Maritime-Hacking-Village/Badge-2025/firmware/firmware/assets/puke.gif

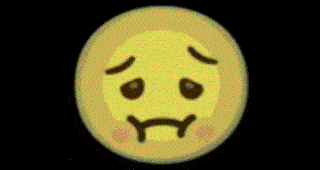
firmware/firmware/assets/puke.gif
