Maritime-Hacking-Village/Badge-2025/software/CAN_decoder.png

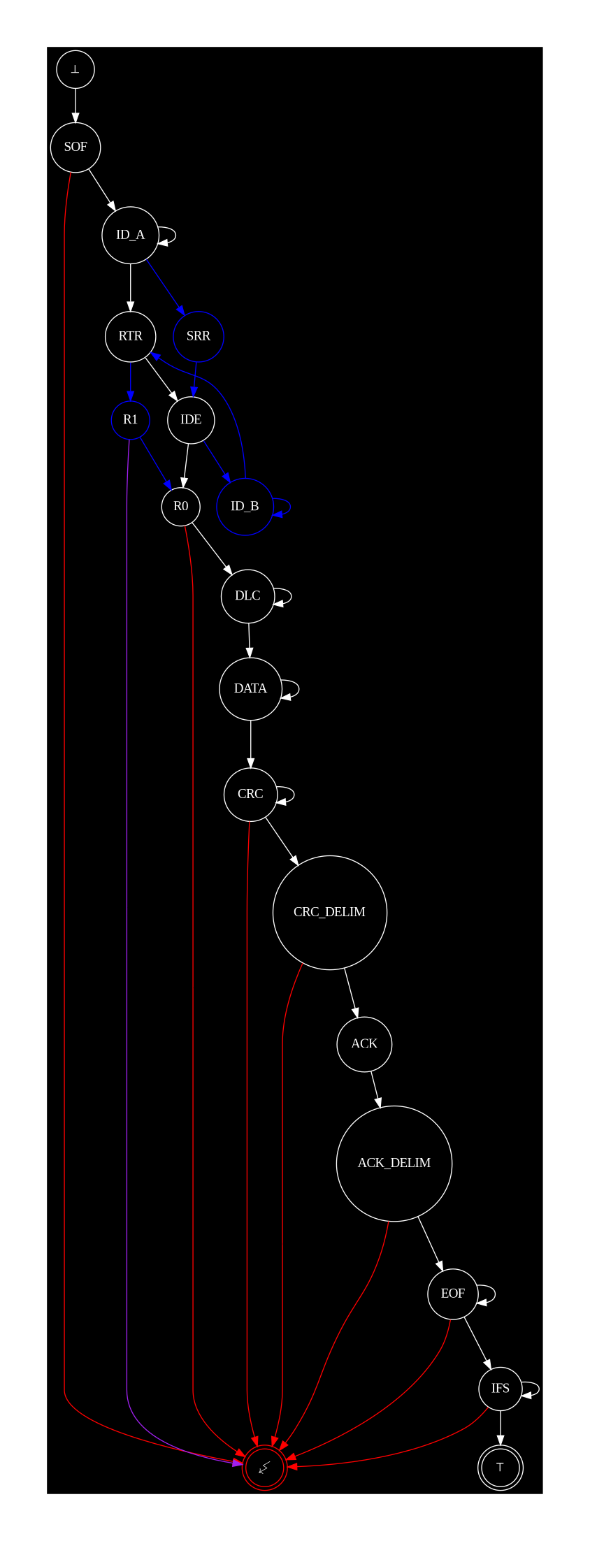
software/CAN_decoder.png
