Maritime-Hacking-Village/Badge-2025/KiCAD/DC33/fields2.xlsx

Refs | Color | Datasheet | Description | Footprint | Height | Label | Manufacturer | Manufacturer Part Number | Package | Power | Tolerance | Value
C1 |  | https://datasheets.kyocera-avx.com/KGM_X7R.pdf | CAP CER 0.1UF 25V X7R 0603 | Capacitor_SMD:C_0603_1608Metric |  |  | KYOCERA AVX | KGM15BR71E104KT | 0603 |  |  | 0.1uF
C10 |  | https://datasheets.kyocera-avx.com/KGM_X7R.pdf | CAP CER 0.1UF 25V X7R 0603 | Capacitor_SMD:C_0603_1608Metric |  |  | KYOCERA AVX | KGM15BR71E104KT | 0603 |  |  | 0.1uF
C11 |  | https://search.murata.co.jp/Ceramy/image/img/A01X/G101/ENG/GRM188R61E106MA73-01.pdf | CAP CER 10UF 25V X5R 0603 | Capacitor_SMD:C_0603_1608Metric |  |  | Murata Electronics | GRM188R61E106MA73J | 0603 |  |  | 10uF
C13 |  | https://product.tdk.com/system/files/dam/doc/product/capacitor/ceramic/mlcc/catalog/mlcc_automotive_general_en.pdf | CAP CER 4.7UF 6.3V X5R 0603 | Capacitor_SMD:C_0603_1608Metric |  |  | TDK Corporation | CGA3E1X5R0J475K080AC | 0603 |  |  | 4.7uF
C14 |  | https://datasheets.kyocera-avx.com/KGM_X7R.pdf | CAP CER 0.1UF 25V X7R 0603 | Capacitor_SMD:C_0603_1608Metric |  |  | KYOCERA AVX | KGM15BR71E104KT | 0603 |  |  | 0.1uF
C15 |  | https://search.murata.co.jp/Ceramy/image/img/A01X/G101/ENG/GRM188R61E106MA73-01.pdf | CAP CER 10UF 25V X5R 0603 | Capacitor_SMD:C_0603_1608Metric |  |  | Murata Electronics | GRM188R61E106MA73J | 0603 |  |  | 10uF
C16 |  | https://search.murata.co.jp/Ceramy/image/img/A01X/G101/ENG/GRM188R61E106MA73-01.pdf | CAP CER 10UF 25V X5R 0603 | Capacitor_SMD:C_0603_1608Metric |  |  | Murata Electronics | GRM188R61E106MA73J | 0603 |  |  | 10uF
C17 |  | https://www.yageo.com/upload/media/product/productsearch/datasheet/mlcc/UPY-GPHC_X7R_6.3V-to-250V_24.pdf | CAP CER 1UF 50V X7R 0603 | Capacitor_SMD:C_0603_1608Metric |  |  | Yageo | CC0603KRX7R9BB105 | 0603 |  |  | 1uF
C18 |  | https://datasheets.kyocera-avx.com/KGM_X7R.pdf | CAP CER 0.1UF 25V X7R 0603 | Capacitor_SMD:C_0603_1608Metric |  |  | KYOCERA AVX | KGM15BR71E104KT | 0603 |  |  | 0.1uF
C19 |  | https://www.yageo.com/upload/media/product/productsearch/datasheet/mlcc/UPY-GPHC_X7R_6.3V-to-250V_24.pdf | CAP CER 1UF 50V X7R 0603 | Capacitor_SMD:C_0603_1608Metric |  |  | Yageo | CC0603KRX7R9BB105 | 0603 |  |  | 1uF
C2 |  | https://datasheets.kyocera-avx.com/KGM_X7R.pdf | CAP CER 0.1UF 25V X7R 0603 | Capacitor_SMD:C_0603_1608Metric |  |  | KYOCERA AVX | KGM15BR71E104KT | 0603 |  |  | 0.1uF
C20 |  | https://www.yageo.com/upload/media/product/productsearch/datasheet/mlcc/UPY-GPHC_X7R_6.3V-to-250V_24.pdf | CAP CER 1UF 50V X7R 0603 | Capacitor_SMD:C_0603_1608Metric |  |  | Yageo | CC0603KRX7R9BB105 | 0603 |  |  | 1uF
C21 |  | https://www.yageo.com/upload/media/product/productsearch/datasheet/mlcc/UPY-GPHC_X7R_6.3V-to-250V_24.pdf | CAP CER 1UF 50V X7R 0603 | Capacitor_SMD:C_0603_1608Metric |  |  | Yageo | CC0603KRX7R9BB105 | 0603 |  |  | 1uF
C22 |  | https://www.yageo.com/upload/media/product/productsearch/datasheet/mlcc/UPY-GPHC_X7R_6.3V-to-250V_24.pdf | CAP CER 1UF 50V X7R 0603 | Capacitor_SMD:C_0603_1608Metric |  |  | Yageo | CC0603KRX7R9BB105 | 0603 |  |  | 1uF
C23 |  | https://search.murata.co.jp/Ceramy/image/img/A01X/G101/ENG/GRM188R61E106MA73-01.pdf | CAP CER 10UF 25V X5R 0603 | Capacitor_SMD:C_0603_1608Metric |  |  | Murata Electronics | GRM188R61E106MA73J | 0603 |  |  | 10uF
C24 |  | https://search.murata.co.jp/Ceramy/image/img/A01X/G101/ENG/GRM188R61E106MA73-01.pdf | CAP CER 10UF 25V X5R 0603 | Capacitor_SMD:C_0603_1608Metric |  |  | Murata Electronics | GRM188R61E106MA73J | 0603 |  |  | 10uF
C25 |  | https://datasheets.kyocera-avx.com/cx5r-KGM.pdf | CAP CER 47UF 6.3V X5R 0603 | Capacitor_SMD:C_0603_1608Metric |  |  | KYOCERA AVX | 06036D476MAT2A | 0603 |  |  | 47uF
C26 |  | https://datasheets.kyocera-avx.com/KGM_X7R.pdf | CAP CER 0.1UF 25V X7R 0603 | Capacitor_SMD:C_0603_1608Metric |  |  | KYOCERA AVX | KGM15BR71E104KT | 0603 |  |  | 0.1uF
C27 |  | https://datasheets.kyocera-avx.com/KGM_X7R.pdf | CAP CER 0.1UF 25V X7R 0603 | Capacitor_SMD:C_0603_1608Metric |  |  | KYOCERA AVX | KGM15BR71E104KT | 0603 |  |  | 0.1uF
C28 |  | https://www.yageo.com/upload/media/product/productsearch/datasheet/mlcc/UPY-GPHC_X7R_6.3V-to-250V_24.pdf | CAP CER 1UF 50V X7R 0603 | Capacitor_SMD:C_0603_1608Metric |  |  | Yageo | CC0603KRX7R9BB105 | 0603 |  |  | 1uF
C29 |  | https://www.yageo.com/upload/media/product/productsearch/datasheet/mlcc/UPY-GPHC_X7R_6.3V-to-250V_24.pdf | CAP CER 1UF 50V X7R 0603 | Capacitor_SMD:C_0603_1608Metric |  |  | Yageo | CC0603KRX7R9BB105 | 0603 |  |  | 1uF
C3 |  | https://datasheets.kyocera-avx.com/KGM_X7R.pdf | CAP CER 0.1UF 25V X7R 0603 | Capacitor_SMD:C_0603_1608Metric |  |  | KYOCERA AVX | KGM15BR71E104KT | 0603 |  |  | 0.1uF
C30 |  | https://datasheets.kyocera-avx.com/KGM_X7R.pdf | CAP CER 0.1UF 25V X7R 0603 | Capacitor_SMD:C_0603_1608Metric |  |  | KYOCERA AVX | KGM15BR71E104KT | 0603 |  |  | 0.1uF
C32 |  | https://www.yageo.com/upload/media/product/productsearch/datasheet/mlcc/UPY-GPHC_X7R_6.3V-to-250V_24.pdf | CAP CER 1UF 50V X7R 0603 | Capacitor_SMD:C_0603_1608Metric |  |  | Yageo | CC0603KRX7R9BB105 | 0603 |  |  | 1uF
C33 |  | https://datasheets.kyocera-avx.com/KGM_X7R.pdf | CAP CER 0.1UF 25V X7R 0603 | Capacitor_SMD:C_0603_1608Metric |  |  | KYOCERA AVX | KGM15BR71E104KT | 0603 |  |  | 0.1uF
C34 |  | https://www.yageo.com/en/Chart/Download/pdf/CC0603JPNPO9BN220 | CAP CER 22PF 50V C0G/NPO 0603 | Capacitor_SMD:C_0603_1608Metric |  |  | Yageo | CC0603JPNPO9BN220 | 0603 |  |  | 22pF
C35 |  | https://datasheets.kyocera-avx.com/KGM_X7R.pdf | CAP CER 0.1UF 25V X7R 0603 | Capacitor_SMD:C_0603_1608Metric |  |  | KYOCERA AVX | KGM15BR71E104KT | 0603 |  |  | 0.1uF
C36 |  | https://datasheets.kyocera-avx.com/KGM_X7R.pdf | CAP CER 0.1UF 25V X7R 0603 | Capacitor_SMD:C_0603_1608Metric |  |  | KYOCERA AVX | KGM15BR71E104KT | 0603 |  |  | 0.1uF
C37 |  | https://datasheets.kyocera-avx.com/KGM_X7R.pdf | CAP CER 0.1UF 25V X7R 0603 | Capacitor_SMD:C_0603_1608Metric |  |  | KYOCERA AVX | KGM15BR71E104KT | 0603 |  |  | 0.1uF
C39 |  | https://datasheets.kyocera-avx.com/KGM_X7R.pdf | CAP CER 0.1UF 25V X7R 0603 | Capacitor_SMD:C_0603_1608Metric |  |  | KYOCERA AVX | KGM15BR71E104KT | 0603 |  |  | 0.1uF
C4 |  | https://datasheets.kyocera-avx.com/KGM_X7R.pdf | CAP CER 0.1UF 25V X7R 0603 | Capacitor_SMD:C_0603_1608Metric |  |  | KYOCERA AVX | KGM15BR71E104KT | 0603 |  |  | 0.1uF
C40 |  | https://datasheets.kyocera-avx.com/KGM_X7R.pdf | CAP CER 0.1UF 25V X7R 0603 | Capacitor_SMD:C_0603_1608Metric |  |  | KYOCERA AVX | KGM15BR71E104KT | 0603 |  |  | 0.1uF
C42 |  | https://datasheets.kyocera-avx.com/KGM_X7R.pdf | CAP CER 0.1UF 25V X7R 0603 | Capacitor_SMD:C_0603_1608Metric |  |  | KYOCERA AVX | KGM15BR71E104KT | 0603 |  |  | 0.1uF
C43 |  | https://datasheets.kyocera-avx.com/KGM_X7R.pdf | CAP CER 0.1UF 25V X7R 0603 | Capacitor_SMD:C_0603_1608Metric |  |  | KYOCERA AVX | KGM15BR71E104KT | 0603 |  |  | 0.1uF
C44 |  | https://www.yageo.com/upload/media/product/productsearch/datasheet/mlcc/UPY-GPHC_X7R_6.3V-to-250V_24.pdf | CAP CER 1UF 50V X7R 0603 | Capacitor_SMD:C_0603_1608Metric |  |  | Yageo | CC0603KRX7R9BB105 | 0603 |  |  | 1uF
C45 |  | https://datasheets.kyocera-avx.com/KGM_X7R.pdf | CAP CER 0.1UF 25V X7R 0603 | Capacitor_SMD:C_0603_1608Metric |  |  | KYOCERA AVX | KGM15BR71E104KT | 0603 |  |  | 0.1uF
C46 |  | https://www.yageo.com/upload/media/product/productsearch/datasheet/mlcc/UPY-GPHC_X7R_6.3V-to-250V_24.pdf | CAP CER 1UF 50V X7R 0603 | Capacitor_SMD:C_0603_1608Metric |  |  | Yageo | CC0603KRX7R9BB105 | 0603 |  |  | 1uF
C47 |  | https://datasheets.kyocera-avx.com/KGM_X7R.pdf | CAP CER 0.1UF 25V X7R 0603 | Capacitor_SMD:C_0603_1608Metric |  |  | KYOCERA AVX | KGM15BR71E104KT | 0603 |  |  | 0.1uF
C48 |  | https://datasheets.kyocera-avx.com/KGM_X7R.pdf | CAP CER 0.1UF 25V X7R 0603 | Capacitor_SMD:C_0603_1608Metric |  |  | KYOCERA AVX | KGM15BR71E104KT | 0603 |  |  | 0.1uF
C49 |  | https://www.yageo.com/upload/media/product/productsearch/datasheet/mlcc/UPY-GPHC_X7R_6.3V-to-250V_24.pdf | CAP CER 1UF 50V X7R 0603 | Capacitor_SMD:C_0603_1608Metric |  |  | Yageo | CC0603KRX7R9BB105 | 0603 |  |  | 1uF
C5 |  | https://datasheets.kyocera-avx.com/KGM_X7R.pdf | CAP CER 0.1UF 25V X7R 0603 | Capacitor_SMD:C_0603_1608Metric |  |  | KYOCERA AVX | KGM15BR71E104KT | 0603 |  |  | 0.1uF
C50 |  | https://www.yageo.com/upload/media/product/productsearch/datasheet/mlcc/UPY-GPHC_X7R_6.3V-to-250V_24.pdf | CAP CER 1UF 50V X7R 0603 | Capacitor_SMD:C_0603_1608Metric |  |  | Yageo | CC0603KRX7R9BB105 | 0603 |  |  | 1uF
C51 |  | https://datasheets.kyocera-avx.com/KGM_X7R.pdf | CAP CER 0.1UF 25V X7R 0603 | Capacitor_SMD:C_0603_1608Metric |  |  | KYOCERA AVX | KGM15BR71E104KT | 0603 |  |  | 0.1uF
C52 |  | https://datasheets.kyocera-avx.com/KGM_X7R.pdf | CAP CER 0.1UF 25V X7R 0603 | Capacitor_SMD:C_0603_1608Metric |  |  | KYOCERA AVX | KGM15BR71E104KT | 0603 |  |  | 0.1uF
C53 |  | https://www.yageo.com/upload/media/product/productsearch/datasheet/mlcc/UPY-GPHC_X7R_6.3V-to-250V_24.pdf | CAP CER 1UF 50V X7R 0603 | Capacitor_SMD:C_0603_1608Metric |  |  | Yageo | CC0603KRX7R9BB105 | 0603 |  |  | 1uF
C54 |  | https://www.yageo.com/upload/media/product/productsearch/datasheet/mlcc/UPY-GPHC_X7R_6.3V-to-250V_24.pdf | CAP CER 1UF 50V X7R 0603 | Capacitor_SMD:C_0603_1608Metric |  |  | Yageo | CC0603KRX7R9BB105 | 0603 |  |  | 1uF
C55 |  | https://datasheets.kyocera-avx.com/KGM_X7R.pdf | CAP CER 0.1UF 25V X7R 0603 | Capacitor_SMD:C_0603_1608Metric |  |  | KYOCERA AVX | KGM15BR71E104KT | 0603 |  |  | 0.1uF
C56 |  | https://www.yageo.com/upload/media/product/productsearch/datasheet/mlcc/UPY-GPHC_X7R_6.3V-to-250V_24.pdf | CAP CER 1UF 50V X7R 0603 | Capacitor_SMD:C_0603_1608Metric |  |  | Yageo | CC0603KRX7R9BB105 | 0603 |  |  | 1uF
C57 |  | https://search.murata.co.jp/Ceramy/image/img/A01X/G101/ENG/GRM188R61E106MA73-01.pdf | CAP CER 10UF 25V X5R 0603 | Capacitor_SMD:C_0603_1608Metric |  |  | Murata Electronics | GRM188R61E106MA73J | 0603 |  |  | 10uF
C58 |  | https://www.yageo.com/upload/media/product/productsearch/datasheet/mlcc/UPY-GPHC_X7R_6.3V-to-250V_24.pdf | CAP CER 1UF 50V X7R 0603 | Capacitor_SMD:C_0603_1608Metric |  |  | Yageo | CC0603KRX7R9BB105 | 0603 |  |  | 1uF
C59 |  | https://product.tdk.com/system/files/dam/doc/product/capacitor/ceramic/mlcc/catalog/mlcc_commercial_general_en.pdf | CAP CER 22UF 10V X5R 0603 | Capacitor_SMD:C_0603_1608Metric |  |  | TDK Corporation | C1608X5R1A226M080AC | 0603 |  |  | 22uF
C6 |  | https://datasheets.kyocera-avx.com/KGM_X7R.pdf | CAP CER 0.1UF 25V X7R 0603 | Capacitor_SMD:C_0603_1608Metric |  |  | KYOCERA AVX | KGM15BR71E104KT | 0603 |  |  | 0.1uF
C60 |  | https://product.tdk.com/system/files/dam/doc/product/capacitor/ceramic/mlcc/catalog/mlcc_automotive_general_en.pdf | CAP CER 4.7UF 6.3V X5R 0603 | Capacitor_SMD:C_0603_1608Metric |  |  | TDK Corporation | CGA3E1X5R0J475K080AC | 0603 |  |  | 4.7uF
C61 |  | https://www.yageo.com/upload/media/product/productsearch/datasheet/mlcc/UPY-GPHC_X7R_6.3V-to-250V_24.pdf | CAP CER 0.047UF 50V X7R 0603 | Capacitor_SMD:C_0603_1608Metric |  |  | Yageo | CC0603KRX7R9BB473 | 0603 |  |  | 0.047uF
C62 |  | https://datasheets.kyocera-avx.com/cx5r-KGM.pdf | CAP CER 47UF 6.3V X5R 0603 | Capacitor_SMD:C_0603_1608Metric |  |  | KYOCERA AVX | 06036D476MAT2A | 0603 |  |  | 47uF
C63 |  | https://datasheets.kyocera-avx.com/KGM_X7R.pdf | CAP CER 0.1UF 25V X7R 0603 | Capacitor_SMD:C_0603_1608Metric |  |  | KYOCERA AVX | KGM15BR71E104KT | 0603 |  |  | 0.1uF
C64 |  | https://datasheets.kyocera-avx.com/KGM_X7R.pdf | CAP CER 0.1UF 25V X7R 0603 | Capacitor_SMD:C_0603_1608Metric |  |  | KYOCERA AVX | KGM15BR71E104KT | 0603 |  |  | 0.1uF
C65 |  | https://www.yageo.com/upload/media/product/productsearch/datasheet/mlcc/UPY-GPHC_X7R_6.3V-to-250V_24.pdf | CAP CER 1UF 50V X7R 0603 | Capacitor_SMD:C_0603_1608Metric |  |  | Yageo | CC0603KRX7R9BB105 | 0603 |  |  | 1uF
C66 |  | https://www.yageo.com/en/Chart/Download/pdf/CC0603JPNPO9BN220 | CAP CER 22PF 50V C0G/NPO 0603 | Capacitor_SMD:C_0603_1608Metric |  |  | Yageo | CC0603JPNPO9BN220 | 0603 |  |  | 22pF
C7 |  | https://datasheets.kyocera-avx.com/KGM_X7R.pdf | CAP CER 0.1UF 25V X7R 0603 | Capacitor_SMD:C_0603_1608Metric |  |  | KYOCERA AVX | KGM15BR71E104KT | 0603 |  |  | 0.1uF
C8 |  | https://datasheets.kyocera-avx.com/KGM_X7R.pdf | CAP CER 0.1UF 25V X7R 0603 | Capacitor_SMD:C_0603_1608Metric |  |  | KYOCERA AVX | KGM15BR71E104KT | 0603 |  |  | 0.1uF
C9 |  | https://datasheets.kyocera-avx.com/KGM_X7R.pdf | CAP CER 0.1UF 25V X7R 0603 | Capacitor_SMD:C_0603_1608Metric |  |  | KYOCERA AVX | KGM15BR71E104KT | 0603 |  |  | 0.1uF
D1 | ORANGE | https://www.kingbrightusa.com/images/catalog/SPEC/APT1608LSECK-J4-PRV.pdf | LED ORANGE CLEAR 2SMD | LED_SMD:LED_0603_1608Metric |  | BATT | Kingbright | APT1608LSECK/J4-PRV | 0603 |  |  | 1.8V/2MA ORANGE
D2 | GREEN | https://www.kingbrightusa.com/images/catalog/SPEC/APT1608LZGCK.pdf | LED GREEN CLEAR 2SMD | LED_SMD:LED_0603_1608Metric |  | CAN_TX | Kingbright | APT1608LZGCK | 0603 |  |  | 2.64V/2MA GREEN
D3 | ORANGE | https://www.kingbrightusa.com/images/catalog/SPEC/APT1608LSECK-J4-PRV.pdf | LED ORANGE CLEAR 2SMD | LED_SMD:LED_0603_1608Metric |  | DIFF_RX | Kingbright | APT1608LSECK/J4-PRV | 0603 |  |  | 1.8V/2MA ORANGE
D4 | ORANGE | https://www.kingbrightusa.com/images/catalog/SPEC/APT1608LSECK-J4-PRV.pdf | LED ORANGE CLEAR 2SMD | LED_SMD:LED_0603_1608Metric |  | RX_TX_TIE | Kingbright | APT1608LSECK/J4-PRV | 0603 |  |  | 1.8V/2MA ORANGE
D5 | ORANGE | https://www.kingbrightusa.com/images/catalog/SPEC/APT1608LSECK-J4-PRV.pdf | LED ORANGE CLEAR 2SMD | LED_SMD:LED_0603_1608Metric |  | CAN_RX | Kingbright | APT1608LSECK/J4-PRV | 0603 |  |  | 1.8V/2MA ORANGE
D6 |  | https://www.onsemi.com/pub_link/Collateral/NUP2105L-D.PDF | TVS DIODE 24VWM 44VC SOT233 | Package_TO_SOT_SMD:SOT-23 |  |  | onsemi | NUP2105LT1G |  |  |  | NUP2105L
F1 |  | https://www.bourns.com/sitefinity/status | PTC RESET FUSE 60V 300MA 2SMD | Library:MFSM0302 | 3.18 |  | Bourns | MF-SM030-2 |  |  |  | MF-SM030-2
F2 |  | https://www.bourns.com/sitefinity/status | PTC RESET FUSE 60V 300MA 2SMD | Library:MFSM0302 | 3.18 |  | Bourns | MF-SM030-2 |  |  |  | MF-SM030-2
J1 |  | https://s3.amazonaws.com/catalogspreads-pdf/PAGE123%20.100%20SFH11%20SERIES%20FEMALE%20HDR%20ST%20RA.pdf | CONN HDR 6POS 0.1 GOLD PCB | Library:SFH11-NBPC-D03-ST-BK | 9.1 |  | Sullins Connector Solutions | SFH11-NBPC-D03-ST-BK |  |  |  | SAO
J2 |  | https://www.te.com/commerce/DocumentDelivery/DDEController?Action=srchrtrv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 | TERM BLK 3P SIDE ENT 2.54MM PCB | Library:2828343 | 10 |  | TE Connectivity AMP Connectors | 282834-3 |  |  |  | 282834-3
J3 |  | https://www.te.com/commerce/DocumentDelivery/DDEController?Action=srchrtrv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 | TERM BLK 3P SIDE ENT 2.54MM PCB | Library:2828343 | 10 |  | TE Connectivity AMP Connectors | 282834-3 |  |  |  | 282834-3
J4 |  | https://www.jst-mfg.com/product/pdf/eng/ePH.pdf | CONN HEADER R/A 2POS 2MM | Library:SHDRRA2W50P0X200_1X2_590X760X480P | 4.8 |  | JST (JAPAN SOLDERLESS TERMINALS) | S2B-PH-K-S(LF)(SN) |  |  |  | S2B-PH-K-S(LF)(SN)
L1 |  | https://www.coilcraft.com/pdfs/xal7030.pdf | FIXED IND 2.2UH 12.9A 15.07MOHM | Library:XAL7030272MEB | 3.1 |  | Coilcraft | XAL7030-222MEC |  |  |  | XAL7030-222MEC
NEO_1 |  | https://www.lcsc.com/datasheet/lcsc_datasheet_2412051755_Worldsemi-WS2812B-V5-W_C2874885.pdf | INTELLIGENT CONTROL RGB LED 5050 WHITE | Library:SOL320P540X170-4N | 1.7 |  | WorldSemi | WS2812B-V5/W | 5050 |  |  | WS2812B-V5/W
NEO_2 |  | https://www.lcsc.com/datasheet/lcsc_datasheet_2412051755_Worldsemi-WS2812B-V5-W_C2874885.pdf | INTELLIGENT CONTROL RGB LED 5050 WHITE | Library:SOL320P540X170-4N | 1.7 |  | WorldSemi | WS2812B-V5/W | 5050 |  |  | WS2812B-V5/W
NEO_3 |  | https://www.lcsc.com/datasheet/lcsc_datasheet_2412051755_Worldsemi-WS2812B-V5-W_C2874885.pdf | INTELLIGENT CONTROL RGB LED 5050 WHITE | Library:SOL320P540X170-4N | 1.7 |  | WorldSemi | WS2812B-V5/W | 5050 |  |  | WS2812B-V5/W
NEO_4 |  | https://www.lcsc.com/datasheet/lcsc_datasheet_2412051755_Worldsemi-WS2812B-V5-W_C2874885.pdf | INTELLIGENT CONTROL RGB LED 5050 WHITE | Library:SOL320P540X170-4N | 1.7 |  | WorldSemi | WS2812B-V5/W | 5050 |  |  | WS2812B-V5/W
NEO_5 |  | https://www.lcsc.com/datasheet/lcsc_datasheet_2412051755_Worldsemi-WS2812B-V5-W_C2874885.pdf | INTELLIGENT CONTROL RGB LED 5050 WHITE | Library:SOL320P540X170-4N | 1.7 |  | WorldSemi | WS2812B-V5/W | 5050 |  |  | WS2812B-V5/W
NEO_6 |  | https://www.lcsc.com/datasheet/lcsc_datasheet_2412051755_Worldsemi-WS2812B-V5-W_C2874885.pdf | INTELLIGENT CONTROL RGB LED 5050 WHITE | Library:SOL320P540X170-4N | 1.7 |  | WorldSemi | WS2812B-V5/W | 5050 |  |  | WS2812B-V5/W
NEO_7 |  | https://www.lcsc.com/datasheet/lcsc_datasheet_2412051755_Worldsemi-WS2812B-V5-W_C2874885.pdf | INTELLIGENT CONTROL RGB LED 5050 WHITE | Library:SOL320P540X170-4N | 1.7 |  | WorldSemi | WS2812B-V5/W | 5050 |  |  | WS2812B-V5/W
NEO_8 |  | https://www.lcsc.com/datasheet/lcsc_datasheet_2412051755_Worldsemi-WS2812B-V5-W_C2874885.pdf | INTELLIGENT CONTROL RGB LED 5050 WHITE | Library:SOL320P540X170-4N | 1.7 |  | WorldSemi | WS2812B-V5/W | 5050 |  |  | WS2812B-V5/W
NEO_9 |  | https://www.lcsc.com/datasheet/lcsc_datasheet_2412051755_Worldsemi-WS2812B-V5-W_C2874885.pdf | INTELLIGENT CONTROL RGB LED 5050 WHITE | Library:SOL320P540X170-4N | 1.7 |  | WorldSemi | WS2812B-V5/W | 5050 |  |  | WS2812B-V5/W
Q1 |  | https://www.onsemi.com/pub/Collateral/FDN359BN-D.pdf | MOSFET N-CH 30V 2.7A SUPERSOT3 | Library:SOT95P251X112-3N | 1.12 |  | onsemi | FDN359BN |  |  |  | FDN359BN
Q2 |  | http://www.ti.com/lit/gpn/csd17576q5b | MOSFET N-CH 30V 100A 8VSON | Package_TO_SOT_SMD:TDSON-8-1 |  |  | Texas Instruments | CSD17576Q5B |  |  |  | CSD17576Q5B
Q3 |  | http://www.ti.com/lit/gpn/csd17576q5b | MOSFET N-CH 30V 100A 8VSON | Package_TO_SOT_SMD:TDSON-8-1 |  |  | Texas Instruments | CSD17576Q5B |  |  |  | CSD17576Q5B
R1 |  | https://www.te.com/usa-en/product-1622960-1.datasheet.pdf | RES SMD 4.7K OHM 1% 1/10W 0603 | Resistor_SMD:R_0603_1608Metric |  |  | TE Connectivity Passive Product | CRG0603F4K7 |  |  | 1% | 4k7
R10 |  | https://www.te.com/commerce/DocumentDelivery/DDEController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 | RES SMD 10K OHM 1% 1/10W 0603 | Resistor_SMD:R_0603_1608Metric |  |  | TE Connectivity Passive Product | CRG0603F10K |  |  | 1% | 10k
R11 |  | https://industrial.panasonic.com/cdbs/www-data/pdf/RDA0000/AOA0000C304.pdf | RES SMD 100K OHM 1% 1/10W 0603 | Resistor_SMD:R_0603_1608Metric |  |  | Panasonic Electronic Components | ERJ-3EKF1003V |  |  | 1% | 100k
R12 |  | https://industrial.panasonic.com/cdbs/www-data/pdf/RDA0000/AOA0000C304.pdf | RES SMD 200K OHM 1% 1/10W 0603 | Resistor_SMD:R_0603_1608Metric |  |  | Panasonic Electronic Components | ERJ-3EKF2003V |  |  | 1% | 200k
R13 |  | https://www.te.com/commerce/DocumentDelivery/DDEController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 | RES SMD 10K OHM 1% 1/10W 0603 | Resistor_SMD:R_0603_1608Metric |  |  | TE Connectivity Passive Product | CRG0603F10K |  |  | 1% | 10k
R14 |  | https://www.yageo.com/upload/media/product/products/datasheet/rchip/PYu-RC_Group_51_RoHS_L_12.pdf | RES 220 OHM 1% 1/2W 1210 | Resistor_SMD:R_1210_3225Metric |  |  | Yageo | RC1210FR-07220RL | 1210 | 0.5W | 1% | 220
R15 |  | https://industrial.panasonic.com/cdbs/www-data/pdf/RDA0000/AOA0000C304.pdf | RES SMD 100K OHM 1% 1/10W 0603 | Resistor_SMD:R_0603_1608Metric |  |  | Panasonic Electronic Components | ERJ-3EKF1003V |  |  | 1% | 100k
R16 |  | https://industrial.panasonic.com/cdbs/www-data/pdf/RDA0000/AOA0000C301.pdf | RES SMD 470 OHM 5% 1/10W 0603 | Resistor_SMD:R_0603_1608Metric |  |  | Panasonic Electronic Components | ERJ-3GEYJ471V |  |  | 1% | 470
R17 |  | https://industrial.panasonic.com/cdbs/www-data/pdf/RDA0000/AOA0000C301.pdf | RES SMD 0 OHM JUMPER 1/10W 0603 | Resistor_SMD:R_0603_1608Metric |  |  | Panasonic Electronic Components | ERJ-3GEY0R00V |  |  | 1% | 0
R18 |  | https://industrial.panasonic.com/cdbs/www-data/pdf/AOC0000/AOC0000C14.pdf | RES ARRAY 4 RES 10K OHM 1206 | Library:RESPACK_4X0603 |  |  | Panasonic Electronic Components | EXB-38V103JV |  |  | 1% | 10k
R19 |  | https://www.yageo.com/upload/media/product/products/datasheet/rchip/PYu-RC_Group_51_RoHS_L_12.pdf | RES 240 OHM 1% 1/10W 0603 | Resistor_SMD:R_0603_1608Metric |  |  | Yageo | RC0603FR-07240RL |  |  | 1% | 240
R2 |  | https://industrial.panasonic.com/cdbs/www-data/pdf/RDA0000/AOA0000C301.pdf | RES SMD 0 OHM JUMPER 1/10W 0603 | Resistor_SMD:R_0603_1608Metric |  |  | Panasonic Electronic Components | ERJ-3GEY0R00V |  |  | 1% | 0
R20 |  | https://industrial.panasonic.com/cdbs/www-data/pdf/AOC0000/AOC0000C14.pdf | RES ARRAY 4 RES 10K OHM 1206 | Library:RESPACK_4X0603 |  |  | Panasonic Electronic Components | EXB-38V103JV |  |  | 1% | 10k
R21 |  | https://www.te.com/commerce/DocumentDelivery/DDEController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 | RES SMD 10K OHM 1% 1/10W 0603 | Resistor_SMD:R_0603_1608Metric |  |  | TE Connectivity Passive Product | CRG0603F10K |  |  | 1% | 10k
R22 |  | https://www.te.com/commerce/DocumentDelivery/DDEController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 | RES SMD 10K OHM 1% 1/10W 0603 | Resistor_SMD:R_0603_1608Metric |  |  | TE Connectivity Passive Product | CRG0603F10K |  |  | 1% | 10k
R23 |  | https://www.vishay.com/docs/20035/dcrcwe3.pdf | RES SMD 5.23K OHM 1% 1/10W 0603 | Resistor_SMD:R_0603_1608Metric |  |  | Vishay Dale | CRCW06035K23FKEA |  |  | 1% | 5.23k
R24 |  | https://www.te.com/commerce/DocumentDelivery/DDEController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 | RES SMD 10K OHM 1% 1/10W 0603 | Resistor_SMD:R_0603_1608Metric |  |  | TE Connectivity Passive Product | CRG0603F10K |  |  | 1% | 10k
R25 |  | https://www.te.com/usa-en/product-2-2176340-1.datasheet.pdf | RES 2.2K OHM 5% 1/10W 0603 | Resistor_SMD:R_0603_1608Metric |  |  | TE Connectivity Passive Product | CRGCQ0603J2K2 |  |  | 1% | 2.2k
R26 |  | https://www.yageo.com/upload/media/product/products/datasheet/rchip/PYu-RC_Group_51_RoHS_L_12.pdf | RES 240 OHM 1% 1/10W 0603 | Resistor_SMD:R_0603_1608Metric |  |  | Yageo | RC0603FR-07240RL |  |  | 1% | 240
R27 |  | https://industrial.panasonic.com/cdbs/www-data/pdf/RDA0000/AOA0000C304.pdf | RES SMD 750 OHM 1% 1/10W 0603 | Resistor_SMD:R_0603_1608Metric |  |  | Panasonic Electronic Components | ERJ-3EKF7500V |  |  | 1% | 750
R28 |  | https://fscdn.rohm.com/en/products/databook/datasheet/passive/resistor/chip_resistor/ktr-e.pdf | RES SMD 5.1M OHM 1% 1/10W 0603 | Resistor_SMD:R_0603_1608Metric |  |  | Rohm Semiconductor | KTR03EZPF5104 |  |  | 1% | 5.1M
R29 |  | https://www.yageo.com/upload/media/product/products/datasheet/rchip/PYu-RC_Group_51_RoHS_L_12.pdf | RES 330 OHM 1% 1/10W 0603 | Resistor_SMD:R_0603_1608Metric |  |  | Yageo | RC0603FR-07330RL |  |  | 1% | 330
R3 |  | https://www.te.com/usa-en/product-1622960-1.datasheet.pdf | RES SMD 4.7K OHM 1% 1/10W 0603 | Resistor_SMD:R_0603_1608Metric |  |  | TE Connectivity Passive Product | CRG0603F4K7 |  |  | 1% | 4k7
R30 |  | https://fscdn.rohm.com/en/products/databook/datasheet/passive/resistor/chip_resistor/ktr-e.pdf | RES SMD 5.1M OHM 1% 1/10W 0603 | Resistor_SMD:R_0603_1608Metric |  |  | Rohm Semiconductor | KTR03EZPF5104 |  |  | 1% | 5.1M
R31 |  | https://www.te.com/commerce/DocumentDelivery/DDEController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 | RES SMD 10K OHM 1% 1/10W 0603 | Resistor_SMD:R_0603_1608Metric |  |  | TE Connectivity Passive Product | CRG0603F10K |  |  | 1% | 10k
R32 |  | https://industrial.panasonic.com/cdbs/www-data/pdf/RDA0000/AOA0000C304.pdf | RES SMD 750 OHM 1% 1/10W 0603 | Resistor_SMD:R_0603_1608Metric |  |  | Panasonic Electronic Components | ERJ-3EKF7500V |  |  | 1% | 750
R33 |  | https://industrial.panasonic.com/cdbs/www-data/pdf/RDA0000/AOA0000C304.pdf | RES SMD 750 OHM 1% 1/10W 0603 | Resistor_SMD:R_0603_1608Metric |  |  | Panasonic Electronic Components | ERJ-3EKF7500V |  |  | 1% | 750
R35 |  | https://www.te.com/commerce/DocumentDelivery/DDEController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 | RES SMD 10K OHM 1% 1/10W 0603 | Resistor_SMD:R_0603_1608Metric |  |  | TE Connectivity Passive Product | CRG0603F10K |  |  | 1% | 10k
R36 |  | https://industrial.panasonic.com/cdbs/www-data/pdf/RDA0000/AOA0000C304.pdf | RES SMD 750 OHM 1% 1/10W 0603 | Resistor_SMD:R_0603_1608Metric |  |  | Panasonic Electronic Components | ERJ-3EKF7500V |  |  | 1% | 750
R37 |  | https://www.mouser.es/datasheet/2/418/9/ENG_DS_1773204_5_1-3346398.pdf | RES 3540 13R 1% | Library:RES_3540 |  |  | TE Connectivity | 354013RFT | 3540 | 4W | 1% | 13
R38 |  | https://www.yageo.com/upload/media/product/products/datasheet/rchip/PYu-RC_Group_51_RoHS_L_12.pdf | RES 51K OHM 1% 1/10W 0603 | Resistor_SMD:R_0603_1608Metric |  |  | Yageo | RC0603FR-0751KL |  |  | 1% | 51k
R39 |  | https://www.yageo.com/upload/media/product/products/datasheet/rchip/PYu-RC_Group_51_RoHS_L_12.pdf | RES 51K OHM 1% 1/10W 0603 | Resistor_SMD:R_0603_1608Metric |  |  | Yageo | RC0603FR-0751KL |  |  | 1% | 51k
R4 |  | https://industrial.panasonic.com/cdbs/www-data/pdf/AOC0000/AOC0000C14.pdf | RES ARRAY 4 RES 10K OHM 1206 | Library:RESPACK_4X0603 |  |  | Panasonic Electronic Components | EXB-38V103JV |  |  | 1% | 10k
R40 |  | https://www.mouser.es/datasheet/2/418/9/ENG_DS_1773204_5_1-3346398.pdf | RES 3540 13R 1% | Library:RES_3540 |  |  | TE Connectivity | 354013RFT | 3540 | 4W | 1% | 13
R41 |  | https://www.te.com/commerce/DocumentDelivery/DDEController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 | RES SMD 10K OHM 1% 1/10W 0603 | Resistor_SMD:R_0603_1608Metric |  |  | TE Connectivity Passive Product | CRG0603F10K |  |  | 1% | 10k
R42 |  | https://www.te.com/commerce/DocumentDelivery/DDEController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 | RES SMD 10K OHM 1% 1/10W 0603 | Resistor_SMD:R_0603_1608Metric |  |  | TE Connectivity Passive Product | CRG0603F10K |  |  | 1% | 10k
R43 |  | https://www.te.com/commerce/DocumentDelivery/DDEController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 | RES SMD 10K OHM 1% 1/10W 0603 | Resistor_SMD:R_0603_1608Metric |  |  | TE Connectivity Passive Product | CRG0603F10K |  |  | 1% | 10k
R44 |  | https://industrial.panasonic.com/cdbs/www-data/pdf/RDA0000/AOA0000C304.pdf | RES SMD 51.1 OHM 1% 1/10W 0603 | Resistor_SMD:R_0603_1608Metric |  |  | Panasonic Electronic Components | ERJ-3EKF51R1V |  |  | 1% | 51.1
R45 |  | https://industrial.panasonic.com/cdbs/www-data/pdf/RDM0000/AOA0000C307.pdf | RES SMD 1.27KOHM 0.1% 1/10W 0603 | Resistor_SMD:R_0603_1608Metric |  |  | Panasonic Electronic Components | ERA-3AEB1271V |  |  | 0.1% | 1.27k
R46 |  | https://industrial.panasonic.com/cdbs/www-data/pdf/RDM0000/AOA0000C307.pdf | RES SMD 3.16KOHM 0.1% 1/10W 0603 | Resistor_SMD:R_0603_1608Metric |  |  | Panasonic Electronic Components | ERA-3AEB3161V |  |  | 0.1% | 3.16k
R47 |  | https://industrial.panasonic.com/cdbs/www-data/pdf/RDM0000/AOA0000C307.pdf | RES SMD 3.16KOHM 0.1% 1/10W 0603 | Resistor_SMD:R_0603_1608Metric |  |  | Panasonic Electronic Components | ERA-3AEB3161V |  |  | 0.1% | 3.16k
R48 |  | https://industrial.panasonic.com/cdbs/www-data/pdf/RDM0000/AOA0000C328.pdf | RES SMD 1.87K OHM 0.1% 1/5W 0603 | Resistor_SMD:R_0603_1608Metric |  |  | Panasonic Electronic Components | ERJ-PB3B1871V |  |  | 0.1% | 1.87k
R49 |  | https://industrial.panasonic.com/cdbs/www-data/pdf/RDA0000/AOA0000C304.pdf | RES SMD 100 OHM 1% 1/10W 0603 | Resistor_SMD:R_0603_1608Metric |  |  | Panasonic Electronic Components | ERJ-3EKF1000V |  |  | 1% | 100
R5 |  | https://industrial.panasonic.com/cdbs/www-data/pdf/AOC0000/AOC0000C14.pdf | RES ARRAY 4 RES 22 OHM 1206 | Library:RESPACK_4X0603 |  |  | Panasonic Electronic Components | EXB-38V220JV |  |  | 1% | 22
R50 |  | https://industrial.panasonic.com/cdbs/www-data/pdf/RDN0000/AOA0000C313.pdf | RES SMD 1 OHM 1% 1/4W 0603 | Resistor_SMD:R_0603_1608Metric |  |  | Panasonic Electronic Components | ERJ-3BQF1R0V |  |  | 1% | 1
R51 |  | https://www.te.com/commerce/DocumentDelivery/DDEController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 | RES SMD 10K OHM 1% 1/10W 0603 | Resistor_SMD:R_0603_1608Metric |  |  | TE Connectivity Passive Product | CRG0603F10K |  |  | 1% | 10k
R52 |  | https://industrial.panasonic.com/cdbs/www-data/pdf/RDM0000/AOA0000C307.pdf | RES SMD 3.16KOHM 0.1% 1/10W 0603 | Resistor_SMD:R_0603_1608Metric |  |  | Panasonic Electronic Components | ERA-3AEB3161V |  |  | 0.1% | 3.16k
R53 |  | https://industrial.panasonic.com/cdbs/www-data/pdf/RDM0000/AOA0000C307.pdf | RES SMD 619 OHM 0.1% 1/10W 0603 | Resistor_SMD:R_0603_1608Metric |  |  | Panasonic Electronic Components | ERA-3AEB6190V |  |  | 0.1% | 619
R54 |  | https://industrial.panasonic.com/cdbs/www-data/pdf/RDA0000/AOA0000C304.pdf | RES SMD 196 OHM 1% 1/10W 0603 | Resistor_SMD:R_0603_1608Metric |  |  | Panasonic Electronic Components | ERJ-3EKF1960V |  |  | 1% | 196
R55 |  | https://industrial.panasonic.com/cdbs/www-data/pdf/RDM0000/AOA0000C307.pdf | RES SMD 3.16KOHM 0.1% 1/10W 0603 | Resistor_SMD:R_0603_1608Metric |  |  | Panasonic Electronic Components | ERA-3AEB3161V |  |  | 0.1% | 3.16k
R56 |  | https://industrial.panasonic.com/cdbs/www-data/pdf/RDA0000/AOA0000C304.pdf | RES SMD 147 OHM 1% 1/10W 0603 | Resistor_SMD:R_0603_1608Metric |  |  | Panasonic Electronic Components | ERJ-3EKF1470V |  |  | 1% | 147
R57 |  | https://industrial.panasonic.com/cdbs/www-data/pdf/AOC0000/AOC0000C14.pdf | RES ARRAY 4 RES 10K OHM 1206 | Library:RESPACK_4X0603 |  |  | Panasonic Electronic Components | EXB-38V103JV |  |  | 1% | 10k
R58 |  | https://industrial.panasonic.com/cdbs/www-data/pdf/AOC0000/AOC0000C14.pdf | RES ARRAY 4 RES 10K OHM 1206 | Library:RESPACK_4X0603 |  |  | Panasonic Electronic Components | EXB-38V103JV |  |  | 1% | 10k
R59 |  | https://industrial.panasonic.com/cdbs/www-data/pdf/RDA0000/AOA0000C304.pdf | RES SMD 330 OHM 1% 1/10W 0603 | Resistor_SMD:R_0603_1608Metric |  |  | Panasonic Electronic Components | ERJ-3EKF3300V |  |  | 1% | 330
R6 |  | https://industrial.panasonic.com/cdbs/www-data/pdf/RDA0000/AOA0000C304.pdf | RES SMD 100K OHM 1% 1/10W 0603 | Resistor_SMD:R_0603_1608Metric |  |  | Panasonic Electronic Components | ERJ-3EKF1003V |  |  | 1% | 100k
R60 |  | https://www.te.com/commerce/DocumentDelivery/DDEController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 | RES SMD 10K OHM 1% 1/10W 0603 | Resistor_SMD:R_0603_1608Metric |  |  | TE Connectivity Passive Product | CRG0603F10K |  |  | 1% | 10k
R62 |  | https://www.te.com/commerce/DocumentDelivery/DDEController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 | RES SMD 10K OHM 1% 1/10W 0603 | Resistor_SMD:R_0603_1608Metric |  |  | TE Connectivity Passive Product | CRG0603F10K |  |  | 1% | 10k
R7 |  | https://www.yageo.com/upload/media/product/products/datasheet/rchip/PYu-RC_Group_51_RoHS_L_12.pdf | RES 120 OHM 1% 1W 2512 | Resistor_SMD:R_2512_6332Metric |  |  | Yageo | RC2512FK-07120RL | 2512 | 1W | 1% | 120
R8 |  | https://www.mouser.es/datasheet/2/418/9/ENG_DS_1773204_5_1-3346398.pdf | RES 3540 13R 1% | Library:RES_3540 |  |  | TE Connectivity | 354013RFT | 3540 | 4W | 1% | 13
R9 |  | https://www.vishay.com/docs/20035/dcrcwe3.pdf | RES SMD 1.13M OHM 1% 1/10W 0603 | Resistor_SMD:R_0603_1608Metric |  |  | Vishay Dale | CRCW06031M13FKEA |  |  | 1% | 1.13M
S1 |  | https://configured-product-images.s3.amazonaws.com/2D/specs/JS5208.pdf | SWITCH NAVIGATION DGTL 20MA 15V | Library:JS5208 | 12.2 |  | E-Switch | JS5208 |  |  |  | JS5208
S2 |  | https://configured-product-images.s3.amazonaws.com/2D/specs/TL3305BF100QG.pdf | TACT, 50MA, SPST-NO, SURFACE MOU | Library:TL3305BF160QG |  |  | E-Switch | TL3305BF100QG |  |  |  | TL3305BF100QG
S3 |  | https://configured-product-images.s3.amazonaws.com/2D/specs/TL3305BF100QG.pdf | TACT, 50MA, SPST-NO, SURFACE MOU | Library:TL3305BF160QG |  |  | E-Switch | TL3305BF100QG |  |  |  | TL3305BF100QG
SD1 |  | https://multimedia.3m.com/mws/media/416257O/3m-tm-card-connector-microsd-tm-2900-series-ts2197.pdf | CONN MICRO SD CARD R/A SMD | Library:MICROSD |  |  | 3M | 2908-05WB-MG |  |  |  | MICROSD
TFT1 |  |  | TFT LCD DISPLAY 170x320 1.9" | Library:TFT_1.9IN_170X320_30P |  |  |  |  |  |  |  | 170x320
U1 |  | https://datasheets.raspberrypi.com/pico/pico-2-datasheet.pdf | RASPBERRY PI PICO 2 | Library:RPi_Pico_SMD_TH |  |  | Raspberry Pi | PICO2 |  |  |  | PICO2
U10 |  | https://www.ti.com/lit/ds/symlink/pca9536.pdf | IC XPNDR 400KHZ I2C SMBUS 8SOIC | Library:SOIC127P600X175-8N | 1.75 |  | Texas Instruments | PCA9536DRG4 |  |  |  | PCA9536DRG4
U11 |  | http://www.ti.com/lit/gpn/tps22810-q1 | IC PWR SWITCH N-CHAN 1:1 SOT23-6 | Library:SOT95P280X145-6N | 1.45 |  | Texas Instruments | TPS22810TDBVRQ1 |  |  |  | TPS22810TDBVRQ1
U14 |  | https://datasheets.maximintegrated.com/en/ds/MAX33045E-MAX33046E.pdf | IC TRANSCEIVER HALF 1/1 8SOIC | Library:SOIC127P600X175-8N | 1.75 |  | Analog Devices | MAX33046EASA+T |  |  |  | MAX33046EASA+T
U15 |  | https://www.analog.com/media/en/technical-documentation/data-sheets/ADG849.pdf | IC SWITCH SPDTX1 600MOHM SC70-6 | Library:SOT65P210X110-6N | 1.1 |  | Analog Devices | ADG849YKSZ-REEL |  |  |  | ADG849YKSZ-REEL
U16 |  | https://www.analog.com/media/en/technical-documentation/data-sheets/ADG849.pdf | IC SWITCH SPDTX1 600MOHM SC70-6 | Library:SOT65P210X110-6N | 1.1 |  | Analog Devices | ADG849YKSZ-REEL |  |  |  | ADG849YKSZ-REEL
U18 |  | https://www.analog.com/media/en/technical-documentation/data-sheets/ADG849.pdf | IC SWITCH SPDTX1 600MOHM SC70-6 | Library:SOT65P210X110-6N | 1.1 |  | Analog Devices | ADG849YKSZ-REEL |  |  |  | ADG849YKSZ-REEL
U19 |  | https://www.analog.com/media/en/technical-documentation/data-sheets/ADG849.pdf | IC SWITCH SPDTX1 600MOHM SC70-6 | Library:SOT65P210X110-6N | 1.1 |  | Analog Devices | ADG849YKSZ-REEL |  |  |  | ADG849YKSZ-REEL
U2 |  | TPSM828303ARDSR | 2.25-V TO 5.5-V, 3-A, LOW-NOISE | Library:RDS0009A-MFG |  |  | Texas Instruments | TPSM828303ARDSR |  |  |  | TPSM828303ARDSR
U20 |  | https://ww1.microchip.com/downloads/en/DeviceDoc/20005533A.pdf | IC TRANSCEIVER 1/1 8DFN | Library:SOIC127P600X175-8N | 1.75 |  | Microchip | MCP2558FD-H/SN |  |  |  | MCP2558FD-H_SN
U22 |  | https://www.onsemi.com/pub/Collateral/NCS5652-D.PDF | IC OPAMP GP 2 CIRCUIT 12UDFN | Library:NCV5652MUTWG | 0.55 |  | onsemi | NCV5652MUTWG |  |  |  | NCV5652MUTWG
U23 |  | http://www.ti.com/lit/ds/symlink/tmux1108.pdf | IC MUX 8:1 4OHM 16TSSOP | Library:SOP65P640X120-16N | 1.2 |  | Texas Instruments | TMUX1108PWR |  |  |  | TMUX1108PWR
U24 |  | http://www.ti.com/lit/ds/symlink/tmux1108.pdf | IC MUX 8:1 4OHM 16TSSOP | Library:SOP65P640X120-16N | 1.2 |  | Texas Instruments | TMUX1108PWR |  |  |  | TMUX1108PWR
U25 |  | https://www.ti.com/lit/ds/symlink/tl431.pdf | IC VREF SHUNT ADJ 1% SOT23-3 | Library:SOT95P237X112-3N | 1.12 |  | Texas Instruments | TL431AIDBZR |  |  |  | TL431AIDBZR
U26 |  | https://www.ti.com/lit/ds/symlink/tl431.pdf | IC VREF SHUNT ADJ 1% SOT23-3 | Library:SOT95P237X112-3N | 1.12 |  | Texas Instruments | TL431AIDBZR |  |  |  | TL431AIDBZR
U27 |  | http://www.ti.com/lit/gpn/tps22810-q1 | IC PWR SWITCH N-CHAN 1:1 SOT23-6 | Library:SOT95P280X145-6N | 1.45 |  | Texas Instruments | TPS22810TDBVRQ1 |  |  |  | TPS22810TDBVRQ1
U28 |  | https://www.ti.com/lit/ds/symlink/tl431.pdf | IC VREF SHUNT ADJ 1% SOT23-3 | Library:SOT95P237X112-3N | 1.12 |  | Texas Instruments | TL431AIDBZR |  |  |  | TL431AIDBZR
U29 |  | https://www.ti.com/lit/ds/symlink/tl431.pdf | IC VREF SHUNT ADJ 1% SOT23-3 | Library:SOT95P237X112-3N | 1.12 |  | Texas Instruments | TL431AIDBZR |  |  |  | TL431AIDBZR
U3 |  | https://www.ti.com/lit/ds/symlink/ts5a3359.pdf | IC SWITCH SP3TX1 900MOHM 8VSSOP | Library:SOP50P310X90-8N | 0.9 |  | Texas Instruments | TS5A3359DCUR |  |  |  | TS5A3359DCUR
U30 |  | https://www.ti.com/lit/gpn/tcal9539 | I2C GENERAL-PURPOSE I/OS (GPIOS) | Library:SOP65P640X120-24N | 1.2 |  | Texas Instruments | TCAL9539PWR |  |  |  | TCAL9539PWR
U31 |  | http://www.ti.com/lit/gpn/tps22810-q1 | IC PWR SWITCH N-CHAN 1:1 SOT23-6 | Library:SOT95P280X145-6N | 1.45 |  | Texas Instruments | TPS22810TDBVRQ1 |  |  |  | TPS22810TDBVRQ1
U32 |  | https://ww1.microchip.com/downloads/en/DeviceDoc/External-CAN-FD-Controller-with-SPI-Interface-DS20006027B.pdf | IC CAN CONTROLLER SPI 14SOIC | Package_SO:SOIC-14_3.9x8.7mm_P1.27mm |  |  | Microchip Technology | MCP2518FDT-E/SL |  |  |  | MCP2518FD
U4 |  | http://www.memsic.com/uploadfiles/2020/08/20200827164636363.pdf | 3-AXIS ACCELEROMETER | Library:MC3479 | 1 |  | MEMSIC | MC3479 |  |  |  | MC3479
U5 |  | https://www.analog.com/media/en/technical-documentation/data-sheets/ADR510.pdf | IC VREF SHUNT 0.35% SOT23-3 | Library:SOT95P237X112-3N |  |  | Analog Devices | ADR510ARTZ-REEL7 |  |  |  | ADR510ARTZ-REEL7
U6 |  | https://www.renesas.com/en-us/www/doc/datasheet/isl21010.pdf | IC VREF SERIES 0.2% SOT23-3 | Library:SOT95P237X112-3N-RENESAS | 1.12 |  | Renesas Electronics | ISL21010CFH315Z-T7A |  |  |  | ISL21010CFH315Z-T7A
U7 |  | http://www.ti.com/lit/gpn/lm4040 | IC VREF SHUNT 1% SOT23-3 | Library:SOT95P237X112-3N | 1.12 |  | Texas Instruments | LM4040D20IDBZR |  |  |  | LM4040D20IDBZR
U8 |  | http://www.ti.com/lit/ds/symlink/bq2970.pdf | IC BATT PROT LI-ION 1CELL 6WSON | Package_SON:WSON-6_1.5x1.5mm_P0.5mm |  |  | Texas Instruments | BQ29700DSER |  |  |  | BQ297xy
U9 |  | https://www.ti.com/lit/ds/symlink/bq25895.pdf | IC BATT CHG LI-ION 1CELL 24WQFN | Package_DFN_QFN:Texas_RTW_WQFN-24-1EP_4x4mm_P0.5mm_EP2.7x2.7mm_ThermalVias |  |  | Texas Instruments | BQ25895RTWT |  |  |  | BQ25895RTW
Y1 |  | https://eu.mouser.com/datasheet/2/122/ecx_32-6206.pdf | CRYSTAL 20.0000MHZ 18PF SMD | Crystal:Crystal_SMD_3225-4Pin_3.2x2.5mm |  |  | ECS Inc. | ECS-200-18-33-JGN-TR |  |  |  | 20MHz 18pF
Z1 |  | https://www.onsemi.com/pub/Collateral/1SMB5913BT3-D.PDF | DIODE ZENER 5.1V 3W SMB | Library:DIOM5436X247N | 2.47 |  | onsemi | 1SMB5918BT3G |  |  |  | 1SMB5918BT3G
Z2 |  | https://www.onsemi.com/pub/Collateral/1SMB5913BT3-D.PDF | DIODE ZENER 5.1V 3W SMB | Library:DIOM5436X247N | 2.47 |  | onsemi | 1SMB5918BT3G |  |  |  | 1SMB5918BT3G
