Maritime-Hacking-Village/Badge-2025/KiCAD/DC33/3D/MC3479.stp

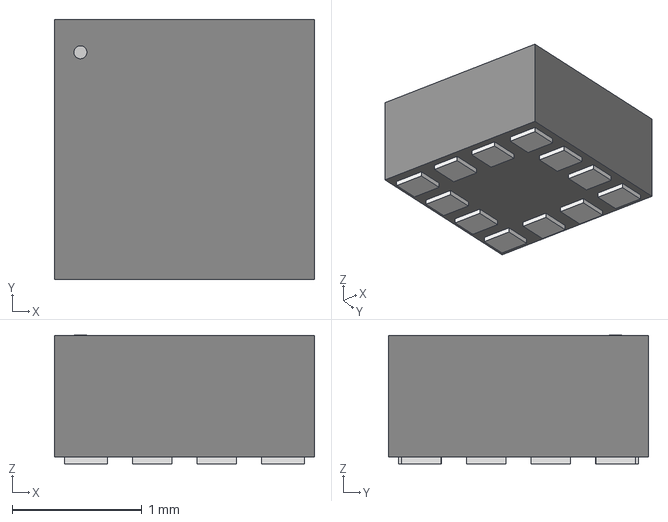
[picture p3: CAD file, 2025-07-31]
KiCAD/DC33/3D/MC3479.stp
2.01 x 2.01 x 0.993 mm
