Maritime-Hacking-Village/Badge-2025/KiCAD/DC33/3D/NeoPixel-5050.step

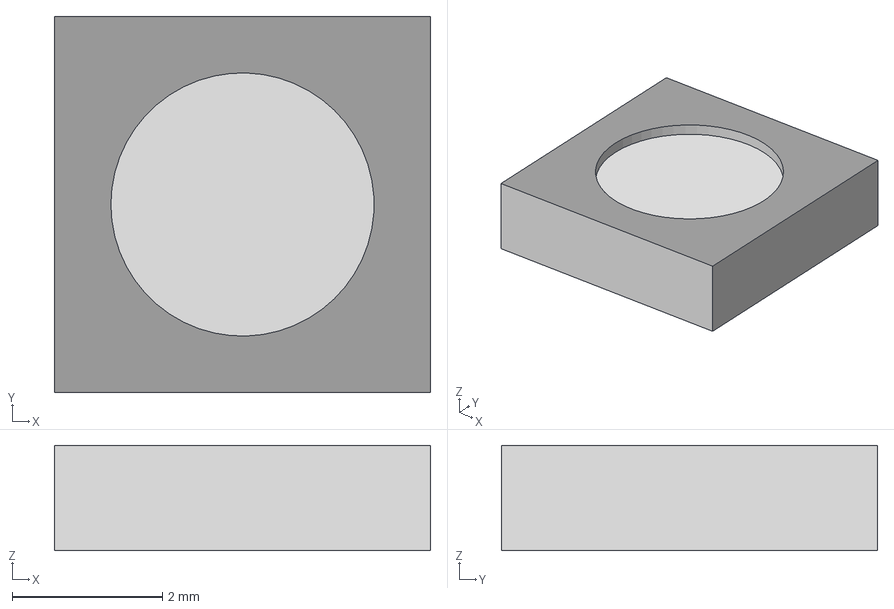
[picture p4: CAD file, 2025-07-31]
KiCAD/DC33/3D/NeoPixel-5050.step
5.00 x 5.00 x 1.40 mm
