Maritime-Hacking-Village/Badge-2025/KiCAD/DC33/3D/SFH11-NBPC-D03-ST-BK.STEP

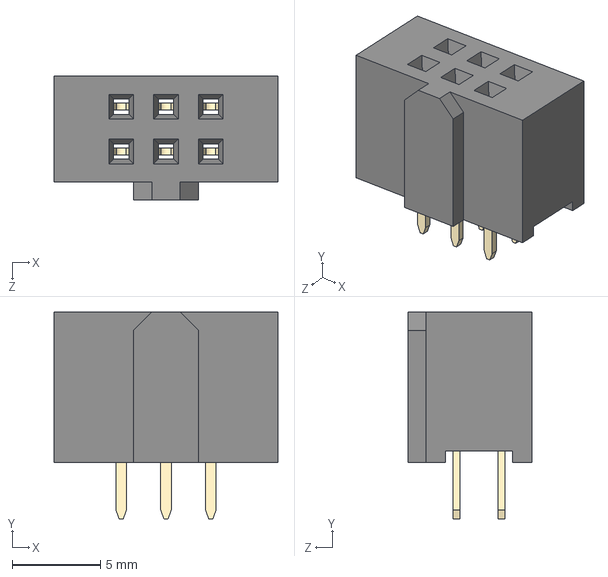
[picture p5: CAD file, 2025-07-31]
KiCAD/DC33/3D/SFH11-NBPC-D03-ST-BK.STEP
12.7 x 11.7 x 7.01 mm
SFH11-xC-Dx-ST-BK body_03
pin^SFH11-xC-Dx-ST-BK Ass x 6
