Maritime-Hacking-Village/Badge-2025/KiCAD/DC33/3D/TL431AIDBZR.stp

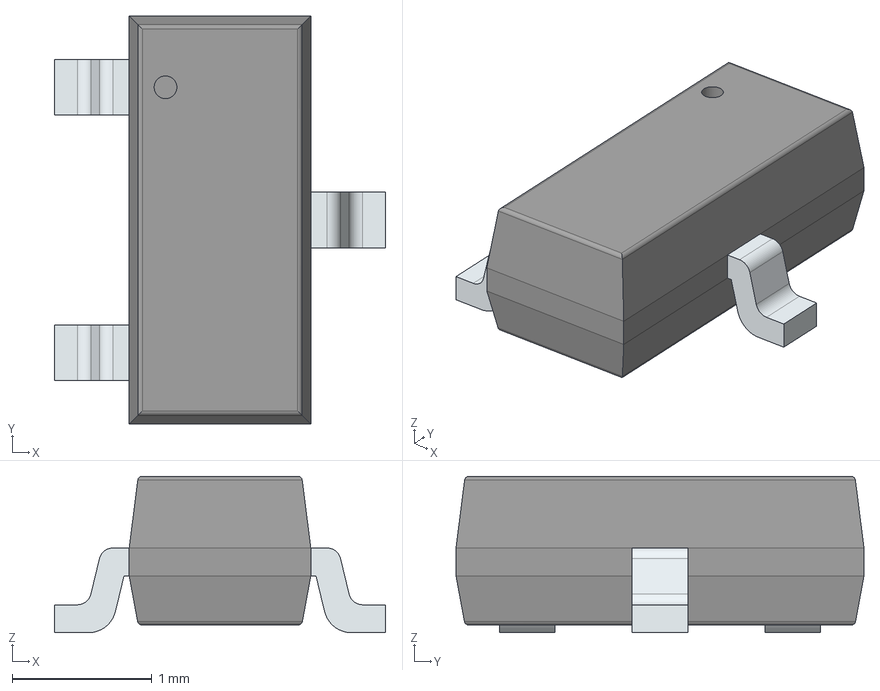
[picture p6: CAD file, 2025-07-31]
KiCAD/DC33/3D/TL431AIDBZR.stp
2.37 x 2.92 x 1.12 mm
PinsArrayL
FilletPinR
