Maritime-Hacking-Village/Badge-2025/KiCAD/DC33/3D/TCAL9539PWR.stp

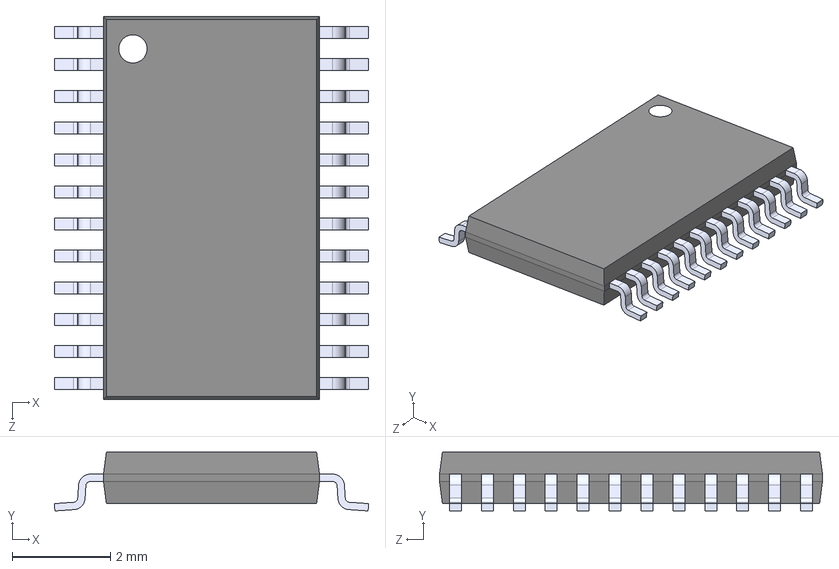
[picture p7: CAD file, 2025-07-31]
KiCAD/DC33/3D/TCAL9539PWR.stp
6.40 x 1.20 x 7.80 mm
