Maritime-Hacking-Village/Badge-2025/KiCAD/DC33/3D/PWP0014A.stp

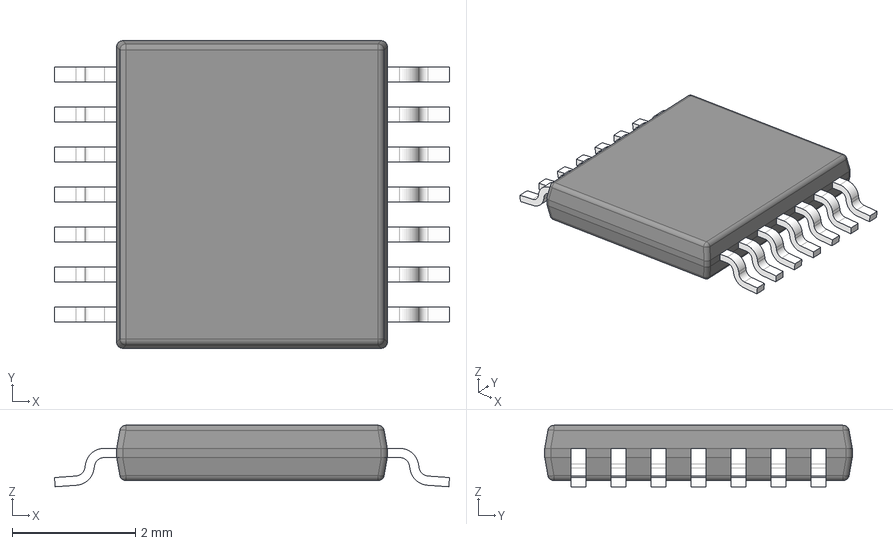
[picture p8: CAD file, 2025-07-31]
KiCAD/DC33/3D/PWP0014A.stp
6.42 x 5.00 x 1.00 mm
BODY-SO
LEAD-SO x 14
THERMALPAD-SO
PIN1-ID
