Maritime-Hacking-Village/Badge-2025/KiCAD/DC33/3D/CL-SB-12C-01.stp

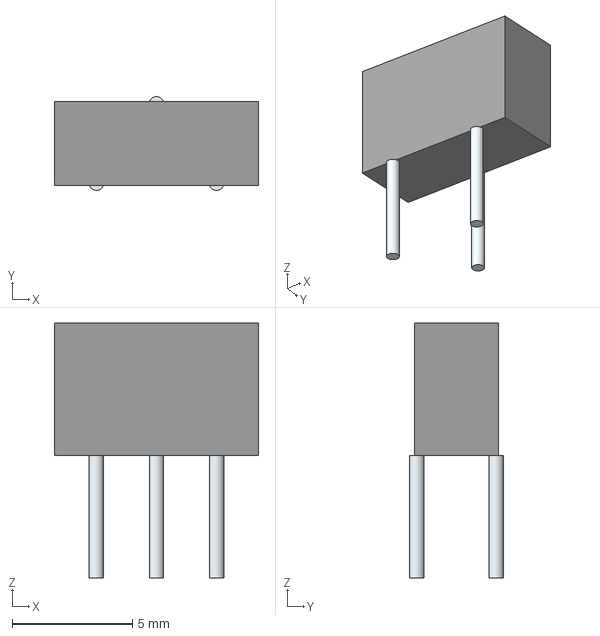
[picture p9: CAD file, 2025-07-31]
KiCAD/DC33/3D/CL-SB-12C-01.stp
8.50 x 3.90 x 10.6 mm
Leads
