Maritime-Hacking-Village/Badge-2025/KiCAD/DC33/3D/EXB-38V220JV.stp

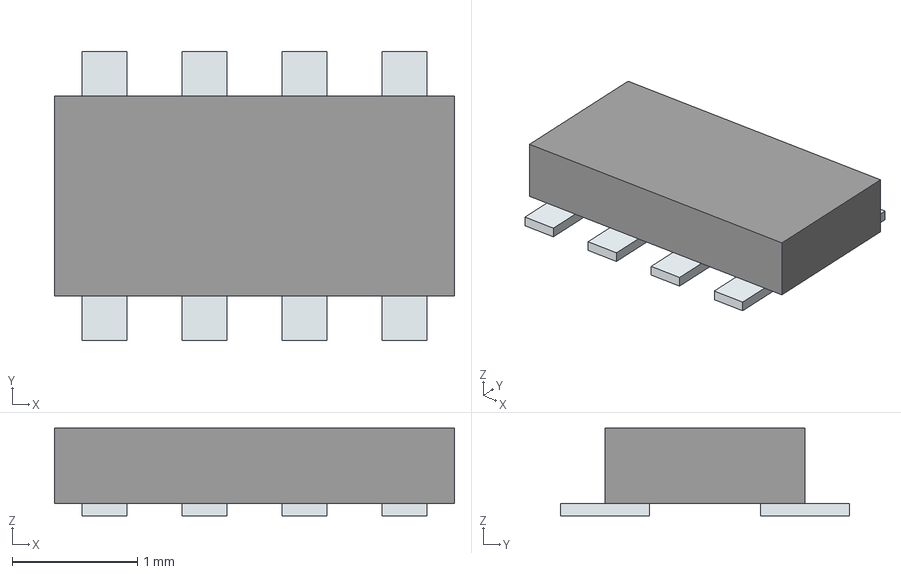
[picture p10: CAD file, 2025-07-31]
KiCAD/DC33/3D/EXB-38V220JV.stp
3.20 x 2.31 x 0.7 mm
Pins
