Maritime-Hacking-Village/Badge-2025/KiCAD/DC33/3D/XAL7030-222MEB.stp

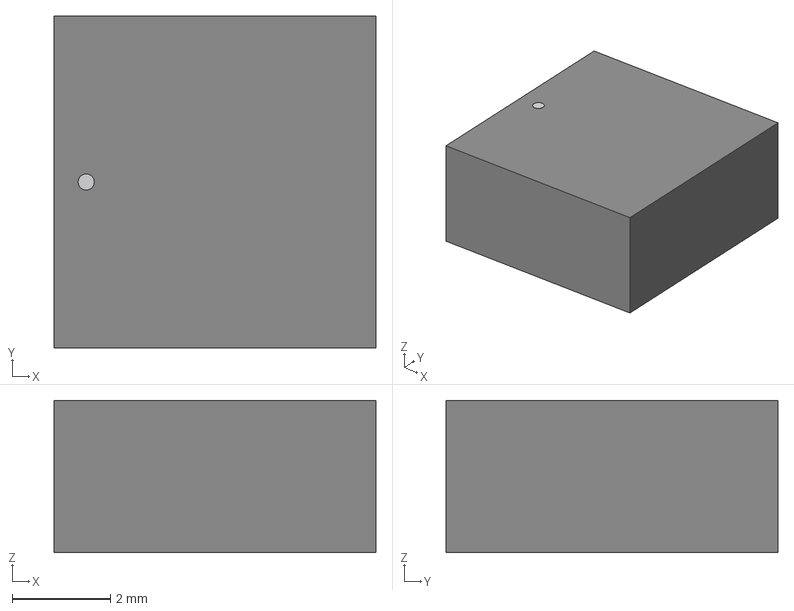
[picture p11: CAD file, 2025-07-31]
KiCAD/DC33/3D/XAL7030-222MEB.stp
6.55 x 6.76 x 3.10 mm
