Maritime-Hacking-Village/Badge-2025/KiCAD/DC33/3D/microsd.step

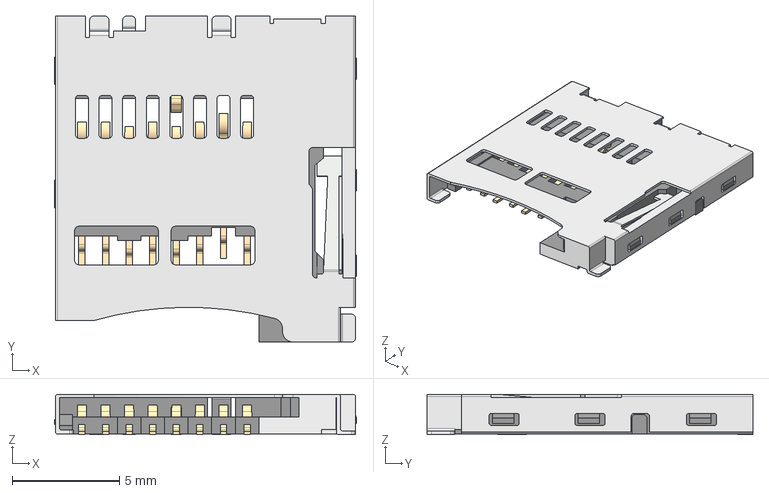
[picture p12: CAD file, 2025-07-31]
KiCAD/DC33/3D/microsd.step
14.1 x 15.2 x 1.88 mm
