Maritime-Hacking-Village/Badge-2025/KiCAD/DC33/3D/TPSM828303ARDSR.stp

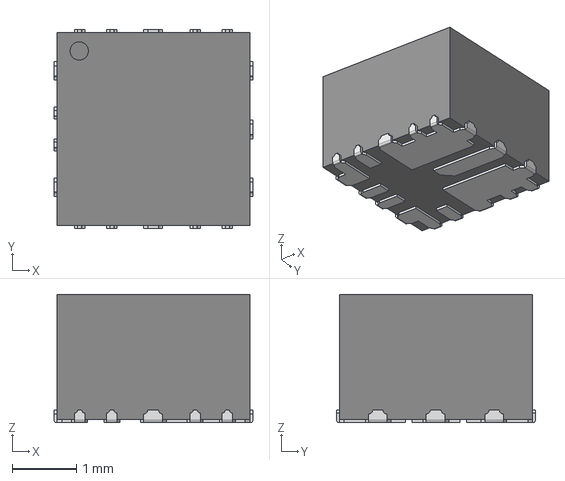
[picture p13: CAD file, 2025-07-31]
KiCAD/DC33/3D/TPSM828303ARDSR.stp
3.10 x 3.10 x 2.00 mm
