Maritime-Hacking-Village/Badge-2025/KiCAD/DC33/3D/ADG849YKSZ-REEL.stp

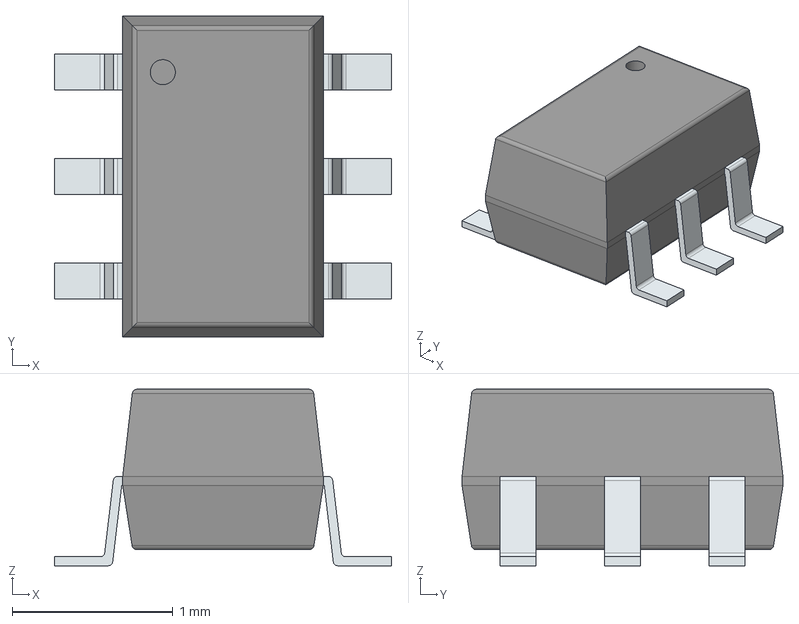
[picture p14: CAD file, 2025-07-31]
KiCAD/DC33/3D/ADG849YKSZ-REEL.stp
2.10 x 2.00 x 1.10 mm
PinsArrayLR
