Maritime-Hacking-Village/Badge-2025/KiCAD/DC33/3D/JS5208.stp

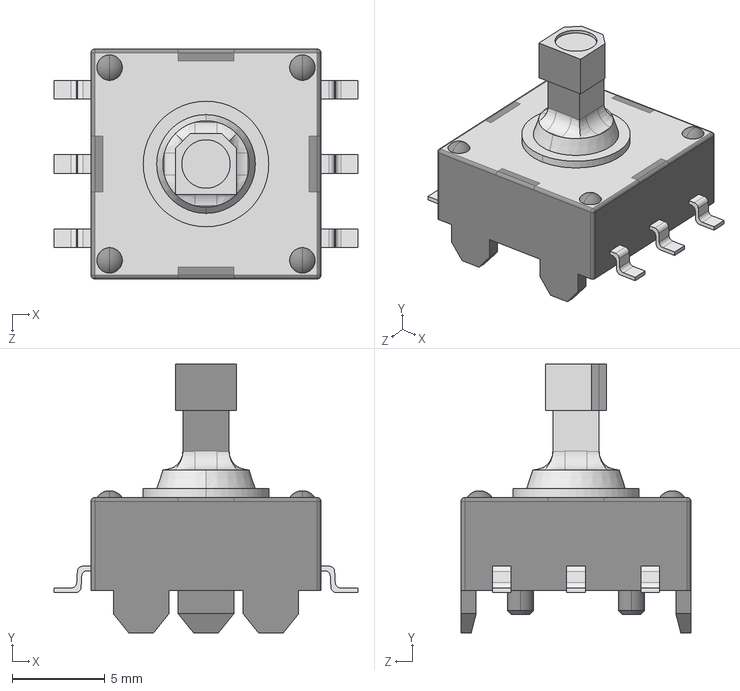
[picture p15: CAD file, 2025-07-31]
KiCAD/DC33/3D/JS5208.stp
16.4 x 14.5 x 12.4 mm
