Maritime-Hacking-Village/Badge-2025/KiCAD/DC33/3D/MCP2558FDT-H_MNY.stp

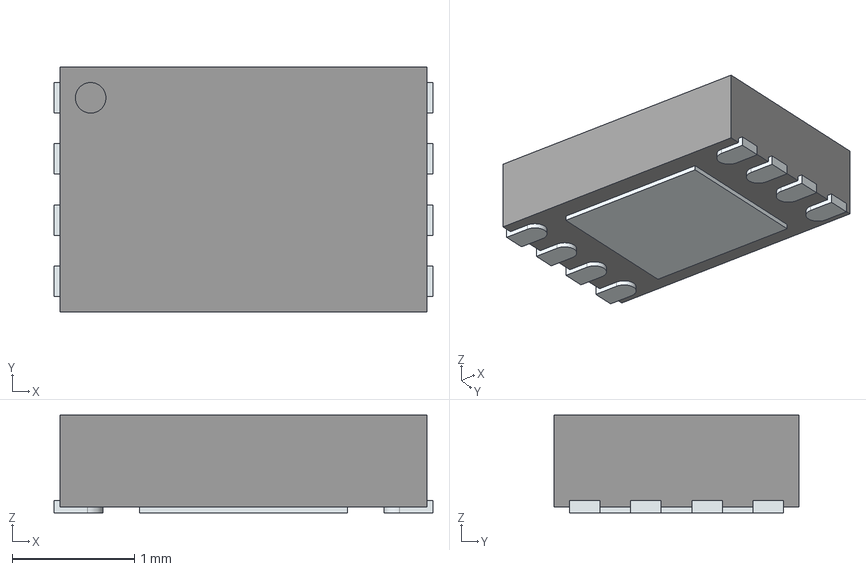
[picture p16: CAD file, 2025-07-31]
KiCAD/DC33/3D/MCP2558FDT-H_MNY.stp
3.10 x 2.00 x 0.8 mm
ThermalPin
PinsArrayLR
