Maritime-Hacking-Village/Badge-2025/KiCAD/DC33/3D/TS5A3359DCUR.stp

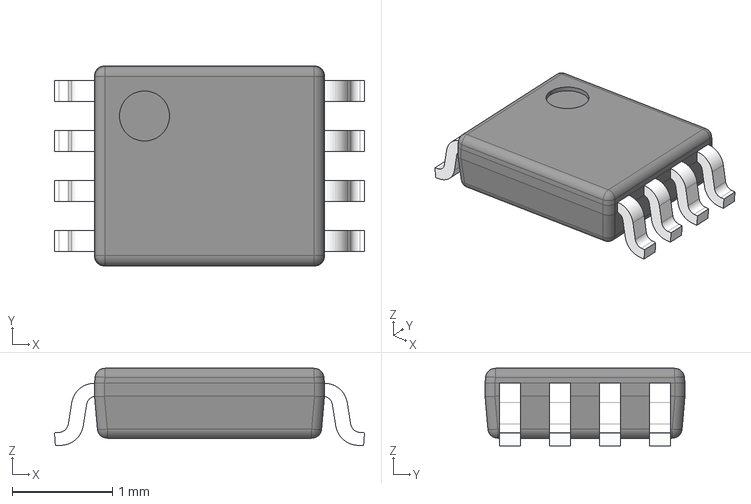
[picture p17: CAD file, 2025-07-31]
KiCAD/DC33/3D/TS5A3359DCUR.stp
3.10 x 2.00 x 0.775 mm
BODY-VSSOP
LEAD-VSSOP x 8
