Maritime-Hacking-Village/Badge-2025/KiCAD/DC33/3D/tft_lcd_30p.step

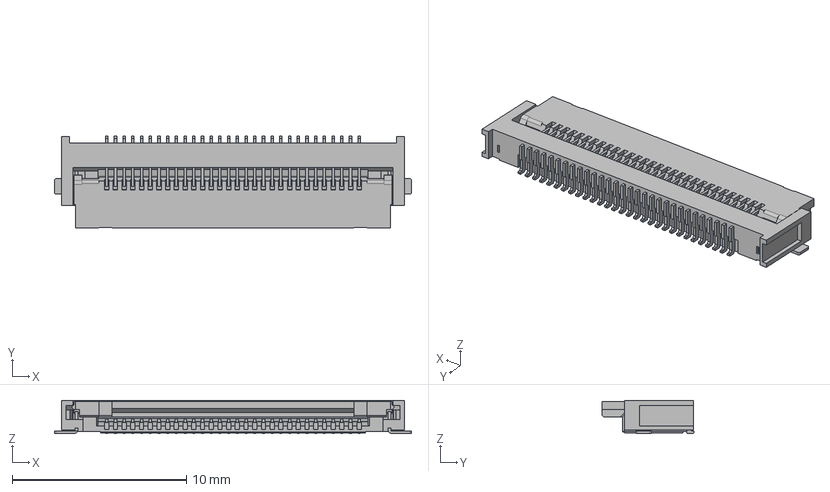
[picture p18: CAD file, 2025-07-31]
KiCAD/DC33/3D/tft_lcd_30p.step
20.5 x 5.30 x 1.90 mm
