Maritime-Hacking-Village/Badge-2025/KiCAD/DC33/3D/TMUX1108PWR.stp

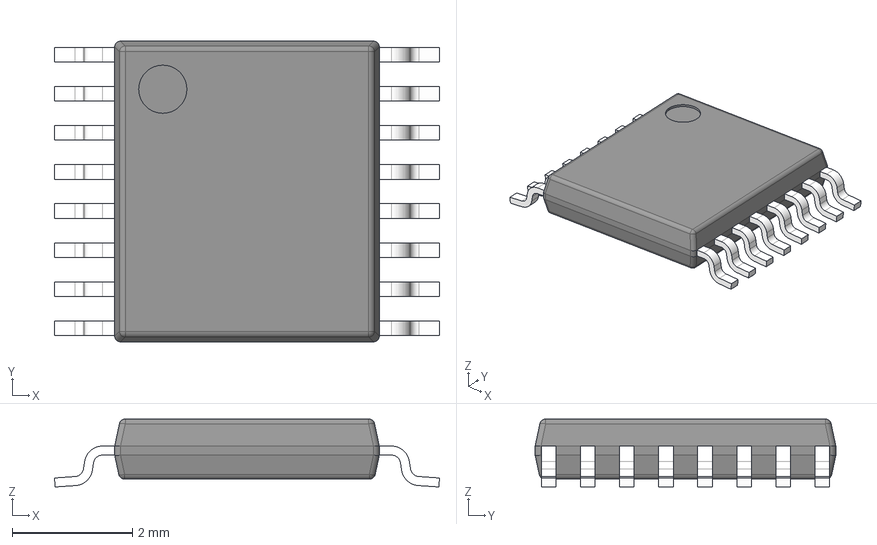
[picture p19: CAD file, 2025-07-31]
KiCAD/DC33/3D/TMUX1108PWR.stp
6.40 x 5.00 x 1.13 mm
BODY-TSSOP
LEAD-TSSOP x 16
PIN1
