Maritime-Hacking-Village/Badge-2025/KiCAD/DC33/3D/TMUX121NKGR.stp

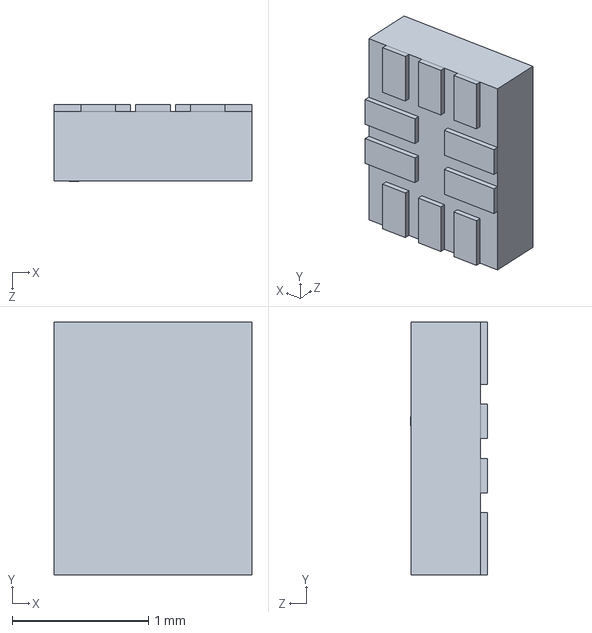
[picture p20: CAD file, 2025-07-31]
KiCAD/DC33/3D/TMUX121NKGR.stp
1.45 x 1.85 x 0.561 mm
