Maritime-Hacking-Village/Badge-2025/KiCAD/DC33/3D/NeoPixel-3535.step

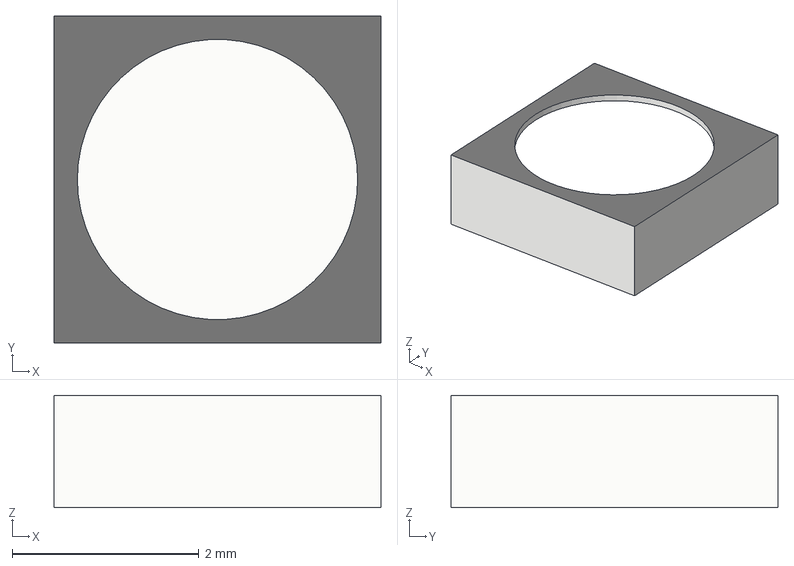
[picture p21: CAD file, 2025-07-31]
KiCAD/DC33/3D/NeoPixel-3535.step
3.50 x 3.50 x 1.20 mm
