Maritime-Hacking-Village/Badge-2025/KiCAD/DC33/3D/TMUX1104DGSR.stp

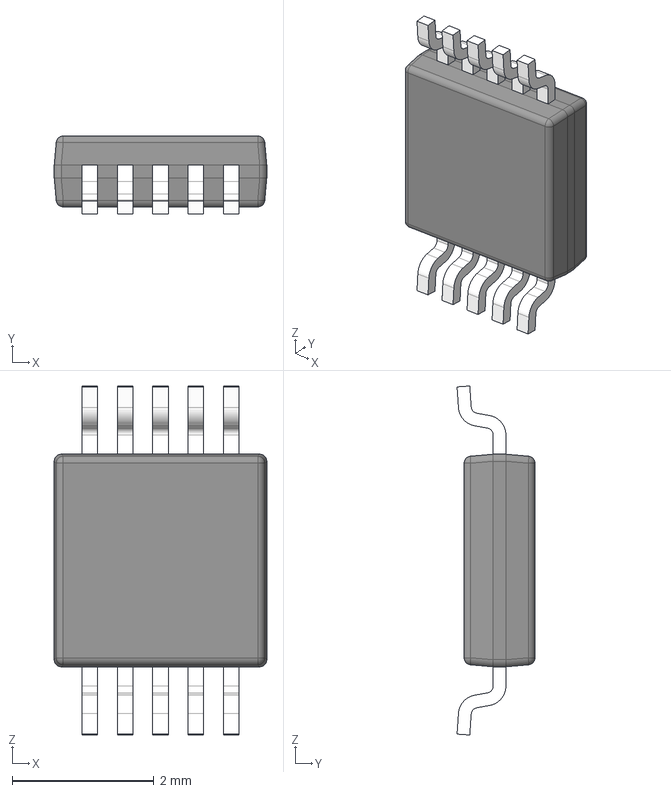
[picture p22: CAD file, 2025-07-31]
KiCAD/DC33/3D/TMUX1104DGSR.stp
3.00 x 1.10 x 4.93 mm
BODY-SO
LEAD-SO x 10
PIN1-ID
