Maritime-Hacking-Village/Badge-2025/KiCAD/DC33/3D/RES_3540_TEC.step

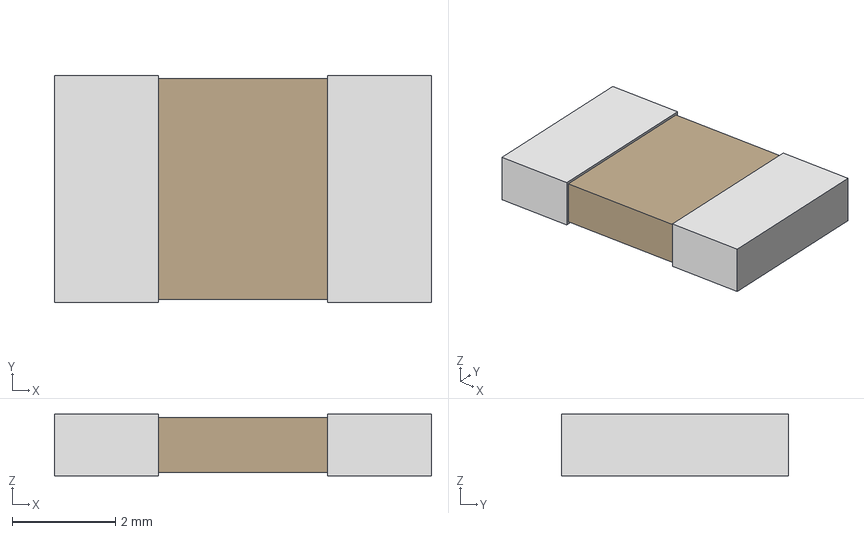
[picture p23: CAD file, 2025-07-31]
KiCAD/DC33/3D/RES_3540_TEC.step
7.29 x 4.39 x 1.19 mm
