Maritime-Hacking-Village/Badge-2025/KiCAD/DC33/3D/mf-sm030.stp

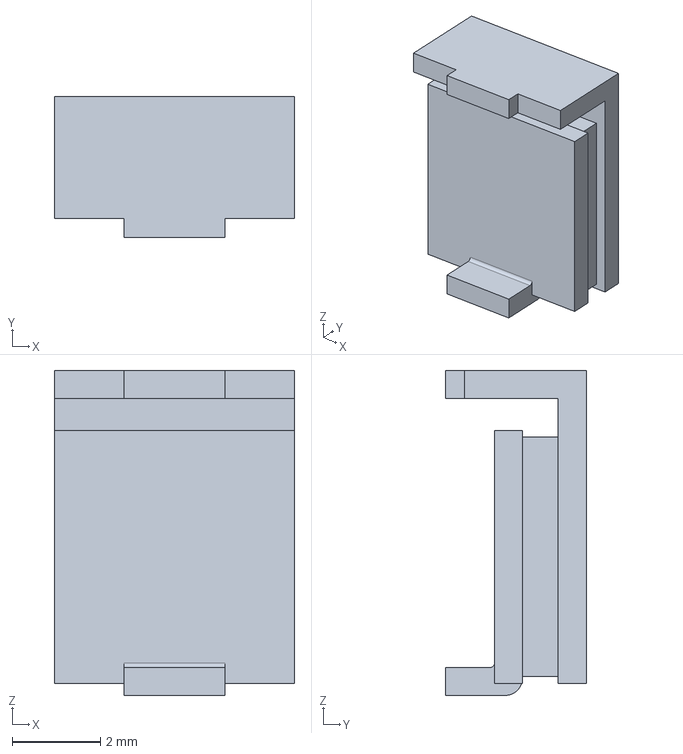
[picture p24: CAD file, 2025-07-31]
KiCAD/DC33/3D/mf-sm030.stp
5.44 x 3.18 x 7.36 mm
