Maritime-Hacking-Village/Badge-2025/KiCAD/DC33/3D/TL3305BF100QG.stp

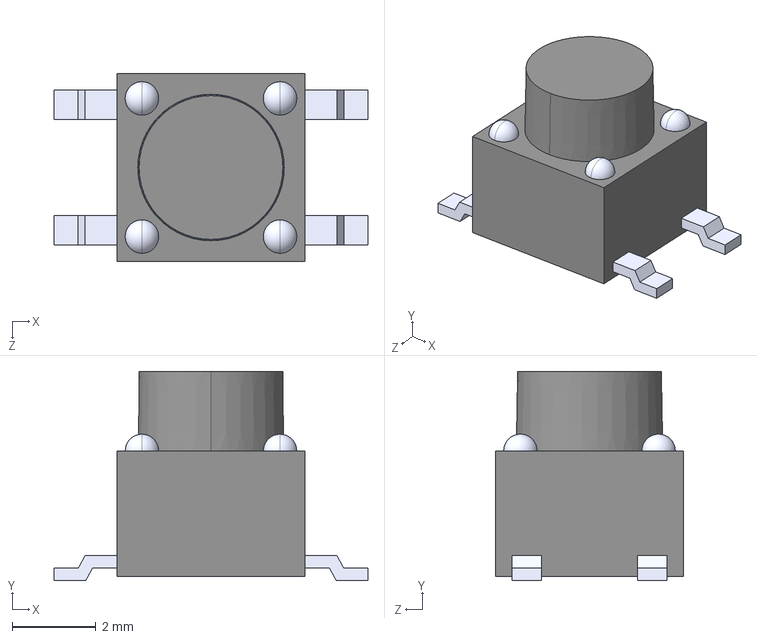
[picture p25: CAD file, 2025-07-31]
KiCAD/DC33/3D/TL3305BF100QG.stp
7.50 x 5.00 x 4.50 mm
