Maritime-Hacking-Village/Badge-2025/KiCAD/DC33/3D/MCP2558FD-H_SN.stp

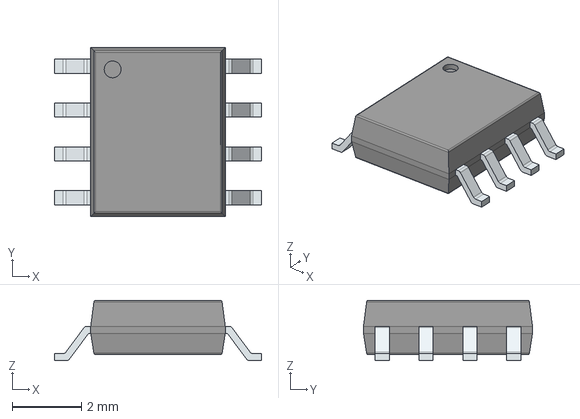
[picture p26: CAD file, 2025-07-31]
KiCAD/DC33/3D/MCP2558FD-H_SN.stp
6.00 x 4.90 x 1.75 mm
PinsArrayLR
