Maritime-Hacking-Village/Badge-2025/KiCAD/DC33/3D/S2B-PH-K-S.STEP

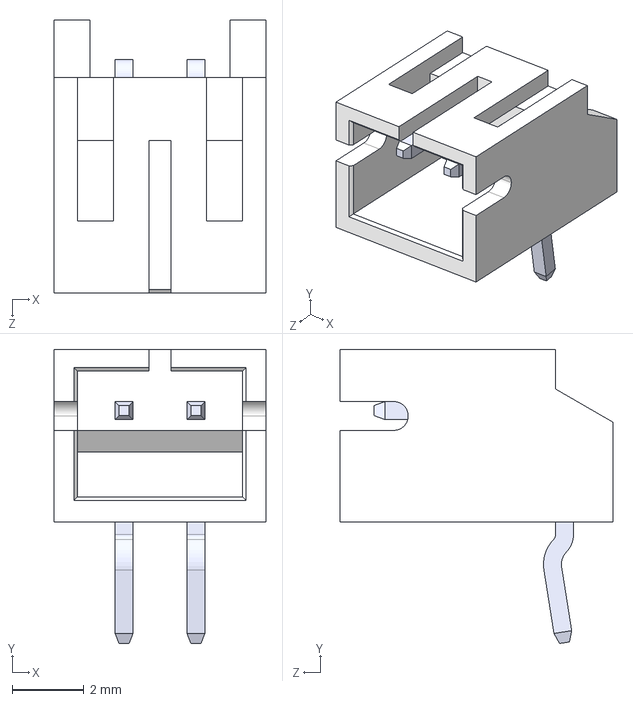
[picture p27: CAD file, 2025-07-31]
KiCAD/DC33/3D/S2B-PH-K-S.STEP
5.90 x 8.18 x 7.60 mm
