Maritime-Hacking-Village/Badge-2025/KiCAD/DC33/3D/tft_display.step

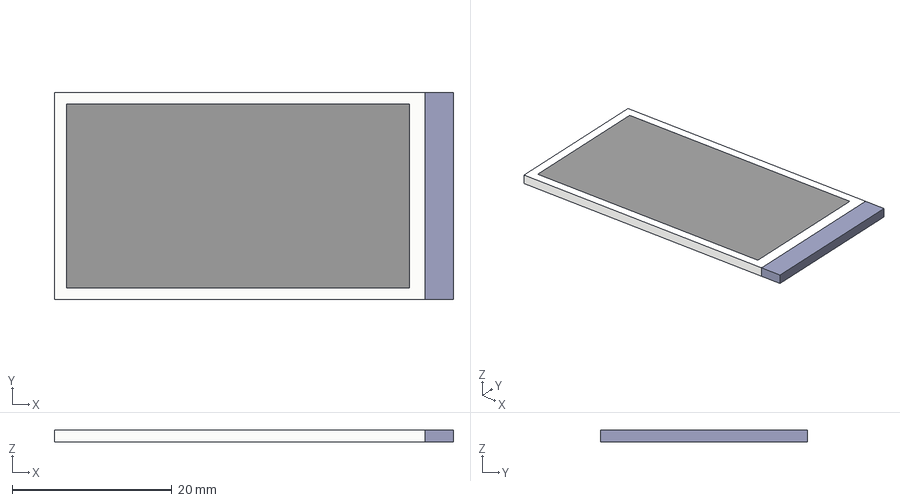
[picture p28: CAD file, 2025-07-31]
KiCAD/DC33/3D/tft_display.step
50.0 x 26.0 x 1.50 mm
TFT display
TFT display001
TFT display002
