Maritime-Hacking-Village/Badge-2025/KiCAD/DC33/3D/UA9638CIDREP.stp

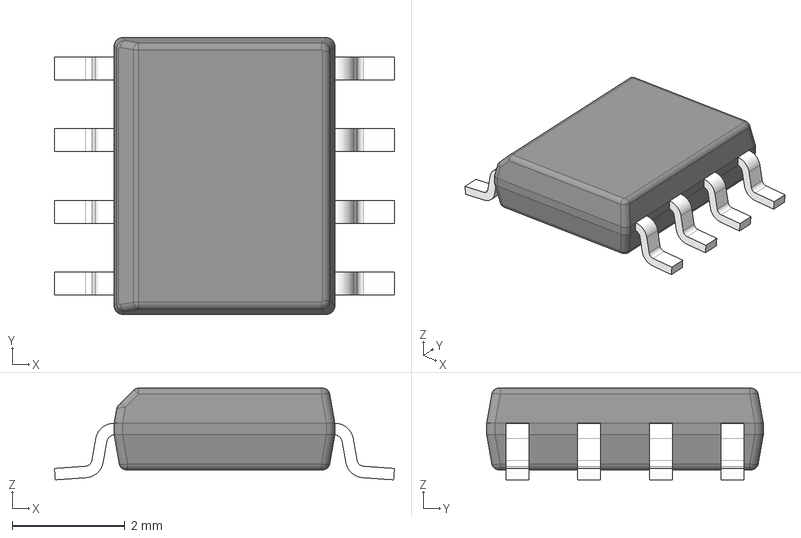
[picture p29: CAD file, 2025-07-31]
KiCAD/DC33/3D/UA9638CIDREP.stp
6.02 x 4.90 x 1.63 mm
BODY-SO
LEAD-D0008A x 8
