Maritime-Hacking-Village/Badge-2025/KiCAD/DC33/3D/FDN359BN.stp

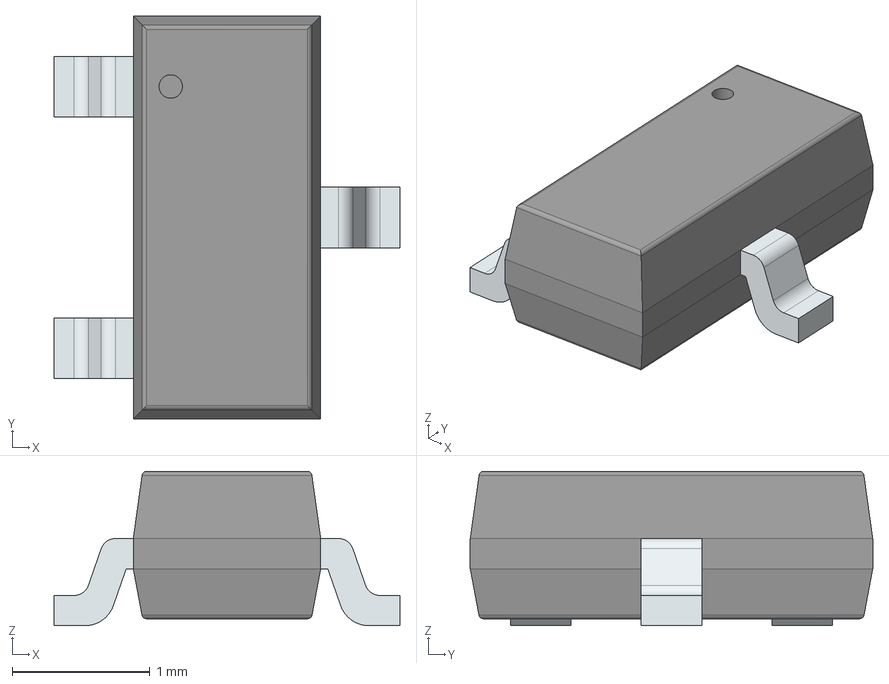
[picture p30: CAD file, 2025-07-31]
KiCAD/DC33/3D/FDN359BN.stp
2.51 x 2.92 x 1.12 mm
PinsArrayL
FilletPinR
