Maritime-Hacking-Village/Badge-2025/KiCAD/DC33/3D/1SMB5918BT3G.stp

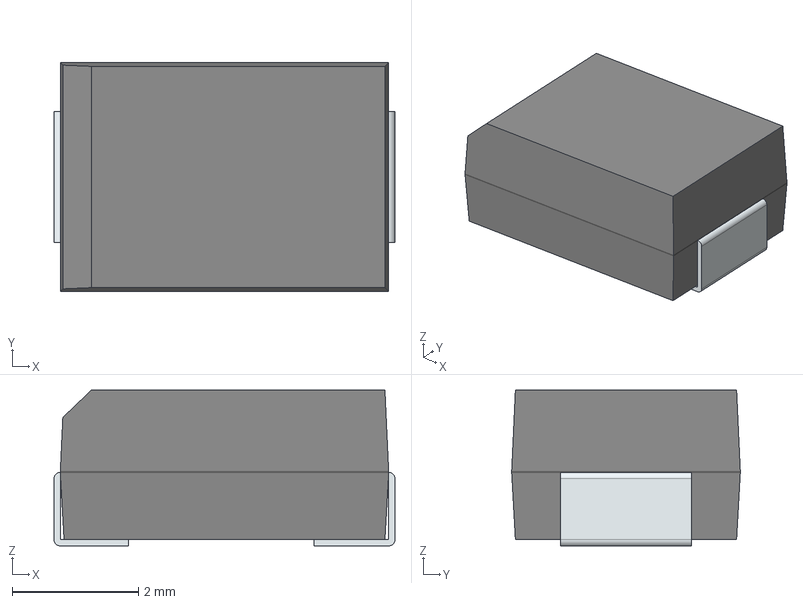
[picture p31: CAD file, 2025-07-31]
KiCAD/DC33/3D/1SMB5918BT3G.stp
5.41 x 3.62 x 2.47 mm
FilletPin1
FilletPin2
