Maritime-Hacking-Village/Badge-2025/KiCAD/DC33/3D/CL-SB-22C-02.stp

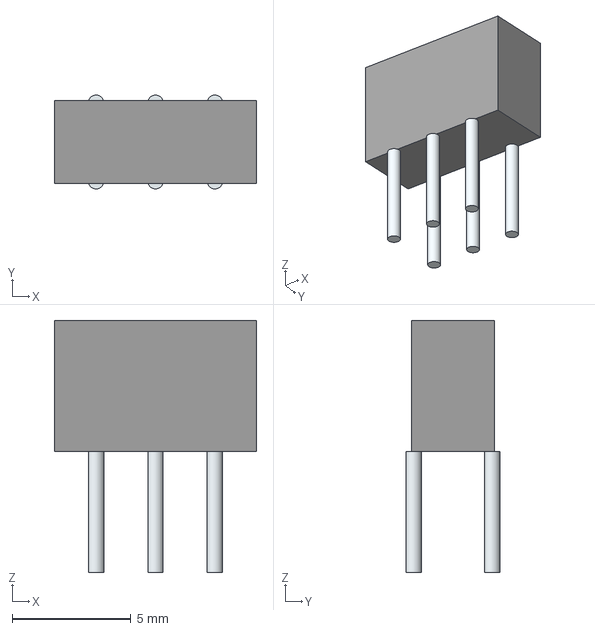
[picture p32: CAD file, 2025-07-31]
KiCAD/DC33/3D/CL-SB-22C-02.stp
8.50 x 3.95 x 10.6 mm
Leads
