Maritime-Hacking-Village/Badge-2025/KiCAD/DC33/3D/PPTC201LFBN-RC.STEP

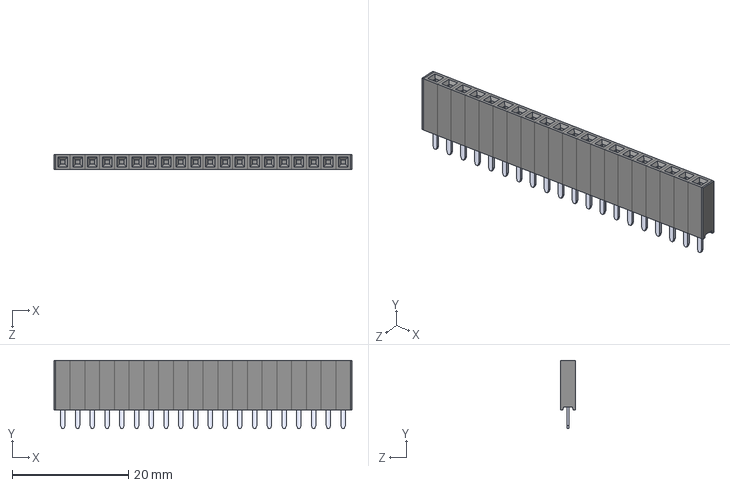
[picture p33: CAD file, 2025-07-31]
KiCAD/DC33/3D/PPTC201LFBN-RC.STEP
51.3 x 11.7 x 2.54 mm
PPPC021LFBN-RC_C20
Pin - Tin x 20
