Maritime-Hacking-Village/Badge-2025/(list of files, cad)

Other CAD files:
KiCAD/DC33/3D/LM4040D20IDBZR.stp
KiCAD/DC33/3D/MF-SM030-2.stp
KiCAD/DC33/3D/282834-3.stp
KiCAD/DC33/3D/282834-5.stp
KiCAD/DC33/3D/541043031.stp
KiCAD/DC33/3D/61200621621.stp
KiCAD/DC33/3D/ISL21010CFH315Z-T7A.stp
KiCAD/DC33/3D/M20-9992045.STEP
KiCAD/DC33/3D/TPS22810TDBVRQ1.stp
