Maritime-Hacking-Village/Badge-2025/KiCAD/DC33/DC33.kicad_sch

## KiCad design KiCAD/DC33/DC33.kicad_sch (2026-07-09)

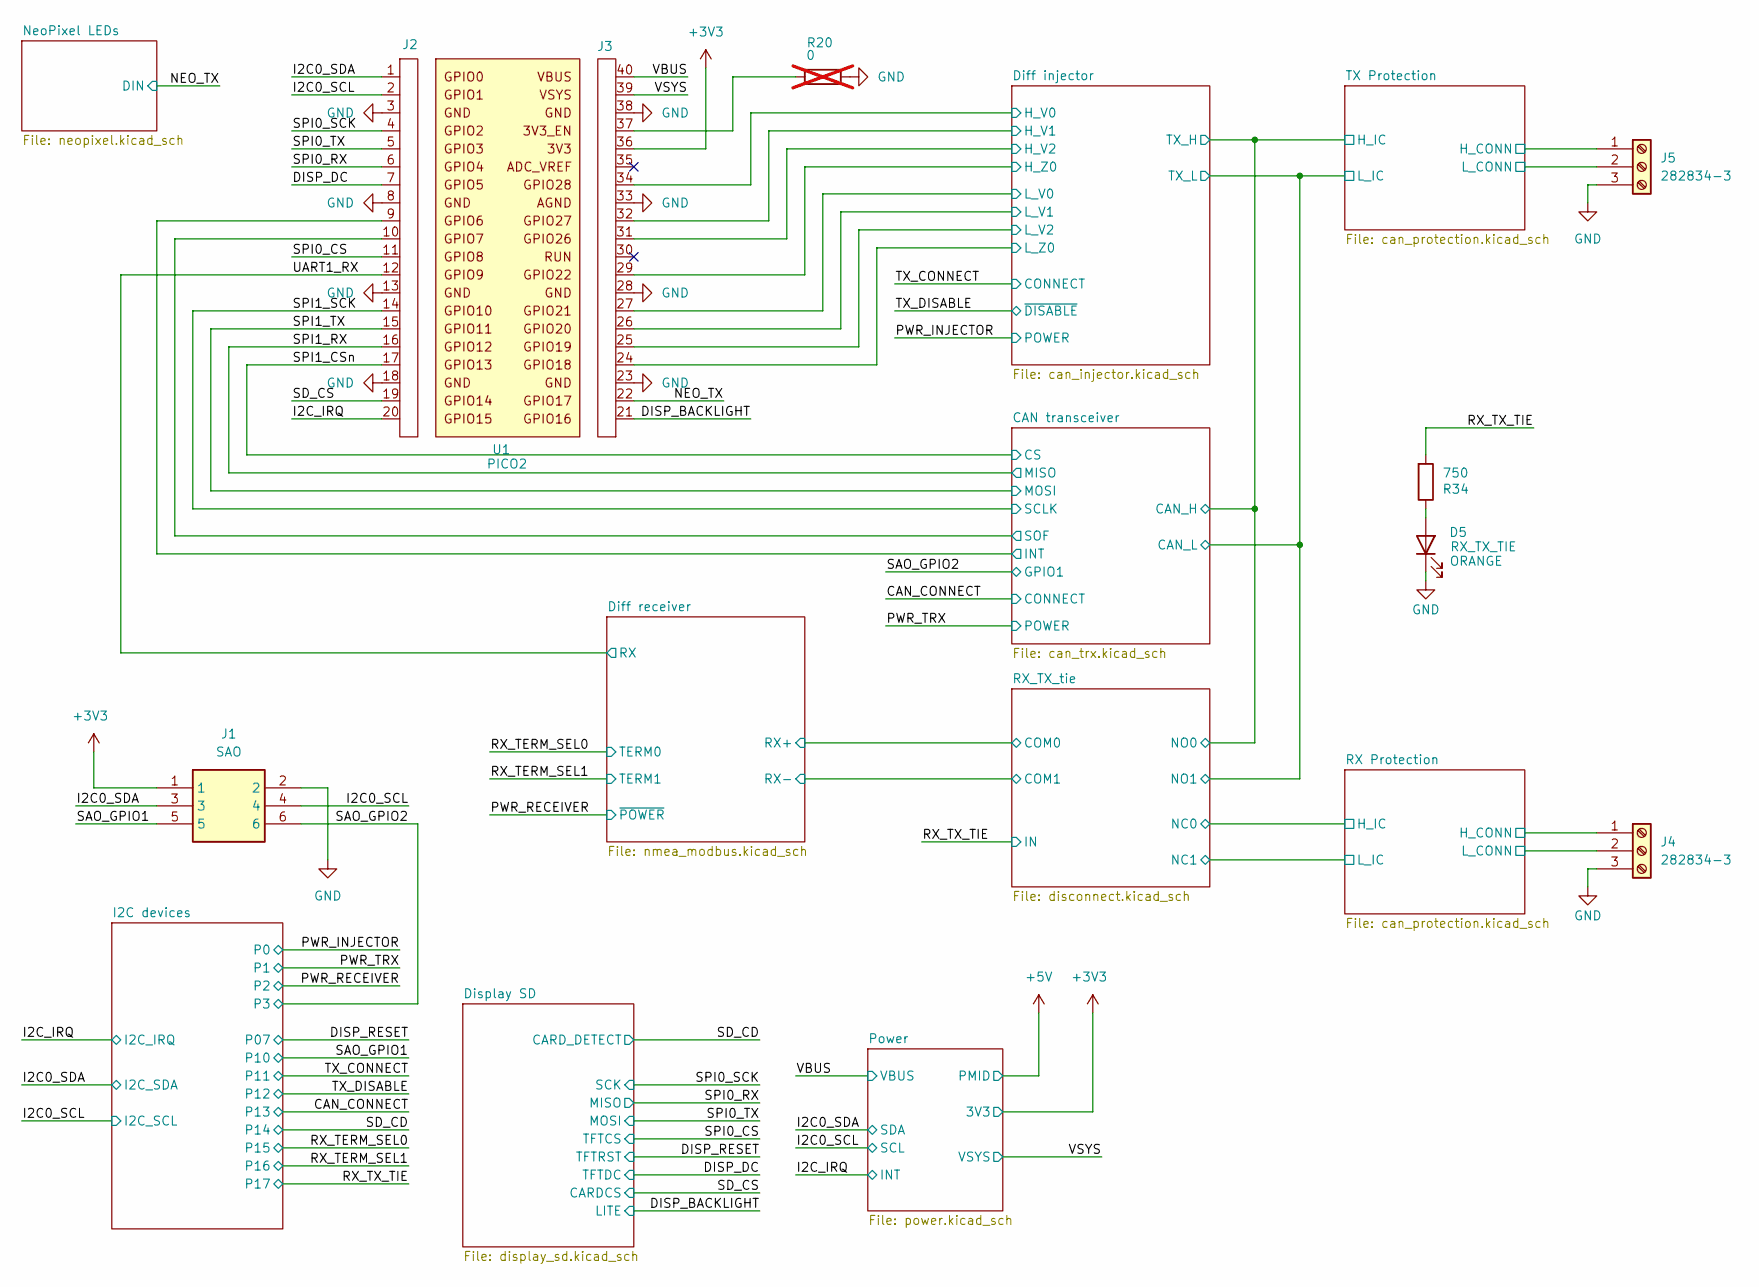
[picture p34: schematic DC33.kicad_sch]

Parts:
D5: 1.8V/2MA ORANGE; LED_0603_1608Metric; Manufacturer Part Number APT1608LSECK/J4-PRV
J1: SAO; SFH11-NBPC-D03-ST-BK; Manufacturer Part Number SFH11-NBPC-D03-ST-BK
J2: PPTC201LFBN-RC; RPi_Pico_SMD_TH_L; Manufacturer Part Number PPTC201LFBN-RC
J3: PPTC201LFBN-RC; RPi_Pico_SMD_TH_R; Manufacturer Part Number PPTC201LFBN-RC
J4, J5: 282834-3; 2828343; Manufacturer Part Number 282834-3
R20: 0; R_0603_1608Metric; Tolerance 1%; Manufacturer Part Number ERJ-3GEY0R00V; not fitted
R34: 750; R_0603_1608Metric; Tolerance 1%; Manufacturer Part Number ERJ-3EKF7500V
U1: PICO2; Manufacturer Part Number PICO2

Connections:
+3V3: J1.1, J3.36
DISP_BACKLIGHT: J3.21
DISP_DC: J2.7
GND: D5.1 (K), J1.2, J2.3, J2.8, J2.13, J2.18, J3.23, J3.28, J3.33, J3.38, J4.3, J5.3, R20.2
H_CONN: J4.1, J5.1
H_V0: J3.34
H_V1: J3.32
H_V2: J3.31
H_Z0: J3.29
I2C0_SCL: J1.4, J2.2
I2C0_SDA: J1.3, J2.1
I2C_IRQ: J2.20
INT: J2.9
L_CONN: J4.2, J5.2
L_V0: J3.27
L_V1: J3.26
L_V2: J3.25
L_Z0: J3.24
NEO_TX: J3.22
unnamed: D5.2 (A), R34.1
unnamed: J3.37, R20.1
RX_TX_TIE: R34.2
SAO_GPIO1: J1.5
SAO_GPIO2: J1.6
SD_CS: J2.19
SOF: J2.10
SPI0_CS: J2.11
SPI0_RX: J2.6
SPI0_SCK: J2.4
SPI0_TX: J2.5
SPI1_CSn: J2.17
SPI1_RX: J2.16
SPI1_SCK: J2.14
SPI1_TX: J2.15
UART1_RX: J2.12
VBUS: J3.40
VSYS: J3.39
