Maritime-Hacking-Village/Badge-2025/KiCAD/DC33/DC33_analog.kicad_sch

## KiCad design KiCAD/DC33/DC33_analog.kicad_sch (2025-07-31)

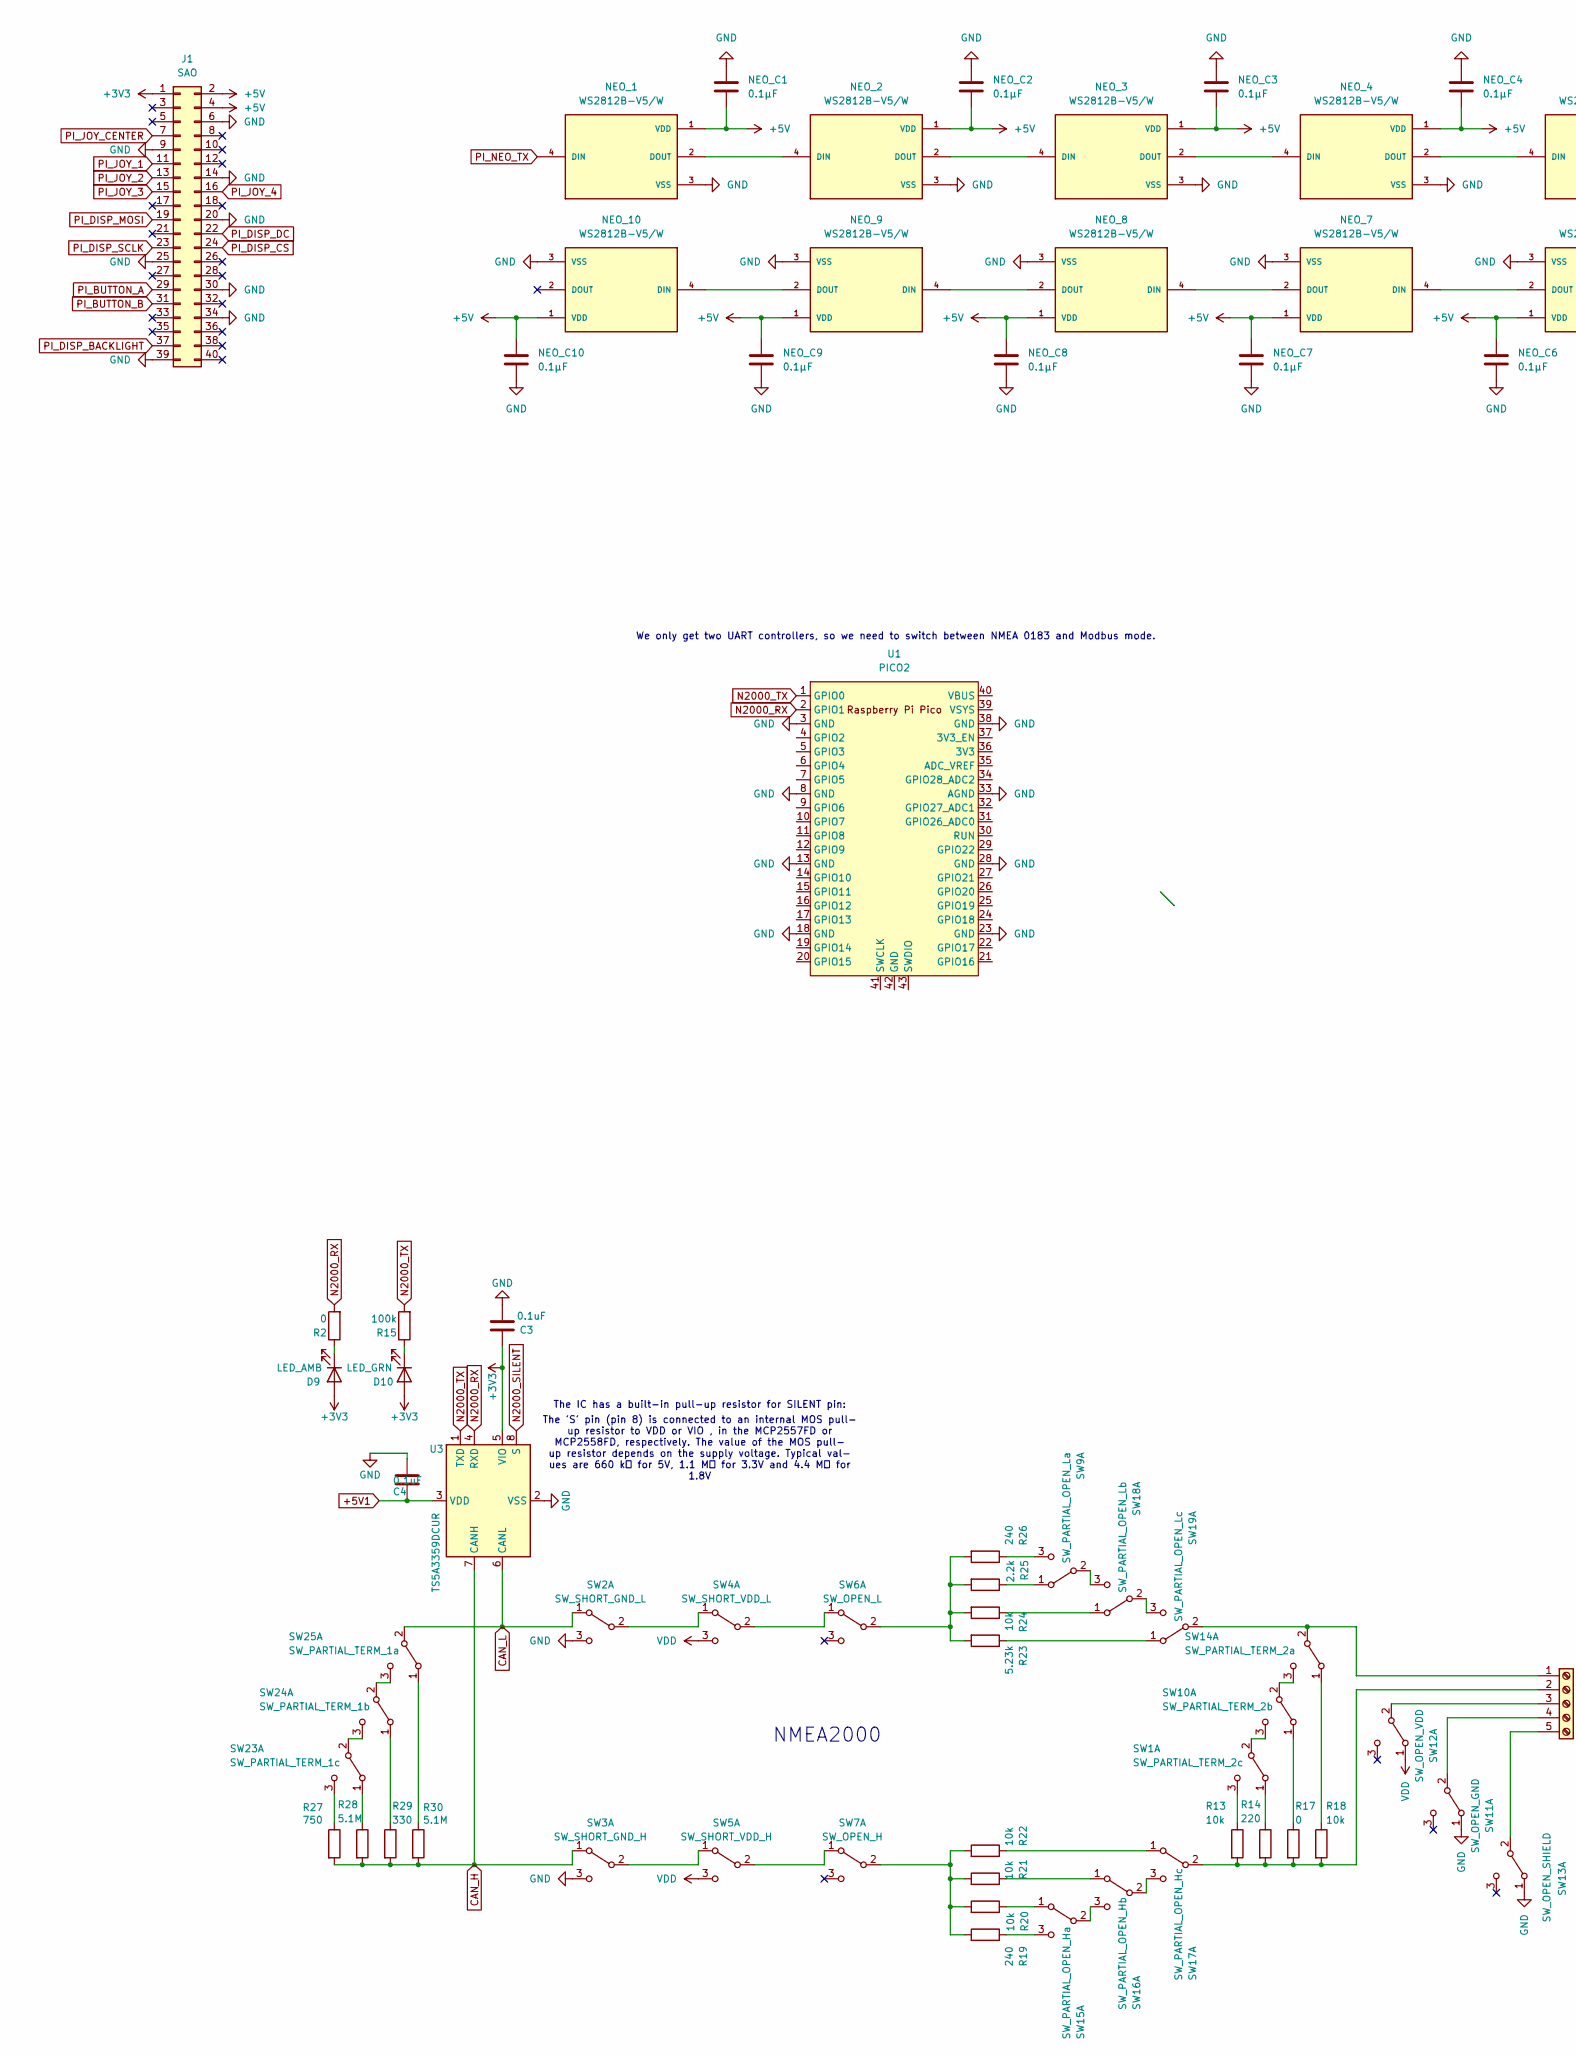
[picture p35: schematic DC33_analog.kicad_sch, part in row 1, column 1]

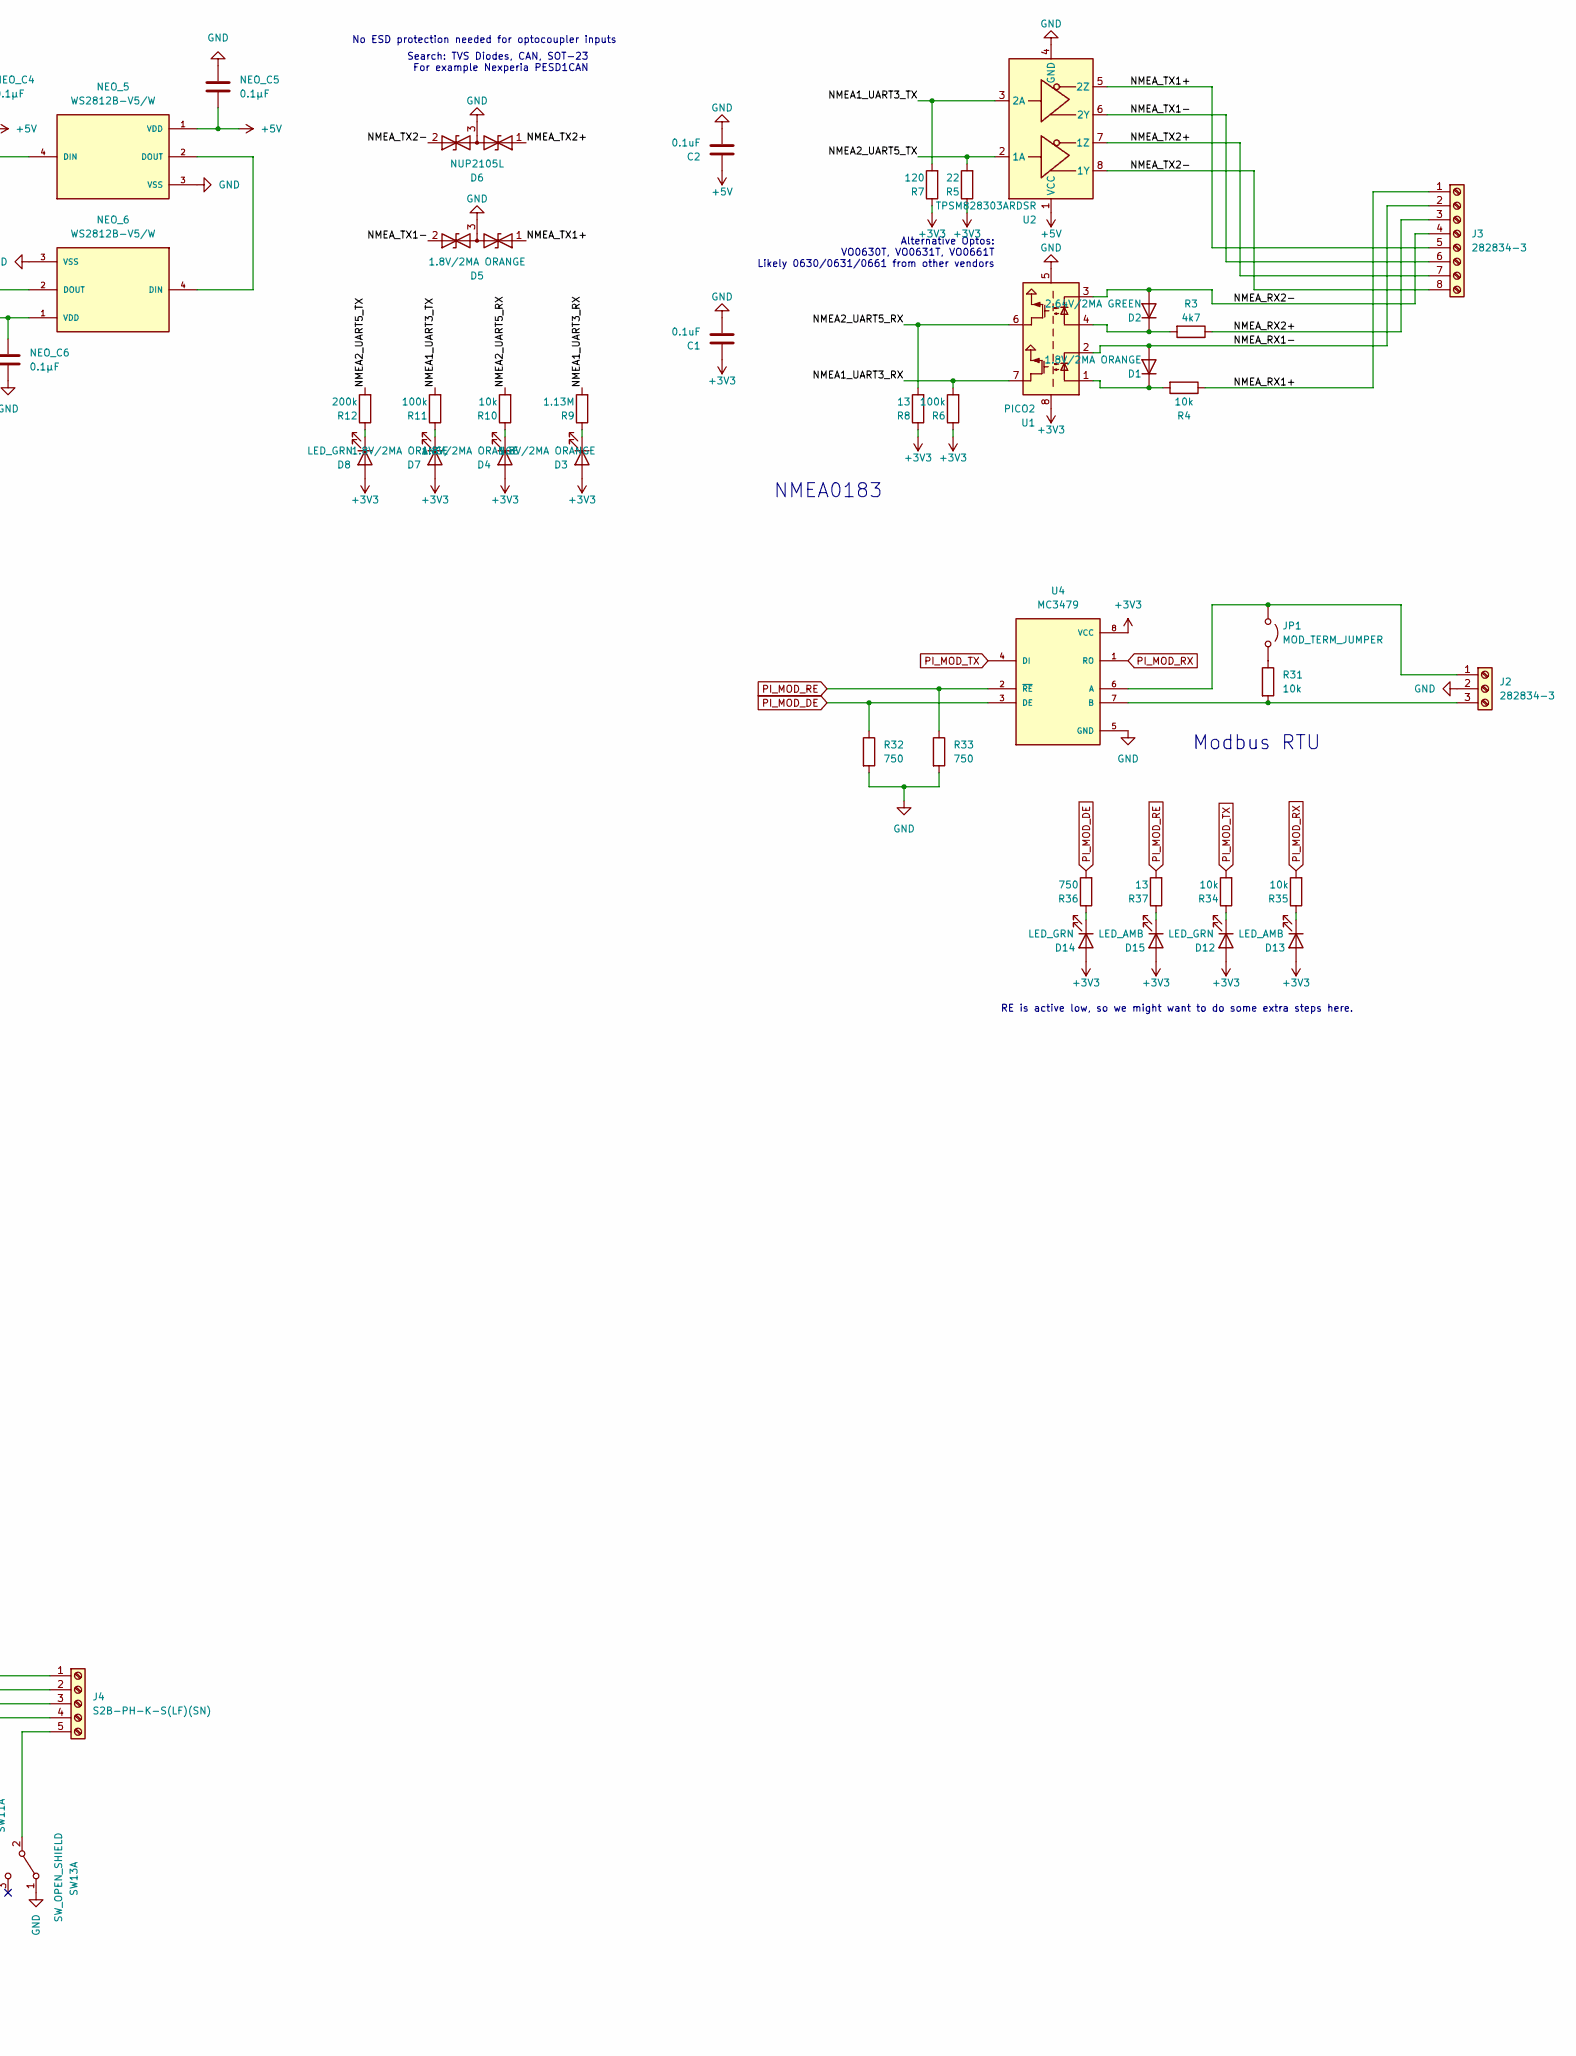
[picture p36: schematic DC33_analog.kicad_sch, part in row 1, column 2]

Parts:
C1, C2, C3, C4: 0.1uF; C_0603_1608Metric; Manufacturer Part Number KGM15BR71E104KT
D1, D3, D4, D5, D7: 1.8V/2MA ORANGE; LED_0603_1608Metric; Manufacturer Part Number APT1608LSECK/J4-PRV
D2: 2.64V/2MA GREEN; LED_0603_1608Metric; Manufacturer Part Number APT1608LZGCK
D6: NUP2105L; SOT-23; Manufacturer Part Number NUP2105LT1G
D8, D10, D12, D14: LED_GRN; LED_0603_1608Metric
D9, D13, D15: LED_AMB; LED_0603_1608Metric
J1: SAO; SFH11-NBPC-D03-ST-BK; Manufacturer Part Number SFH11-NBPC-D03-ST-BK
J2, J3: 282834-3; 2828343; Manufacturer Part Number 282834-3
J4: S2B-PH-K-S(LF)(SN); SHDRRA2W50P0X200_1X2_590X760X480P; Manufacturer_Part_Number SM02B-PASS-TB(LF)(SN)
JP1: MOD_TERM_JUMPER
NEO_1, NEO_2, NEO_3, NEO_4, NEO_6, NEO_7, NEO_8, NEO_9, NEO_10: WS2812B-V5/W; SOL320P540X170-4N; Manufacturer Part Number WS2812B-V5/W
NEO_5: WS2812B-V5/W; SOL320P540X170-4N; Manufacturer_Part_Number WS2812B-V5/W
NEO_C1, NEO_C2, NEO_C3, NEO_C4, NEO_C5, NEO_C6, NEO_C7, NEO_C8, NEO_C9, NEO_C10: 0.1μF
R2, R17: 0; R_0603_1608Metric; Tolerance 1%; Manufacturer Part Number ERJ-3GEY0R00V
R3: 4k7; R_0603_1608Metric; Tolerance 1%; Manufacturer Part Number CRG0603F4K7
R4, R18, R20: 10k; RESPACK_4X0603; Tolerance 1%; Manufacturer Part Number EXB-38V103JV
R5: 22; RESPACK_4X0603; Tolerance 1%; Manufacturer Part Number EXB-38V220JV
R6, R11, R15: 100k; R_0603_1608Metric; Tolerance 1%; Manufacturer Part Number ERJ-3EKF1003V
R7: 120; R_2512_6332Metric; Tolerance 1%; Manufacturer Part Number RC2512FK-07120RL
R8, R37: 13; RES_3540; Tolerance 1%; Manufacturer Part Number 354013RFT
R9: 1.13M; R_0603_1608Metric; Tolerance 1%; Manufacturer Part Number CRCW06031M13FKEA
R10, R13, R21, R22, R24, R31, R34, R35: 10k; R_0603_1608Metric; Tolerance 1%; Manufacturer Part Number CRG0603F10K
R12: 200k; R_0603_1608Metric; Tolerance 1%; Manufacturer Part Number ERJ-3EKF2003V
R14: 220; R_1210_3225Metric; Tolerance 1%; Manufacturer Part Number RC1210FR-07220RL
R19, R26: 240; R_0603_1608Metric; Tolerance 1%; Manufacturer Part Number RC0603FR-07240RL
R23: 5.23k; R_0603_1608Metric; Tolerance 1%; Manufacturer Part Number CRCW06035K23FKEA
R25: 2.2k; R_0603_1608Metric; Tolerance 1%; Manufacturer Part Number CRGCQ0603J2K2
R27, R32, R33, R36: 750; R_0603_1608Metric; Tolerance 1%; Manufacturer Part Number ERJ-3EKF7500V
R28, R30: 5.1M; R_0603_1608Metric; Tolerance 1%; Manufacturer Part Number KTR03EZPF5104
R29: 330; R_0603_1608Metric; Tolerance 1%; Manufacturer Part Number RC0603FR-07330RL
SW1: SW_PARTIAL_TERM_2c
SW2: SW_SHORT_GND_L
SW3: SW_SHORT_GND_H
SW4: SW_SHORT_VDD_L
SW5: SW_SHORT_VDD_H
SW6: SW_OPEN_L
SW7: SW_OPEN_H
SW9: SW_PARTIAL_OPEN_La
SW10: SW_PARTIAL_TERM_2b
SW11: SW_OPEN_GND
SW12: SW_OPEN_VDD
SW13: SW_OPEN_SHIELD
SW14: SW_PARTIAL_TERM_2a
SW15: SW_PARTIAL_OPEN_Ha
SW16: SW_PARTIAL_OPEN_Hb
SW17: SW_PARTIAL_OPEN_Hc
SW18: SW_PARTIAL_OPEN_Lb
SW19: SW_PARTIAL_OPEN_Lc
SW23: SW_PARTIAL_TERM_1c
SW24: SW_PARTIAL_TERM_1b
SW25: SW_PARTIAL_TERM_1a
U1: PICO2; RPi_Pico_SMD_TH; Manufacturer Part Number PICO2
U2: TPSM828303ARDSR; RDS0009A-MFG; MPN UA9638
U3: TS5A3359DCUR; SOP50P310X90-8N; Manufacturer Part Number TS5A3359DCUR
U4: MC3479; Manufacturer Part Number MC3479

Connections:
+3V3: C1.1, C3.1, D3.2 (A), D4.2 (A), D7.2 (A), D8.2 (A), D9.2 (A), D10.2 (A), D12.2 (A), D13.2 (A), D14.2 (A), D15.2 (A), J1.1, R5.1, R6.1, R7.1, R8.1, U1.8 (GND), U3.5 (VIO), U4.8 (VCC)
+5V: C2.1, J1.2, J1.4, NEO_1.1 (VDD), NEO_2.1 (VDD), NEO_3.1 (VDD), NEO_4.1 (VDD), NEO_5.1 (VDD), NEO_6.1 (VDD), NEO_7.1 (VDD), NEO_8.1 (VDD), NEO_9.1 (VDD), NEO_10.1 (VDD), NEO_C1.2, NEO_C2.2, NEO_C3.2, NEO_C4.2, NEO_C5.2, NEO_C6.2, NEO_C7.2, NEO_C8.2, NEO_C9.2, NEO_C10.2, U2.1 (VCC)
+5V1: C4.1, U3.3 (VDD)
CAN_H: R27.2, R28.2, R29.2, R30.2, SW3.1 (A), U3.7 (CANH)
CAN_L: SW2.1 (A), SW25.2 (B), U3.6 (CANL)
GND: C1.2, C2.2, C3.2, C4.2, D5.3 (common), D6.3 (common), J1.6, J1.9, J1.14, J1.20, J1.25, J1.30, J1.34, J1.39, J2.2, NEO_1.3 (VSS), NEO_2.3 (VSS), NEO_3.3 (VSS), NEO_4.3 (VSS), NEO_5.3 (VSS), NEO_6.3 (VSS), NEO_7.3 (VSS), NEO_8.3 (VSS), NEO_9.3 (VSS), NEO_10.3 (VSS), NEO_C1.1, NEO_C2.1, NEO_C3.1, NEO_C4.1, NEO_C5.1, NEO_C6.1, NEO_C7.1, NEO_C8.1, NEO_C9.1, NEO_C10.1, R32.2, R33.2, SW2.3 (C), SW3.3 (C), SW11.1 (A), SW13.1 (A), U1.3 (GND), U1.5 (GPIO3), U1.8 (GND), U1.13 (GND), U1.18 (GND), U1.23 (GND), U1.28 (GND), U1.33 (AGND), U1.38 (GND), U2.4 (GND), U3.2 (VSS), U3.9 (VSS), U4.5 (GND)
N2000_RX: R2.2, U1.2 (GPIO1), U3.4 (RXD)
N2000_SILENT: U3.8 (S)
N2000_TX: R15.2, U1.1 (GPIO0), U3.1 (TXD)
NMEA1_UART3_RX: R6.2, R9.2, U1.7 (GPIO5)
NMEA1_UART3_TX: R7.2, R11.2, U2.3 (2A)
NMEA2_UART5_RX: R8.2, R10.2, U1.6 (GPIO4)
NMEA2_UART5_TX: R5.2, R12.2, U2.2 (1A)
NMEA_RX1+: J3.1, R4.1
NMEA_RX1-: D1.2 (A), J3.2, U1.2 (GPIO1)
NMEA_RX2+: J3.3, R3.1
NMEA_RX2-: D2.2 (A), J3.4, U1.3 (GND)
NMEA_TX1+: D5.1 (A1), J3.5, U2.5 (2Z)
NMEA_TX1-: D5.2 (A2), J3.6, U2.6 (2Y)
NMEA_TX2+: D6.1 (A1), J3.7, U2.7 (1Z)
NMEA_TX2-: D6.2 (A2), J3.8, U2.8 (1Y)
unnamed: D1.1 (K), R4.2, U1.1 (GPIO0)
unnamed: D2.1 (K), R3.2, U1.4 (GPIO2)
unnamed: D3.1 (K), R9.1
unnamed: D4.1 (K), R10.1
unnamed: D7.1 (K), R11.1
unnamed: D8.1 (K), R12.1
unnamed: D9.1 (K), R2.1
unnamed: D10.1 (K), R15.1
unnamed: D12.1 (K), R34.1
unnamed: D13.1 (K), R35.1
unnamed: D14.1 (K), R36.1
unnamed: D15.1 (K), R37.1
unnamed: J2.1, JP1.1 (A), U4.6 (A)
unnamed: J2.3, R31.2, U4.7 (B)
unnamed: J4.1, SW14.2 (B), SW19.2 (B)
unnamed: J4.2, R13.2, R14.2, R17.2, R18.2, SW17.2 (B)
unnamed: J4.3, SW12.2 (B)
unnamed: J4.4, SW11.2 (B)
unnamed: J4.5, SW13.2 (B)
unnamed: JP1.2 (B), R31.1
unnamed: NEO_1.2 (DOUT), NEO_2.4 (DIN)
unnamed: NEO_2.2 (DOUT), NEO_3.4 (DIN)
unnamed: NEO_3.2 (DOUT), NEO_4.4 (DIN)
unnamed: NEO_4.2 (DOUT), NEO_5.4 (DIN)
unnamed: NEO_5.2 (DOUT), NEO_6.4 (DIN)
unnamed: NEO_6.2 (DOUT), NEO_7.4 (DIN)
unnamed: NEO_7.2 (DOUT), NEO_8.4 (DIN)
unnamed: NEO_8.2 (DOUT), NEO_9.4 (DIN)
unnamed: NEO_9.2 (DOUT), NEO_10.4 (DIN)
unnamed: R13.1, SW1.3 (C)
unnamed: R14.1, SW1.1 (A)
unnamed: R17.1, SW10.1 (A)
unnamed: R18.1, SW14.1 (A)
unnamed: R19.1, SW15.3 (C)
unnamed: R19.2, R20.2, R21.2, R22.2, SW7.2 (B)
unnamed: R20.1, SW15.1 (A)
unnamed: R21.1, SW16.1 (A)
unnamed: R22.1, SW17.1 (A)
unnamed: R23.1, SW19.1 (A)
unnamed: R23.2, R24.2, R25.2, R26.2, SW6.2 (B)
unnamed: R24.1, SW18.1 (A)
unnamed: R25.1, SW9.1 (A)
unnamed: R26.1, SW9.3 (C)
unnamed: R27.1, SW23.3 (C)
unnamed: R28.1, SW23.1 (A)
unnamed: R29.1, SW24.1 (A)
unnamed: R30.1, SW25.1 (A)
unnamed: SW1.2 (B), SW10.3 (C)
unnamed: SW2.2 (B), SW4.1 (A)
unnamed: SW3.2 (B), SW5.1 (A)
unnamed: SW4.2 (B), SW6.1 (A)
unnamed: SW5.2 (B), SW7.1 (A)
unnamed: SW10.2 (B), SW14.3 (C)
unnamed: SW15.2 (B), SW16.3 (C)
unnamed: SW16.2 (B), SW17.3 (C)
unnamed: SW18.2 (B), SW19.3 (C)
unnamed: SW9.2 (B), SW18.3 (C)
unnamed: SW23.2 (B), SW24.3 (C)
unnamed: SW24.2 (B), SW25.3 (C)
PI_BUTTON_A: J1.29
PI_BUTTON_B: J1.31
PI_DISP_BACKLIGHT: J1.37
PI_DISP_CS: J1.24
PI_DISP_DC: J1.22
PI_DISP_MOSI: J1.19
PI_DISP_SCLK: J1.23
PI_JOY_1: J1.11
PI_JOY_2: J1.13
PI_JOY_3: J1.15
PI_JOY_4: J1.16
PI_JOY_CENTER: J1.7
PI_MOD_DE: R32.1, R36.2, U4.3 (DE)
PI_MOD_RE: R33.1, R37.2, U4.2 (~RE)
PI_MOD_RX: R35.2, U4.1 (RO)
PI_MOD_TX: R34.2, U4.4 (DI)
PI_NEO_TX: NEO_1.4 (DIN)
VDD: SW4.3 (C), SW5.3 (C), SW12.1 (A)

Notes on the sheet:
Search: TVS Diodes, CAN, SOT-23 For example Nexperia PESD1CAN
NMEA0183
Alternative Optos: VO0630T, VO0631T, VO0661T Likely 0630/0631/0661 from other vendors
NMEA2000
The 'S' pin (pin 8) is connected to an internal MOS pull- up resistor to VDD or VIO , in the MCP2557FD or MCP2558FD, respectively. The value of the MOS pull- up resistor depends on the supply voltage. Typical val- ues are 660 k for 5V, 1.1 M for 3.3V and 4.4 M for 1.8V
No ESD protection needed for optocoupler inputs
We only get two UART controllers, so we need to switch between NMEA 0183 and Modbus mode.
Modbus RTU
RE is active low, so we might want to do some extra steps here.
The IC has a built-in pull-up resistor for SILENT pin:
