Maritime-Hacking-Village/Badge-2025/KiCAD/DC33/can_injector.kicad_sch

## KiCad design KiCAD/DC33/can_injector.kicad_sch (2026-07-09)

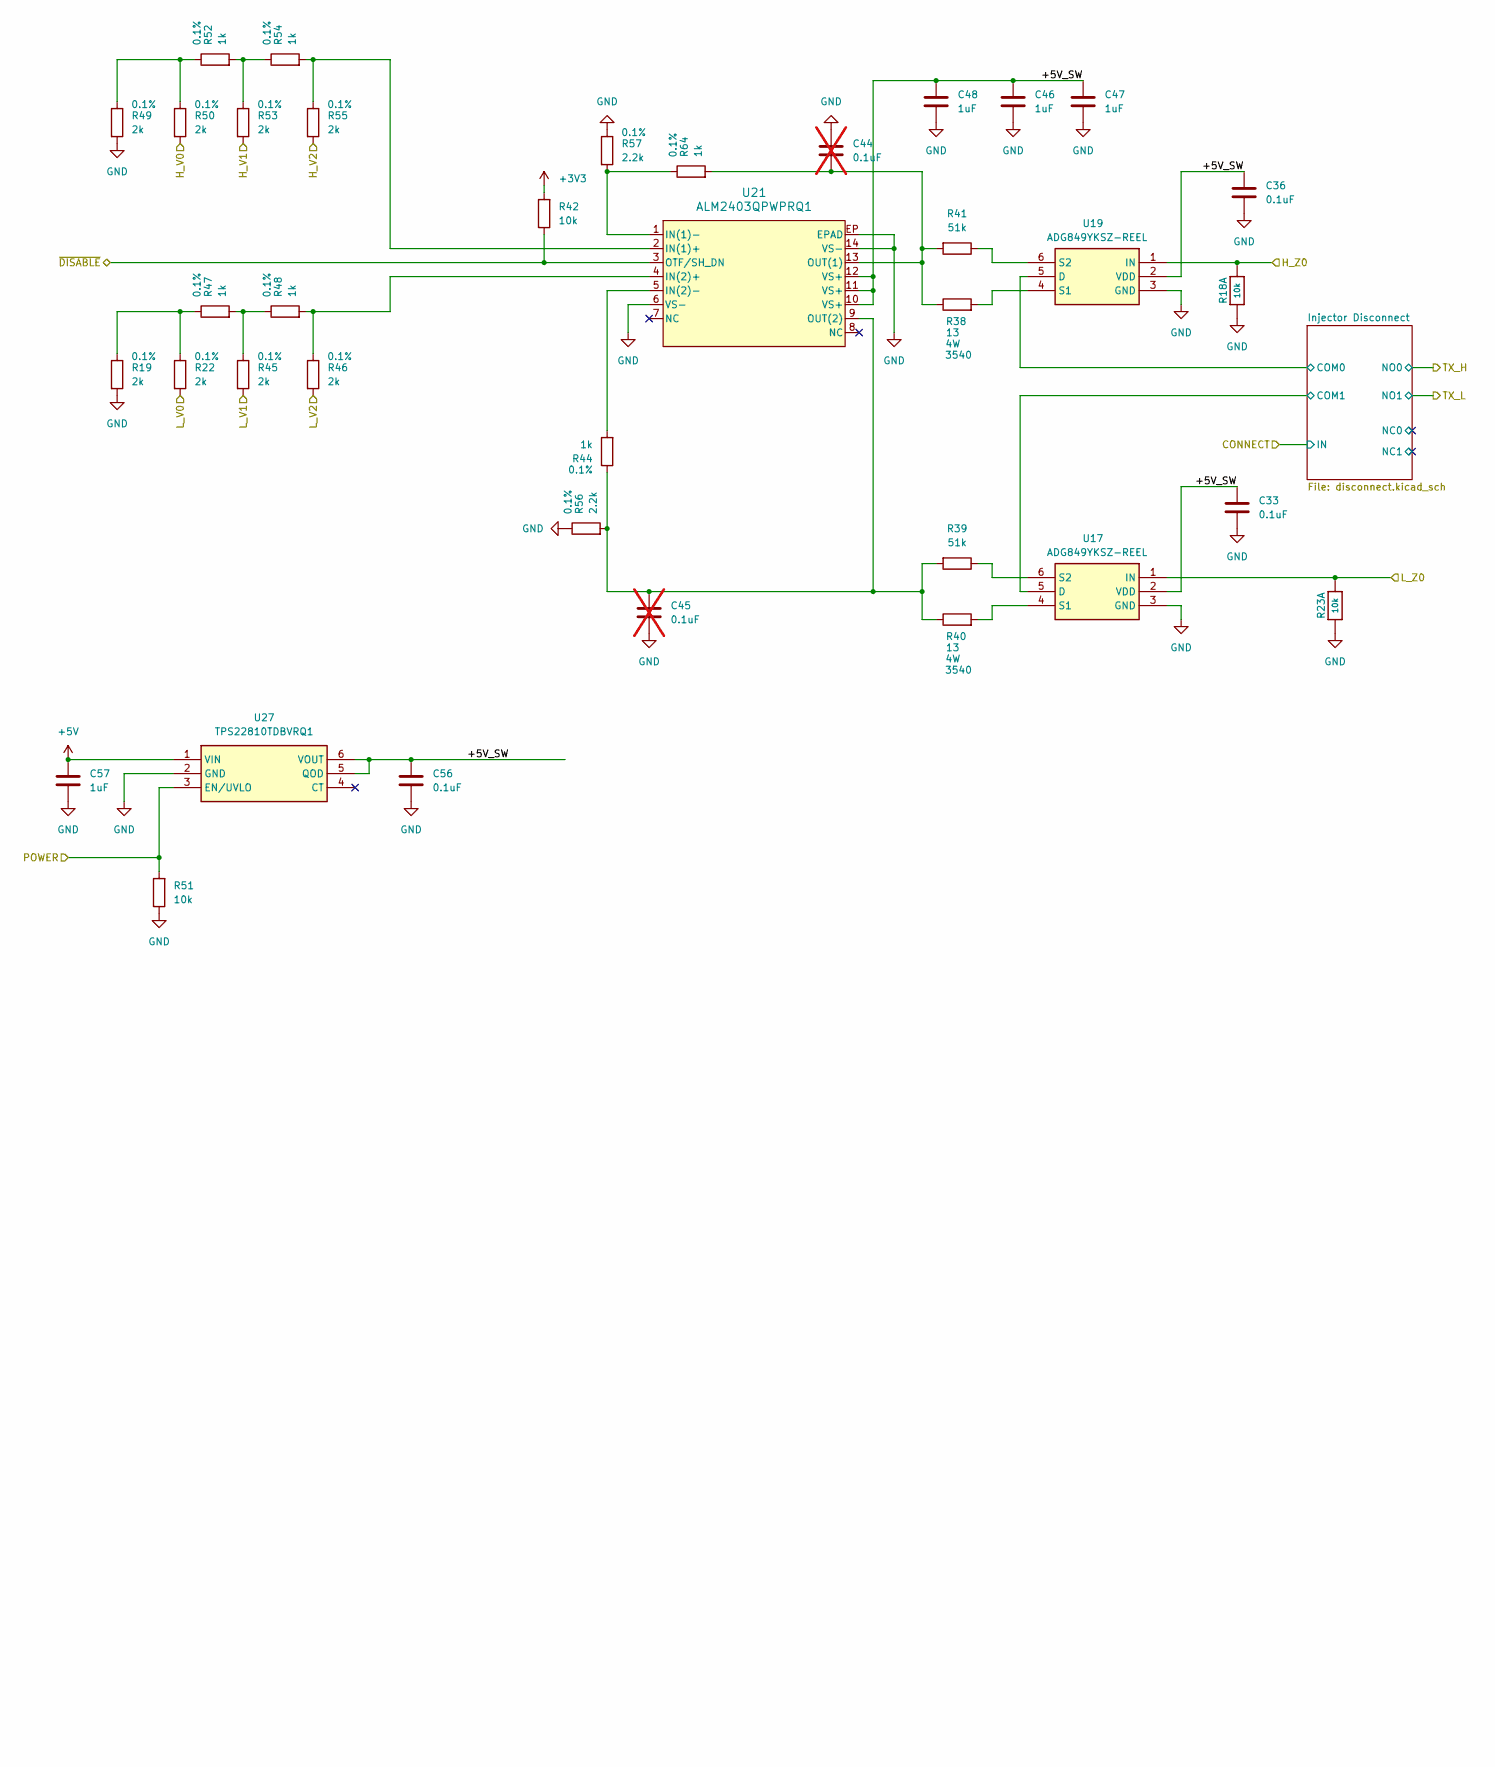
[picture p37: schematic can_injector.kicad_sch, part in row 1, column 1]

Parts:
C33, C36, C56: 0.1uF; C_0603_1608Metric; Manufacturer Part Number KGM15BR71E104KT
C44, C45: 0.1uF; C_0603_1608Metric; Manufacturer Part Number KGM15BR71E104KT; not fitted
C46, C47, C48, C57: 1uF; C_0603_1608Metric; Manufacturer Part Number CC0603KRX7R9BB105
R18, R23: 10k; RESPACK_4X0603; Tolerance 1%; Manufacturer Part Number EXB-38V103JV
R19, R22, R45, R46, R49, R50, R53, R55: 2k; R_0603_1608Metric; Tolerance 0.1%; Manufacturer Part Number ERA-3AEB202V
R38, R40: 13; RES_3540; Tolerance 1%; Manufacturer Part Number 354013RFT
R39, R41: 51k; R_0603_1608Metric; Tolerance 1%; Manufacturer Part Number RC0603FR-0751KL
R42, R51: 10k; R_0603_1608Metric; Tolerance 1%; Manufacturer Part Number CRG0603F10K
R44, R47, R48, R52, R54, R64: 1k; R_0603_1608Metric; Tolerance 0.1%; Manufacturer Part Number ERA-3AEB102V
R56, R57: 2.2k; R_0603_1608Metric; Tolerance 0.1%; Manufacturer Part Number ERA-3AEB102V
U17, U19: ADG849YKSZ-REEL; SOT65P210X110-6N; Manufacturer Part Number ADG849YKSZ-REEL
U21: ALM2403QPWPRQ1; ALM2403QPWPRQ1_TEX; Manufacturer Part Number ALM2403QPWPRQ1
U27: TPS22810TDBVRQ1; SOT95P280X145-6N; Manufacturer Part Number TPS22810TDBVRQ1

Connections:
+3V3: R42.2
+5V: C57.1, U27.1 (VIN)
+5V_SW: C33.1, C36.1, C46.1, C47.1, C48.1, C56.1, U17.2 (VDD), U19.2 (VDD), U21.10 (VS+), U21.11 (VS+), U21.12 (VS+), U27.5 (QOD), U27.6 (VOUT)
COM0: U19.5 (D)
COM1: U17.5 (D)
GND: C33.2, C36.2, C44.1, C45.2, C46.2, C47.2, C48.2, C56.2, C57.2, R18.1, R19.2, R23.1, R49.2, R51.1, R56.1, R57.1, U17.3 (GND), U19.3 (GND), U21.6 (VS-), U21.14 (VS-), U21.EP (EPAD), U27.2 (GND)
H_V0: R50.2
H_V1: R53.2
H_V2: R55.2
H_Z0: R18.8 (2), U19.1 (IN)
L_V0: R22.2
L_V1: R45.2
L_V2: R46.2
L_Z0: R23.8 (2), U17.1 (IN)
unnamed: C44.2, R38.1, R41.2, R64.2, U21.13 (OUT(1))
unnamed: C45.1, R39.2, R40.1, R44.1, R56.2, U21.9 (OUT(2))
unnamed: R19.1, R22.1, R47.1
unnamed: R38.2, U19.4 (S1)
unnamed: R39.1, U17.6 (S2)
unnamed: R40.2, U17.4 (S1)
unnamed: R41.1, U19.6 (S2)
unnamed: R44.2, U21.5 (IN(2)-)
unnamed: R45.1, R47.2, R48.1
unnamed: R46.1, R48.2, U21.4 (IN(2)+)
unnamed: R49.1, R50.1, R52.1
unnamed: R52.2, R53.1, R54.1
unnamed: R54.2, R55.1, U21.2 (IN(1)+)
unnamed: R57.2, R64.1, U21.1 (IN(1)-)
POWER: R51.2, U27.3 (EN/UVLO)
~DISABLE: R42.1, U21.3 (OTF/SH_DN)
