Maritime-Hacking-Village/Badge-2025/KiCAD/DC33/can_protection.kicad_sch

## KiCad design KiCAD/DC33/can_protection.kicad_sch (2025-07-31)

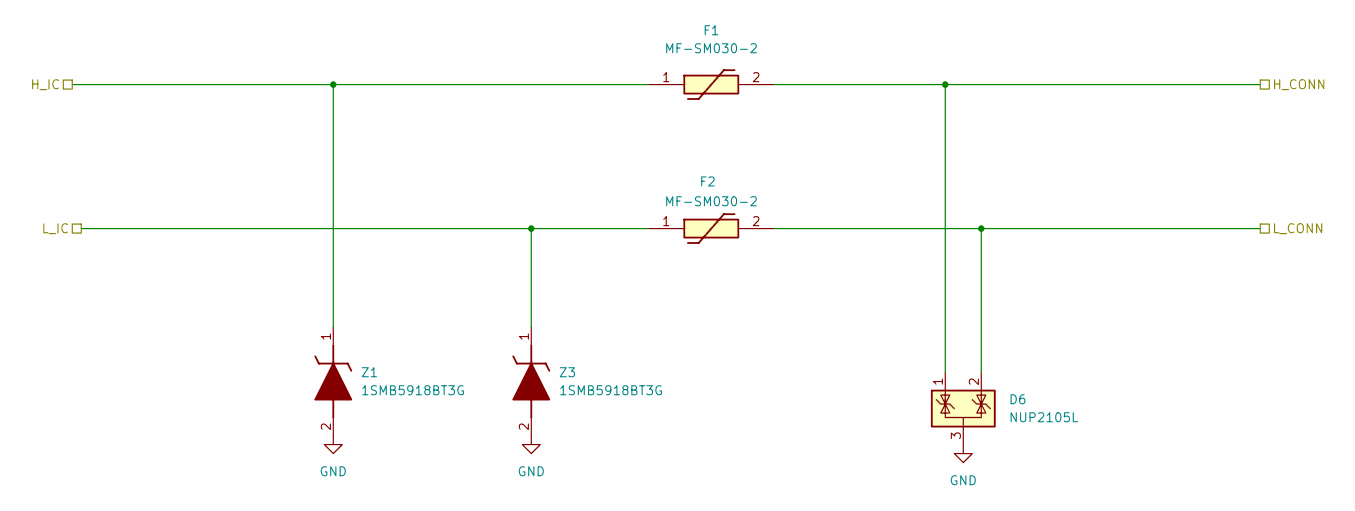
[picture p38: schematic can_protection.kicad_sch]

Parts:
D6: NUP2105L; SOT-23; Manufacturer Part Number NUP2105LT1G
F1, F2: MF-SM030-2; MFSM0302; Manufacturer Part Number MF-SM030-2
Z1, Z3: 1SMB5918BT3G; DIOM5436X247N; Manufacturer Part Number 1SMB5918BT3G

Connections:
GND: D6.3 (A), Z1.2 (A), Z3.2 (A)
H_CONN: D6.1 (K), F1.2
H_IC: F1.1, Z1.1 (K)
L_CONN: D6.2 (K), F2.2
L_IC: F2.1, Z3.1 (K)
