Maritime-Hacking-Village/Badge-2025/KiCAD/DC33/can_trx.kicad_sch

## KiCad design KiCAD/DC33/can_trx.kicad_sch (2026-07-09)

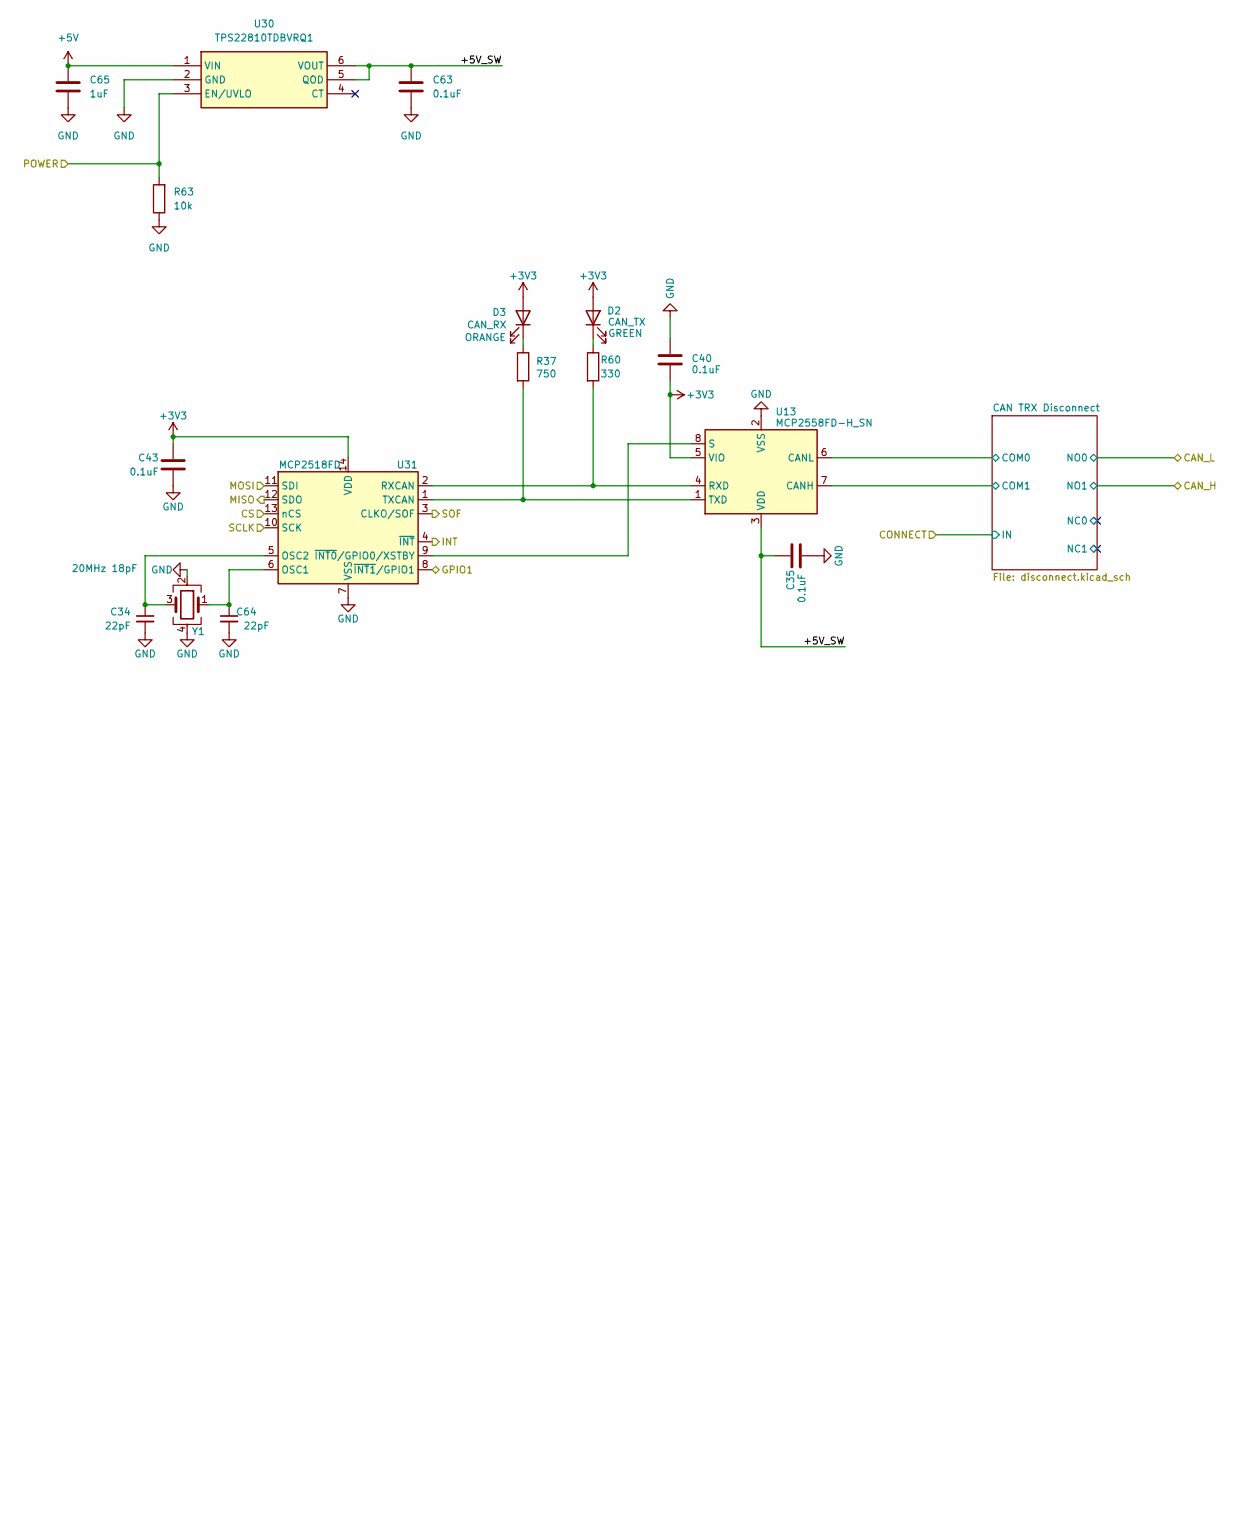
[picture p39: schematic can_trx.kicad_sch, part in row 1, column 1]

Parts:
C34, C64: 22pF; C_0603_1608Metric; Manufacturer Part Number CC0603JPNPO9BN220
C35, C40, C43, C63: 0.1uF; C_0603_1608Metric; Manufacturer Part Number KGM15BR71E104KT
C65: 1uF; C_0603_1608Metric; Manufacturer Part Number CC0603KRX7R9BB105
D2: 2.64V/2MA GREEN; LED_0603_1608Metric; Manufacturer Part Number APT1608LZGCK
D3: 1.8V/2MA ORANGE; LED_0603_1608Metric; Manufacturer Part Number APT1608LSECK/J4-PRV
R37: 750; R_0603_1608Metric; Tolerance 1%; Manufacturer Part Number ERJ-3EKF7500V
R60: 330; R_0603_1608Metric; Tolerance 1%; Manufacturer Part Number ERJ-3EKF3300V
R63: 10k; R_0603_1608Metric; Tolerance 1%; Manufacturer Part Number CRG0603F10K
U13: MCP2558FD-H_SN; SOIC127P600X175-8N; Manufacturer Part Number MCP2558FD-H/SN
U30: TPS22810TDBVRQ1; SOT95P280X145-6N; Manufacturer Part Number TPS22810TDBVRQ1
U31: MCP2518FD; SOIC-14_3.9x8.7mm_P1.27mm; Manufacturer Part Number MCP2518FDT-E/SL
Y1: 20MHz 18pF; Crystal_SMD_3225-4Pin_3.2x2.5mm; Manufacturer Part Number ECS-200-18-33-JGN-TR

Connections:
+3V3: C40.2, C43.1, D2.2 (A), D3.2 (A), U13.5 (VIO), U31.14 (VDD)
+5V: C65.1, U30.1 (VIN)
+5V_SW: C35.1, C63.1, U13.3 (VDD), U30.5 (QOD), U30.6 (VOUT)
COM0: U13.6 (CANL)
COM1: U13.7 (CANH)
CS: U31.13 (nCS)
GND: C34.2, C35.2, C40.1, C43.2, C63.2, C64.2, C65.2, R63.1, U13.2 (VSS), U30.2 (GND), U31.7 (VSS), Y1.2, Y1.4
GPIO1: U31.8 (~INT1/GPIO1)
INT: U31.4 (~INT)
MISO: U31.12 (SDO)
MOSI: U31.11 (SDI)
unnamed: C34.1, U31.5 (OSC2), Y1.3
unnamed: C64.1, U31.6 (OSC1), Y1.1
unnamed: D2.1 (K), R60.1
unnamed: D3.1 (K), R37.1
unnamed: R37.2, U13.1 (TXD), U31.1 (TXCAN)
unnamed: R60.2, U13.4 (RXD), U31.2 (RXCAN)
unnamed: U13.8 (S), U31.9 (~INT0/GPIO0/XSTBY)
POWER: R63.2, U30.3 (EN/UVLO)
SCLK: U31.10 (SCK)
SOF: U31.3 (CLKO/SOF)
