Maritime-Hacking-Village/Badge-2025/KiCAD/DC33/disconnect.kicad_sch

## KiCad design KiCAD/DC33/disconnect.kicad_sch (2025-07-31)

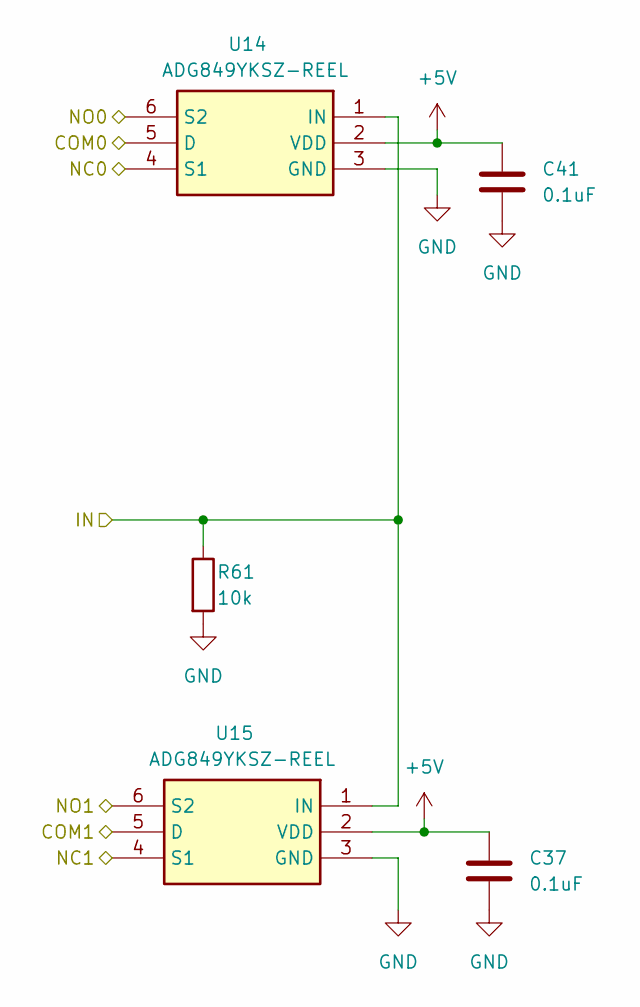
[picture p40: schematic disconnect.kicad_sch]

Parts:
C37, C41: 0.1uF; C_0603_1608Metric; Manufacturer Part Number KGM15BR71E104KT
R61: 10k; R_0603_1608Metric; Tolerance 1%; Manufacturer Part Number CRG0603F10K
U14, U15: ADG849YKSZ-REEL; SOT65P210X110-6N; Manufacturer Part Number ADG849YKSZ-REEL

Connections:
+5V: C37.1, C41.1, U14.2 (VDD), U15.2 (VDD)
COM0: U14.5 (D)
COM1: U15.5 (D)
GND: C37.2, C41.2, R61.2, U14.3 (GND), U15.3 (GND)
IN: R61.1, U14.1 (IN), U15.1 (IN)
NC0: U14.4 (S1)
NC1: U15.4 (S1)
NO0: U14.6 (S2)
NO1: U15.6 (S2)
