Maritime-Hacking-Village/Badge-2025/KiCAD/DC33/display_sd.kicad_sch

## KiCad design KiCAD/DC33/display_sd.kicad_sch (2026-07-09)

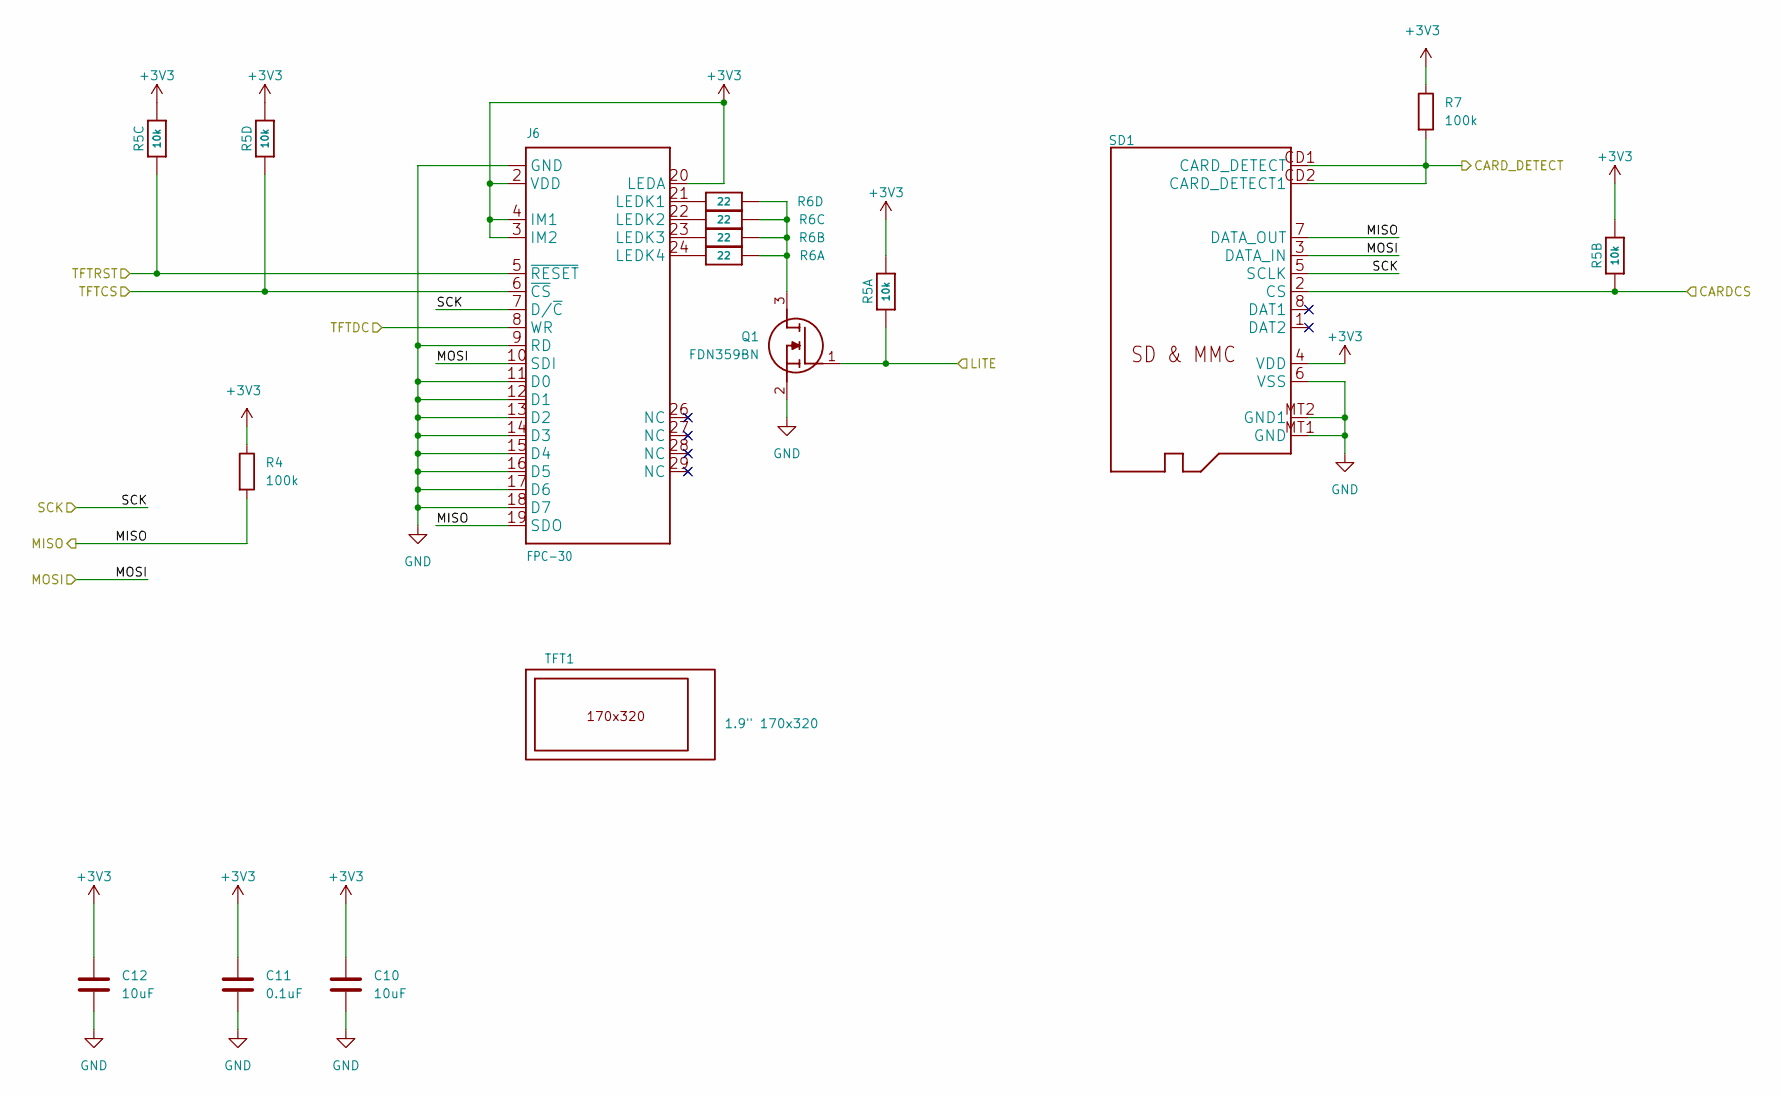
[picture p41: schematic display_sd.kicad_sch]

Parts:
C10, C12: 10uF; C_0603_1608Metric; Manufacturer Part Number GRM188R61E106MA73J
C11: 0.1uF; C_0603_1608Metric; Manufacturer Part Number KGM15BR71E104KT
J6: FPC-30; CON_541043031_MOL; Manufacturer Part Number 0541043031
Q1: FDN359BN; SOT95P251X112-3N; Manufacturer Part Number FDN359BN
R4, R7: 100k; R_0603_1608Metric; Tolerance 1%; Manufacturer Part Number ERJ-3EKF1003V
R5: 10k; RESPACK_4X0603; Tolerance 1%; Manufacturer Part Number EXB-38V103JV
R6: 22; RESPACK_4X0603; Tolerance 1%; Manufacturer Part Number EXB-38V220JV
SD1: MICROSD; Manufacturer Part Number 2908-05WB-MG
TFT1: 1.9" 170x320; TFT_1.9IN_170X320_30P; Manufacturer Part Number T190X7-C30-01

Connections:
+3V3: C10.1, C11.1, C12.1, J6.2 (VDD), J6.3 (IM2), J6.4 (IM1), J6.20 (LEDA), R4.1, R5.5 (2), R5.6 (2), R5.7 (2), R5.8 (2), R7.1, SD1.4 (VDD)
CARDCS: R5.2 (1), SD1.2 (CS)
CARD_DETECT: R7.2, SD1.CD1 (CARD_DETECT), SD1.CD2 (CARD_DETECT1)
GND: C10.2, C11.2, C12.2, J6.1 (GND), J6.9 (RD), J6.11 (D0), J6.12 (D1), J6.13 (D2), J6.14 (D3), J6.15 (D4), J6.16 (D5), J6.17 (D6), J6.18 (D7), J6.25 (GND), J6.30 (GND), J6.MNT1 (GND), J6.MNT2 (GND), Q1.2 (S), SD1.6 (VSS), SD1.MT1 (GND), SD1.MT2 (GND1)
LITE: Q1.1 (G), R5.1
MISO: J6.19 (SDO), R4.2, SD1.7 (DATA_OUT)
MOSI: J6.10 (SDI), SD1.3 (DATA_IN)
unnamed: J6.21 (LEDK1), R6.4 (1)
unnamed: J6.22 (LEDK2), R6.3 (1)
unnamed: J6.23 (LEDK3), R6.2 (1)
unnamed: J6.24 (LEDK4), R6.1
unnamed: Q1.3 (D), R6.5 (2), R6.6 (2), R6.7 (2), R6.8 (2)
SCK: J6.7 (D/~C), SD1.5 (SCLK)
TFTCS: J6.6 (~CS), R5.4 (1)
TFTDC: J6.8 (WR)
TFTRST: J6.5 (~RESET), R5.3 (1)
