Maritime-Hacking-Village/Badge-2025/KiCAD/DC33/gpio_buttons.kicad_sch

## KiCad design KiCAD/DC33/gpio_buttons.kicad_sch (2026-07-09)

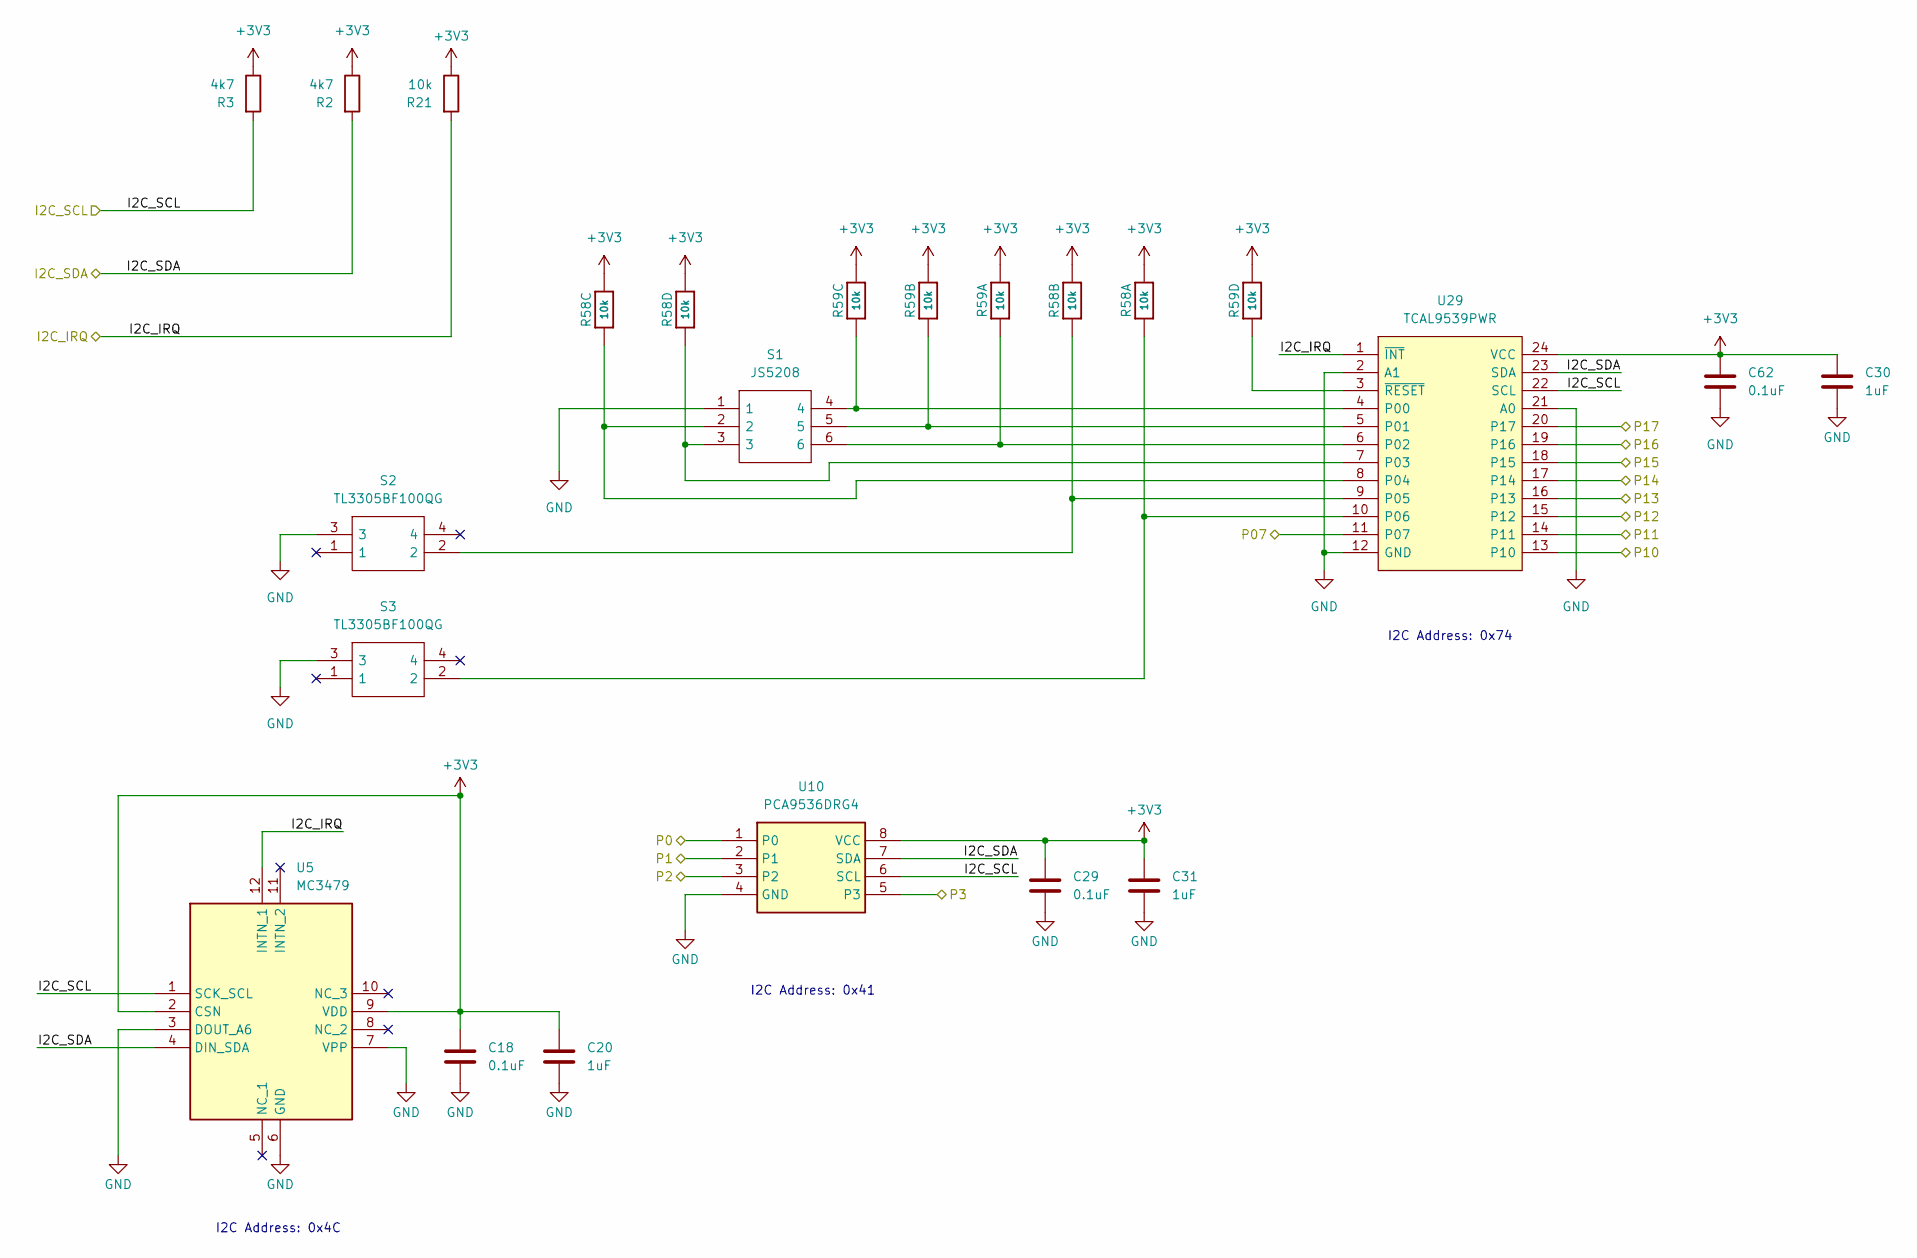
[picture p42: schematic gpio_buttons.kicad_sch]

Parts:
C18, C29, C62: 0.1uF; C_0603_1608Metric; Manufacturer Part Number KGM15BR71E104KT
C20, C30, C31: 1uF; C_0603_1608Metric; Manufacturer Part Number CC0603KRX7R9BB105
R2, R3: 4k7; R_0603_1608Metric; Tolerance 1%; Manufacturer Part Number CRG0603F4K7
R21: 10k; R_0603_1608Metric; Tolerance 1%; Manufacturer Part Number CRG0603F10K
R58, R59: 10k; RESPACK_4X0603; Tolerance 1%; Manufacturer Part Number EXB-38V103JV
S1: JS5208; Manufacturer Part Number JS5208
S2, S3: TL3305BF100QG; TL3305BF160QG; Manufacturer Part Number TL3305BF100QG
U5: MC3479; Manufacturer Part Number MC3479
U10: PCA9536DRG4; SOIC127P600X175-8N; Manufacturer Part Number PCA9536DRG4
U29: TCAL9539PWR; SOP65P640X120-24N; Manufacturer Part Number TCAL9539PWR

Connections:
+3V3: C18.1, C20.1, C29.1, C30.1, C31.1, C62.1, R2.1, R3.1, R21.1, R58.5 (2), R58.6 (2), R58.7 (2), R58.8 (2), R59.5 (2), R59.6 (2), R59.7 (2), R59.8 (2), U5.2 (CSN), U5.9 (VDD), U10.8 (VCC), U29.24 (VCC)
GND: C18.2, C20.2, C29.2, C30.2, C31.2, C62.2, S1.1, S2.3, S3.3, U5.3 (DOUT_A6), U5.6 (GND), U5.7 (VPP), U10.4 (GND), U29.2 (A1), U29.12 (GND), U29.21 (A0)
I2C_IRQ: R21.2, U5.12 (INTN_1), U29.1 (~INT)
I2C_SCL: R3.2, U5.1 (SCK_SCL), U10.6 (SCL), U29.22 (SCL)
I2C_SDA: R2.2, U5.4 (DIN_SDA), U10.7 (SDA), U29.23 (SDA)
unnamed: R58.1, S3.2, U29.10 (P06)
unnamed: R58.2 (1), S2.2, U29.9 (P05)
unnamed: R58.3 (1), S1.2, U29.8 (P04)
unnamed: R58.4 (1), S1.3, U29.7 (P03)
unnamed: R59.1, S1.6, U29.6 (P02)
unnamed: R59.2 (1), S1.5, U29.5 (P01)
unnamed: R59.3 (1), S1.4, U29.4 (P00)
unnamed: R59.4 (1), U29.3 (~RESET)
P0: U10.1 (P0)
P1: U10.2 (P1)
P2: U10.3 (P2)
P3: U10.5 (P3)
P07: U29.11 (P07)
P10: U29.13 (P10)
P11: U29.14 (P11)
P12: U29.15 (P12)
P13: U29.16 (P13)
P14: U29.17 (P14)
P15: U29.18 (P15)
P16: U29.19 (P16)
P17: U29.20 (P17)

Notes on the sheet:
I2C Address: 0x4C
I2C Address: 0x74
I2C Address: 0x41
