Maritime-Hacking-Village/Badge-2025/KiCAD/DC33/neopixel.kicad_sch

## KiCad design KiCAD/DC33/neopixel.kicad_sch (2026-07-09)

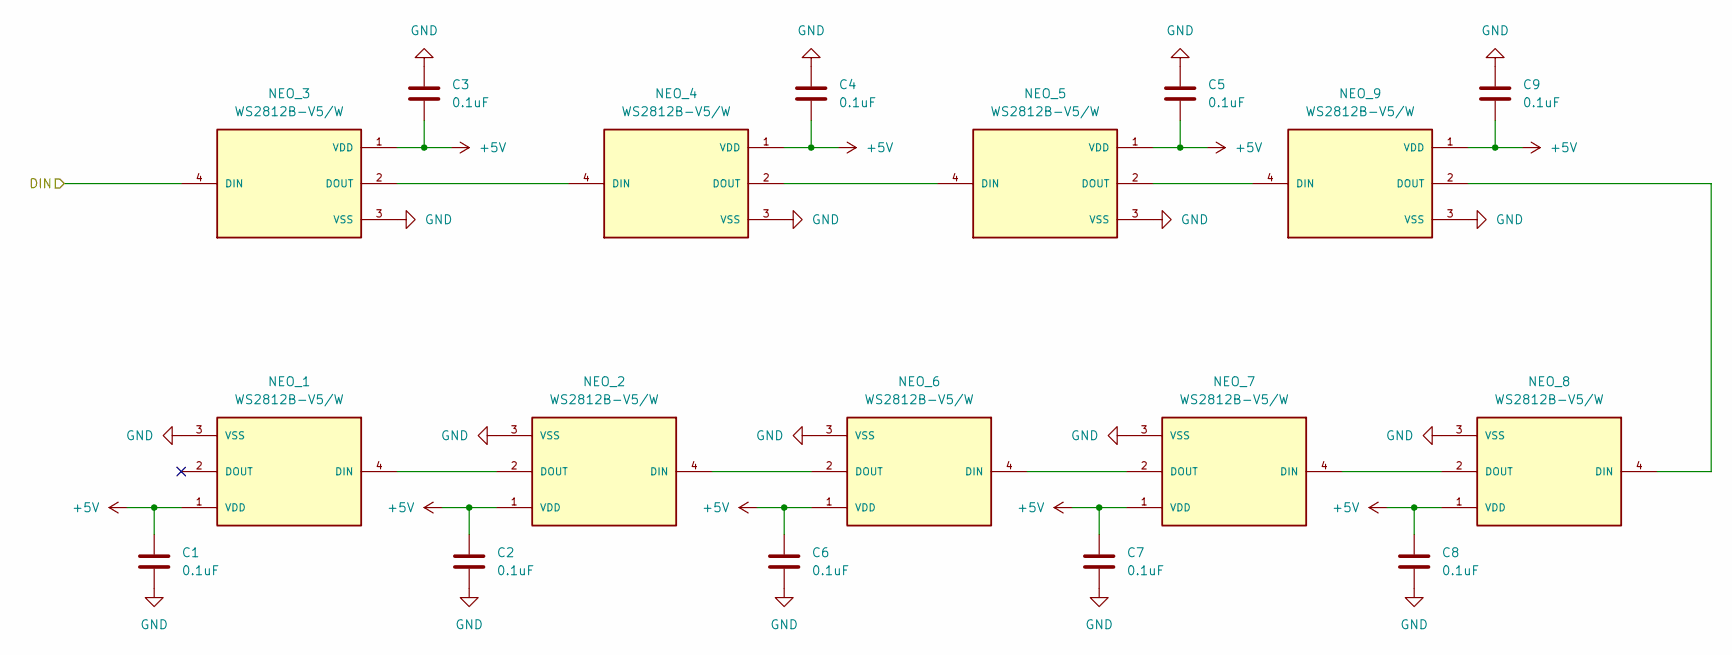
[picture p43: schematic neopixel.kicad_sch]

Parts:
C1, C2, C3, C4, C5, C6, C7, C8, C9: 0.1uF; C_0603_1608Metric; Manufacturer Part Number KGM15BR71E104KT
NEO_1, NEO_2, NEO_3, NEO_4, NEO_5, NEO_6, NEO_7, NEO_8, NEO_9: WS2812B-V5/W; SOL320P540X170-4N; Manufacturer Part Number WS2812B-V5/W

Connections:
+5V: C1.2, C2.2, C3.2, C4.2, C5.2, C6.2, C7.2, C8.2, C9.2, NEO_1.1 (VDD), NEO_2.1 (VDD), NEO_3.1 (VDD), NEO_4.1 (VDD), NEO_5.1 (VDD), NEO_6.1 (VDD), NEO_7.1 (VDD), NEO_8.1 (VDD), NEO_9.1 (VDD)
DIN: NEO_3.4 (DIN)
GND: C1.1, C2.1, C3.1, C4.1, C5.1, C6.1, C7.1, C8.1, C9.1, NEO_1.3 (VSS), NEO_2.3 (VSS), NEO_3.3 (VSS), NEO_4.3 (VSS), NEO_5.3 (VSS), NEO_6.3 (VSS), NEO_7.3 (VSS), NEO_8.3 (VSS), NEO_9.3 (VSS)
unnamed: NEO_1.4 (DIN), NEO_2.2 (DOUT)
unnamed: NEO_2.4 (DIN), NEO_6.2 (DOUT)
unnamed: NEO_3.2 (DOUT), NEO_4.4 (DIN)
unnamed: NEO_4.2 (DOUT), NEO_5.4 (DIN)
unnamed: NEO_5.2 (DOUT), NEO_9.4 (DIN)
unnamed: NEO_6.4 (DIN), NEO_7.2 (DOUT)
unnamed: NEO_7.4 (DIN), NEO_8.2 (DOUT)
unnamed: NEO_8.4 (DIN), NEO_9.2 (DOUT)
