Maritime-Hacking-Village/Badge-2025/KiCAD/DC33/nmea_modbus.kicad_sch

## KiCad design KiCAD/DC33/nmea_modbus.kicad_sch (2026-07-09)

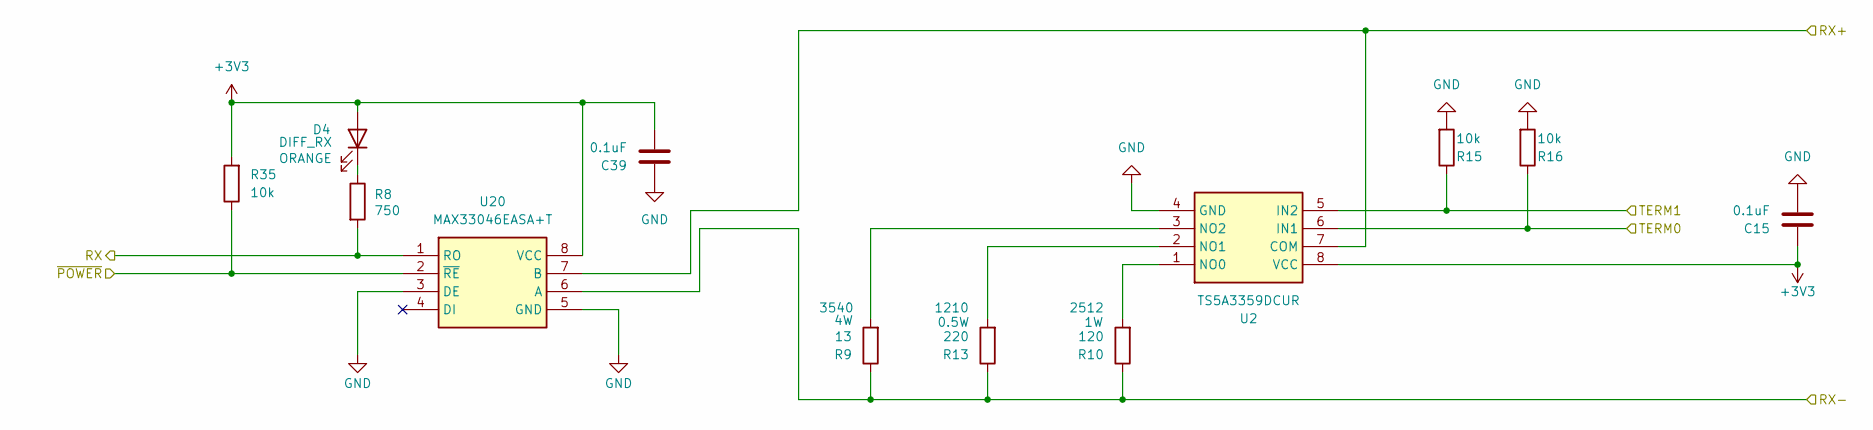
[picture p44: schematic nmea_modbus.kicad_sch]

Parts:
C15, C39: 0.1uF; C_0603_1608Metric; Manufacturer Part Number KGM15BR71E104KT
D4: 1.8V/2MA ORANGE; LED_0603_1608Metric; Manufacturer Part Number APT1608LSECK/J4-PRV
R8: 750; R_0603_1608Metric; Tolerance 1%; Manufacturer Part Number ERJ-3EKF7500V
R9: 13; RES_3540; Tolerance 1%; Manufacturer Part Number 354013RFT
R10: 120; R_2512_6332Metric; Tolerance 1%; Manufacturer Part Number RC2512FK-07120RL
R13: 220; R_1210_3225Metric; Tolerance 1%; Manufacturer Part Number RC1210FR-07220RL
R15, R16, R35: 10k; R_0603_1608Metric; Tolerance 1%; Manufacturer Part Number CRG0603F10K
U2: TS5A3359DCUR; SOP50P310X90-8N; Manufacturer Part Number TS5A3359DCUR
U20: MAX33046EASA+T; SOIC127P600X175-8N; Manufacturer Part Number MAX33046EASA+T

Connections:
+3V3: C15.1, C39.2, D4.2 (A), R35.2, U2.8 (VCC), U20.8 (VCC)
GND: C15.2, C39.1, R15.2, R16.2, U2.4 (GND), U20.3 (DE), U20.5 (GND)
unnamed: D4.1 (K), R8.1
unnamed: R9.2, U2.3 (NO2)
unnamed: R10.2, U2.1 (NO0)
unnamed: R13.2, U2.2 (NO1)
RX: R8.2, U20.1 (RO)
RX+: U2.7 (COM), U20.7 (B)
RX-: R9.1, R10.1, R13.1, U20.6 (A)
TERM0: R16.1, U2.6 (IN1)
TERM1: R15.1, U2.5 (IN2)
~POWER: R35.1, U20.2 (~RE)
