Maritime-Hacking-Village/Badge-2025/KiCAD/DC33/power.kicad_sch

## KiCad design KiCAD/DC33/power.kicad_sch (2026-07-09)

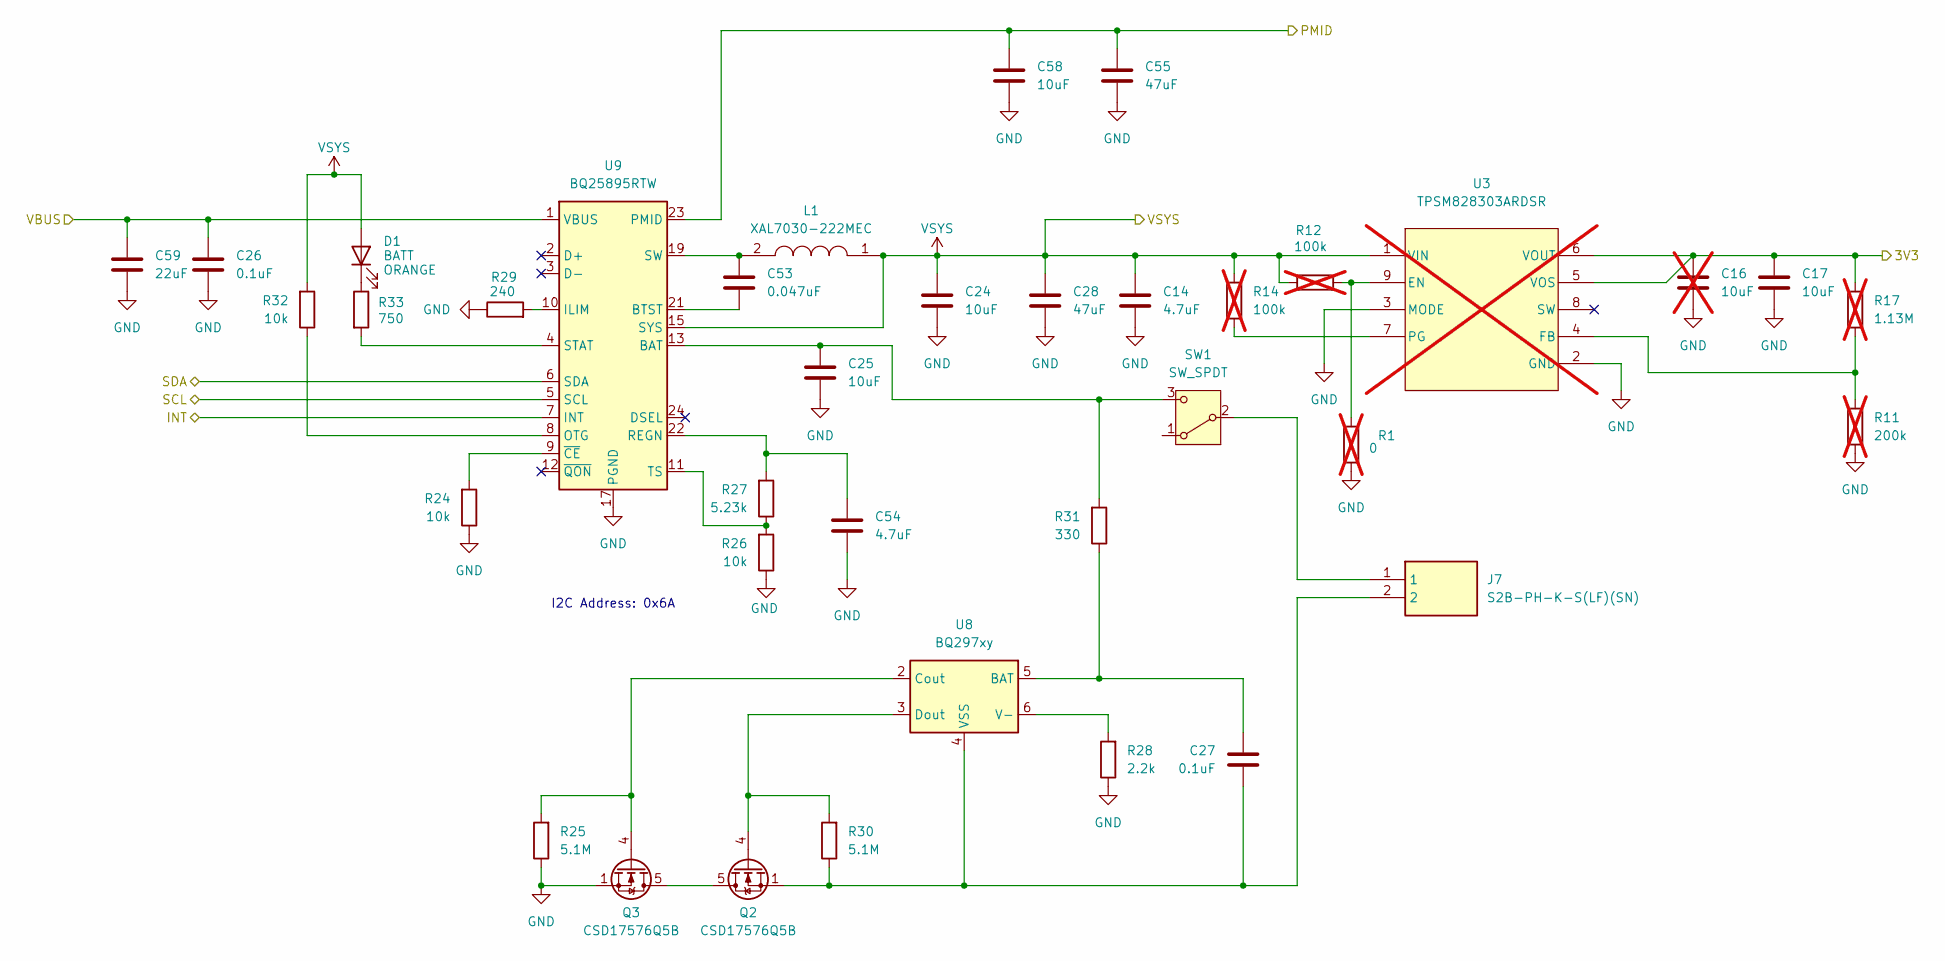
[picture p45: schematic power.kicad_sch]

Parts:
C14, C54: 4.7uF; C_0603_1608Metric; Manufacturer Part Number CGA3E1X5R0J475K080AC
C16: 10uF; C_0603_1608Metric; Manufacturer Part Number GRM188R61E106MA73J; not fitted
C17, C24, C25, C58: 10uF; C_0603_1608Metric; Manufacturer Part Number GRM188R61E106MA73J
C26, C27: 0.1uF; C_0603_1608Metric; Manufacturer Part Number KGM15BR71E104KT
C28, C55: 47uF; C_0603_1608Metric; Manufacturer Part Number 06036D476MAT2A
C53: 0.047uF; C_0603_1608Metric; Manufacturer Part Number CC0603KRX7R9BB473
C59: 22uF; C_0603_1608Metric; Manufacturer Part Number C1608X5R1A226M080AC
D1: 1.8V/2MA ORANGE; LED_0603_1608Metric; Manufacturer Part Number APT1608LSECK/J4-PRV
J7: S2B-PH-K-S(LF)(SN); SHDRRA2W50P0X200_1X2_590X760X480P; Manufacturer Part Number S2B-PH-K-S(LF)(SN)
L1: XAL7030-222MEC; XAL7030272MEB; Manufacturer Part Number XAL7030-222MEC
Q2, Q3: CSD17576Q5B; TDSON-8-1; Manufacturer Part Number CSD17576Q5B
R1: 0; R_0603_1608Metric; Tolerance 1%; Manufacturer Part Number ERJ-3GEY0R00V; not fitted
R11: 200k; R_0603_1608Metric; Tolerance 1%; Manufacturer Part Number ERJ-3EKF2003V; not fitted
R12, R14: 100k; R_0603_1608Metric; Tolerance 1%; Manufacturer Part Number ERJ-3EKF1003V; not fitted
R17: 1.13M; R_0603_1608Metric; Tolerance 1%; Manufacturer Part Number CRCW06031M13FKEA; not fitted
R24, R26, R32: 10k; R_0603_1608Metric; Tolerance 1%; Manufacturer Part Number CRG0603F10K
R25, R30: 5.1M; R_0603_1608Metric; Tolerance 1%; Manufacturer Part Number KTR03EZPF5104
R27: 5.23k; R_0603_1608Metric; Tolerance 1%; Manufacturer Part Number CRCW06035K23FKEA
R28: 2.2k; R_0603_1608Metric; Tolerance 1%; Manufacturer Part Number CRGCQ0603J2K2
R29: 240; R_0603_1608Metric; Tolerance 1%; Manufacturer Part Number RC0603FR-07240RL
R31: 330; R_0603_1608Metric; Tolerance 1%; Manufacturer Part Number RC0603FR-07330RL
R33: 750; R_0603_1608Metric; Tolerance 1%; Manufacturer Part Number ERJ-3EKF7500V
SW1: SW_SPDT
U3: TPSM828303ARDSR; RDS0009A-MFG; Manufacturer Part Number TPSM828303ARDSR; not fitted
U8: BQ297xy; WSON-6_1.5x1.5mm_P0.5mm; Manufacturer Part Number BQ29700DSER
U9: BQ25895RTW; Texas_RTW_WQFN-24-1EP_4x4mm_P0.5mm_EP2.7x2.7mm_ThermalVias; Manufacturer Part Number BQ25895RTWT

Connections:
3V3: C16.1, C17.1, R17.1, U3.5 (VOS), U3.6 (VOUT)
GND: C14.2, C16.2, C17.2, C24.2, C25.2, C26.2, C28.2, C54.2, C55.2, C58.2, C59.2, Q3.1 (S), Q3.2 (S), Q3.3 (S), R1.1, R11.2, R24.1, R25.1, R26.1, R28.1, R29.1, U3.2 (GND), U3.3 (MODE), U9.17 (PGND), U9.18 (PGND), U9.25 (PGND)
INT: U9.7 (INT)
unnamed: C25.1, R31.2, SW1.3 (C), U9.13 (BAT), U9.14 (BAT)
unnamed: C27.1, R31.1, U8.5 (BAT)
unnamed: C27.2, J7.2, Q2.1 (S), Q2.2 (S), Q2.3 (S), R30.1, U8.4 (VSS)
unnamed: C53.1, L1.2, U9.19 (SW), U9.20 (SW)
unnamed: C53.2, U9.21 (BTST)
unnamed: C54.1, R27.2, U9.22 (REGN)
unnamed: D1.1 (K), R33.1
unnamed: J7.1, SW1.2 (B)
unnamed: Q2.4 (G), R30.2, U8.3 (Dout)
unnamed: Q2.5 (D), Q3.5 (D)
unnamed: Q3.4 (G), R25.2, U8.2 (Cout)
unnamed: R1.2, R12.2, U3.9 (EN)
unnamed: R11.1, R17.2, U3.4 (FB)
unnamed: R14.2, U3.7 (PG)
unnamed: R24.2, U9.9 (~CE)
unnamed: R26.2, R27.1, U9.11 (TS)
unnamed: R28.2, U8.6 (V-)
unnamed: R29.2, U9.10 (ILIM)
unnamed: R32.1, U9.8 (OTG)
unnamed: R33.2, U9.4 (STAT)
PMID: C55.1, C58.1, U9.23 (PMID)
SCL: U9.5 (SCL)
SDA: U9.6 (SDA)
VBUS: C26.1, C59.1, U9.1 (VBUS)
VSYS: C14.1, C24.1, C28.1, D1.2 (A), L1.1, R12.1, R14.1, R32.2, U3.1 (VIN), U9.15 (SYS), U9.16 (SYS)

Notes on the sheet:
I2C Address: 0x6A
