Maritime-Hacking-Village/Badge-2025/KiCAD/DC33/voltage_refs.kicad_sch

## KiCad design KiCAD/DC33/voltage_refs.kicad_sch (2026-07-09)

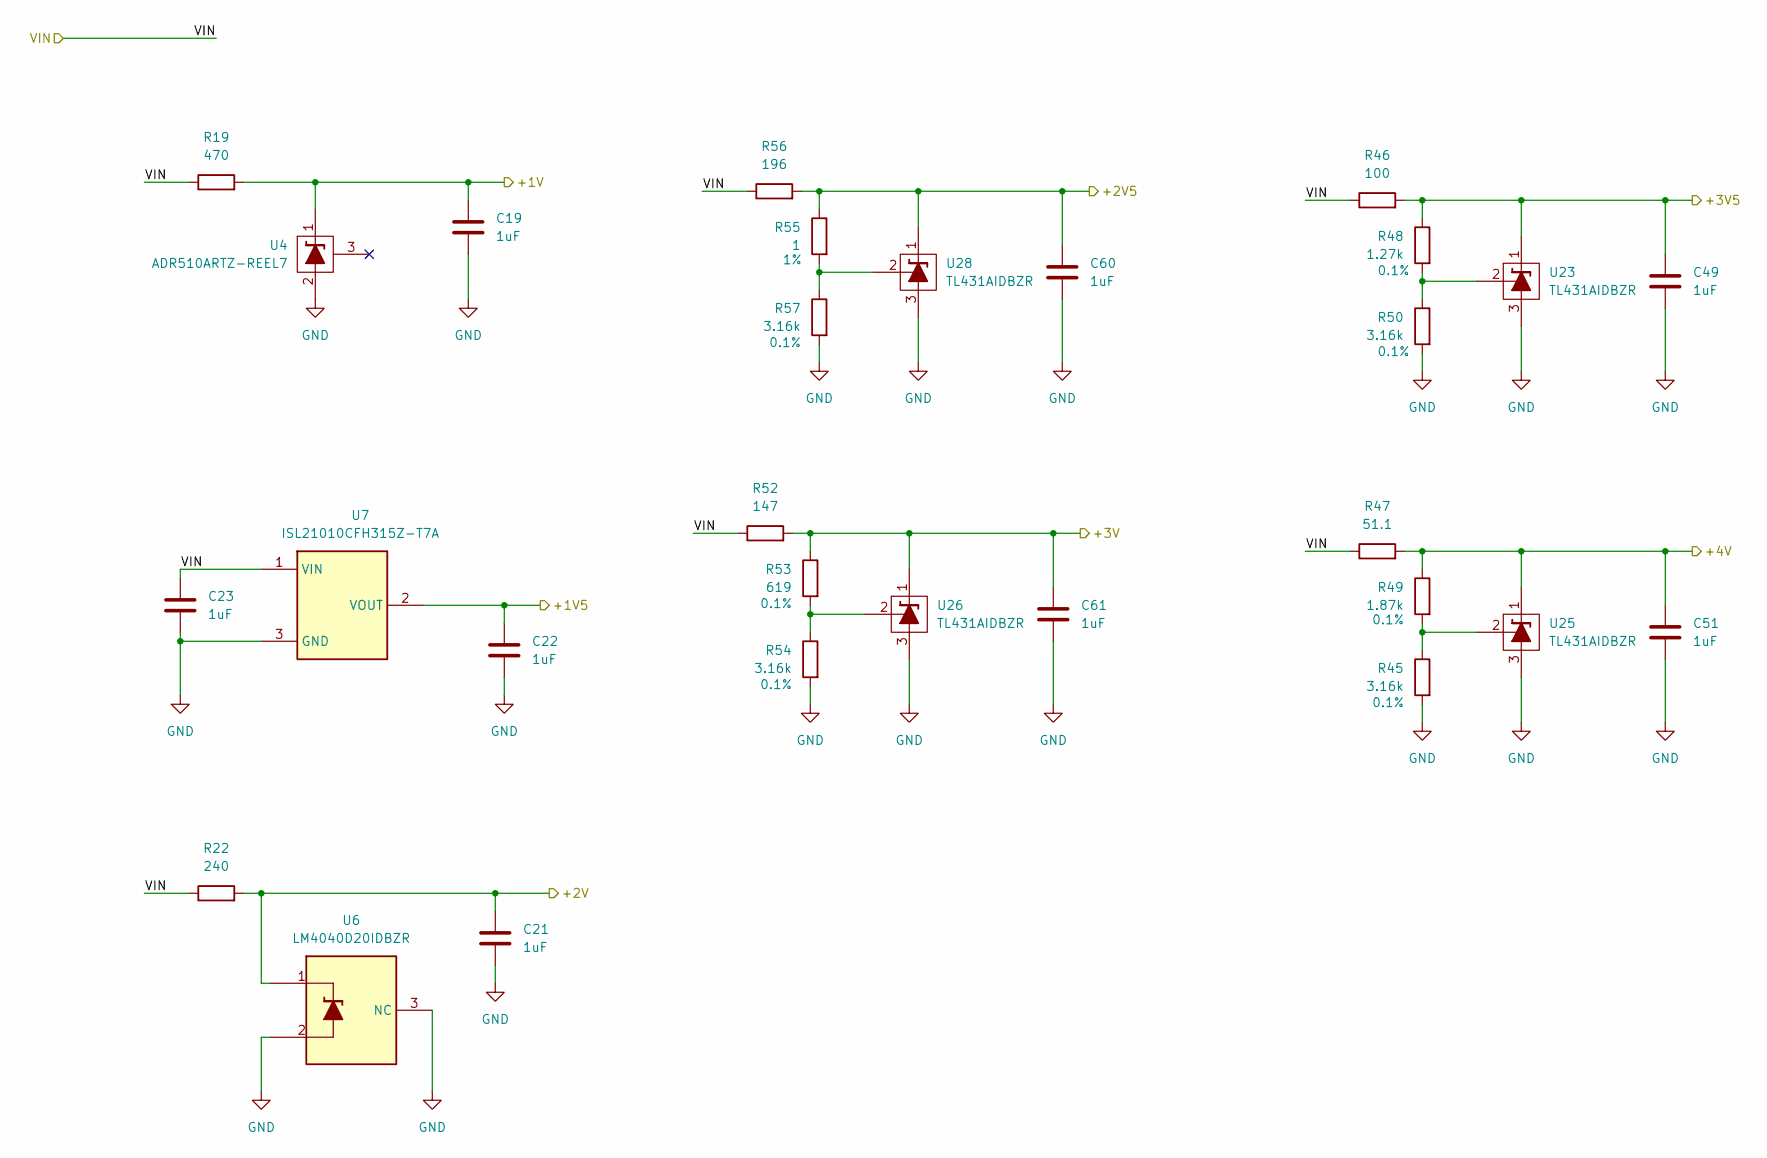
[picture p46: schematic voltage_refs.kicad_sch]

Parts:
C19, C21, C22, C23, C49, C51, C60, C61: 1uF; C_0603_1608Metric; Manufacturer Part Number CC0603KRX7R9BB105
R19: 470; R_0603_1608Metric; Tolerance 1%; Manufacturer Part Number ERJ-3GEYJ471V
R22: 240; R_0603_1608Metric; Tolerance 1%; Manufacturer Part Number RC0603FR-07240RL
R45, R50, R54, R57: 3.16k; R_0603_1608Metric; Tolerance 0.1%; Manufacturer Part Number ERA-3AEB3161V
R46: 100; R_0603_1608Metric; Tolerance 1%; Manufacturer Part Number ERJ-3EKF1000V
R47: 51.1; R_0603_1608Metric; Tolerance 1%; Manufacturer Part Number ERJ-3EKF51R1V
R48: 1.27k; R_0603_1608Metric; Tolerance 0.1%; Manufacturer Part Number ERA-3AEB1271V
R49: 1.87k; R_0603_1608Metric; Tolerance 0.1%; Manufacturer Part Number ERJ-PB3B1871V
R52: 147; R_0603_1608Metric; Tolerance 1%; Manufacturer Part Number ERJ-3EKF1470V
R53: 619; R_0603_1608Metric; Tolerance 0.1%; Manufacturer Part Number ERA-3AEB6190V
R55: 1; R_0603_1608Metric; Tolerance 1%; Manufacturer Part Number ERJ-3BQF1R0V
R56: 196; R_0603_1608Metric; Tolerance 1%; Manufacturer Part Number ERJ-3EKF1960V
U4: ADR510ARTZ-REEL7; SOT95P237X112-3N; Manufacturer Part Number ADR510ARTZ-REEL7
U6: LM4040D20IDBZR; SOT95P237X112-3N; Manufacturer Part Number LM4040D20IDBZR
U7: ISL21010CFH315Z-T7A; SOT95P237X112-3N-RENESAS; Manufacturer Part Number ISL21010CFH315Z-T7A
U23, U25, U26, U28: TL431AIDBZR; SOT95P237X112-3N; Manufacturer Part Number TL431AIDBZR

Connections:
+1V: C19.1, R19.2, U4.1
+1V5: C22.1, U7.2 (VOUT)
+2V: C21.1, R22.2, U6.1
+2V5: C60.1, R55.1, R56.2, U28.1
+3V: C61.1, R52.2, R53.1, U26.1
+3V5: C49.1, R46.2, R48.1, U23.1
+4V: C51.1, R47.2, R49.1, U25.1
GND: C19.2, C21.2, C22.2, C23.2, C49.2, C51.2, C60.2, C61.2, R45.2, R50.2, R54.2, R57.2, U4.2, U6.2, U6.3 (NC), U7.3 (GND), U23.3, U25.3, U26.3, U28.3
unnamed: R45.1, R49.2, U25.2
unnamed: R48.2, R50.1, U23.2
unnamed: R53.2, R54.1, U26.2
unnamed: R55.2, R57.1, U28.2
VIN: C23.1, R19.1, R22.1, R46.1, R47.1, R52.1, R56.1, U7.1 (VIN)
