Maritime-Hacking-Village/Badge-2025/firmware/firmware/src/apps/mod.rs

pub mod console;
pub mod display;
pub mod logging;
pub mod neopixel;
pub mod rhai_repl;
pub mod rx;
pub mod scrolling_console;
pub mod tx;
pub mod usb_cli;
#[cfg(feature = "wifi")]
pub mod wifi_tcp_cli;
