Maritime-Hacking-Village/Badge-2025/firmware/firmware/src/platform/mod.rs

pub mod async_io_on_sync_io;
pub mod bq25895;
pub mod cropped_wrapped_converted_draw_target;
pub mod cropped_wrapped_draw_target;
pub mod flushing_display;
pub mod i2c_io_expander;
pub mod interrupt_i2c;
pub mod irqs;
pub mod locking_spi_bus;
pub mod mc3479;
pub mod mcp2518;
pub mod msc;
pub mod multi_write;
pub mod neopixel;
#[cfg(feature = "wifi")]
pub mod net_stack;
pub mod picotool;
#[cfg(feature = "heap-in-psram")]
pub mod psram;
pub mod repl;
pub mod sdcard;
pub mod sdmmc;
pub mod set_frequency;
pub mod set_frequency_spi;
pub mod shared_spi_bus;
pub mod sync_write_on_async;
pub mod usb;
pub mod usb_cdc_io;
pub mod util;
pub mod vertical_scrolling;
#[cfg(feature = "wifi")]
pub mod wifi;
