Maritime-Hacking-Village/Badge-2025/firmware/firmware/src/platform/picotool.rs

// Program metadata for `picotool info`.
// This isn't needed, but it's recomended to have these minimal entries.
#[link_section = ".bi_entries"]
#[used]
pub static PICOTOOL_ENTRIES: [embassy_rp::binary_info::EntryAddr; 4] = [
    embassy_rp::binary_info::rp_program_name!(c"MHV DC33 Badge"),
    embassy_rp::binary_info::rp_program_description!(c"Maritime Protocols Experimentation"),
    embassy_rp::binary_info::rp_cargo_version!(),
    embassy_rp::binary_info::rp_program_build_attribute!(),
];
