Maritime-Hacking-Village/Badge-2025/firmware/firmware/src/platform/sdmmc/card_type.rs

#[derive(Copy, Clone, Debug)]
pub enum CardType {
    SDSC(u8),
    SDHC,
}

impl CardType {
    pub fn high_capacity(self) -> bool {
        match self {
            Self::SDSC(_) => false,
            _ => true,
        }
    }
}
