Maritime-Hacking-Village/Badge-2025/firmware/firmware/src/platform/set_frequency_spi.rs

use embassy_rp::spi::Config;

use crate::platform::set_frequency::SetFrequency;

impl SetFrequency for Config {
    fn set_frequency(&mut self, frequency: u32) {
        self.frequency = frequency
    }
}
