Maritime-Hacking-Village/Badge-2025/(commit log)

2026-07-09 power switch
    [DC33.kicad_sch, can_injector.kicad_sch, can_trx.kicad_sch, display_sd.kicad_sch, gpio_buttons.kicad_sch, neopixel.kicad_sch, nmea_modbus.kicad_sch, power.kicad_sch]
2026-07-09 schematic fixes R-2R DAC
    [can_injector.kicad_sch]
